supachokchujai/glove-sign-languag-/thesis.pdf

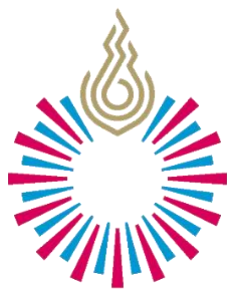
[picture p7: figure]

### ถุงมือแปลภาษามือ (ข้างเดียว) (SINGLE-HAND SIGN LANGUAGE TRANSLATOR GLOVE)

### โดย นาย ศุภโชค ชูใจ

### ปริญญานิพนธ์นี้เป็นส่วนหนึ่งของการศึกษาตามหลักสูตร วิศวกรรมศาสตรบัณฑิต สาขาวิชาวิศวกรรมคอมพิวเตอร์ วิทยาลัยวิศวกรรมศาสตร์ มหาวิทยาลัยรังสิต ปีการศึกษา 2568

ปริญญานิพนธ์เรื่อง
ถุงมือแปลภาษามือ (ข้างเดียว) (SINGLE-HAND SIGN LANGUAGE TRANSLATOR GLOVE)

โดย
นาย ศุภโชค ชูใจ 6505918

ได้รับการพิจารณาให้เป็นส่วนหนึ่งของการศึกษาตามหลักสูตร วิศวกรรมศาสตรบัณฑิต สาขาวิชาวิศวกรรมคอมพิวเตอร์ วิทยาลัยวิศวกรรมศาสตร์ มหาวิทยาลัยรังสิต ปีการศึกษา 2568

| ประธานกรรมการ
(ดร. ชนินท์ วงษ์ใหญ่)
| กรรมการ
(รศ.ดร. รง ภู่พวงไพโรจน์)
| กรรมการและอาจารย์ที่ปรึกษา
(ดร. อภิรักษ์ ภักดีวงษ์)

(ดร. ชนินท์วงษ์ใหญ่)
หัวหน้าหลักสูตรวิศวกรรมศาสตรบัณฑิต สาขาวิชาวิศวกรรมคอมพิวเตอร์
วันที่ | เดือน | พ.ศ |

### ถุงมือแปลภาษามือ (ข้างเดียว) (SINGLE-HAND SIGN LANGUAGE TRANSLATOR GLOVE)

### โดย นาย ศุภโชค ชูใจ 6505918

### ปริญญานิพนธ์นี้เป็นส่วนหนึ่งของการศึกษาตามหลักสูตร วิศวกรรมศาสตรบัณฑิต สาขาวิชาวิศวกรรมคอมพิวเตอร์ วิทยาลัยวิศวกรรมศาสตร์ มหาวิทยาลัยรังสิต ปีการศึกษา 2568

ข

ชื่อ | : นาย ศุภโชค ชูใจ | รหัส : 6505918
เรื่อง | : ถุงมือแปลภาษามือ (ข้างเดียว)
อาจารย์ที่ปรึกษา | : ดร. อภิรักษ์ ภักดีวงษ์, 134 หน้า
ค าส าคัญ | : ถุงมือแปลภาษามือ, ปัญญาประดิษฐ์, โครงข่ายประสาทเทียม, อีเอสพี32,
| ภาษามืออเมริกัน,

บทคัดย่อ

การสื่อสารที่ยากล าบากระหว่างผู้พิการทางการได้ยิน ไม่สามารถสื่อสารกับบุคคลทั่วไปได้ส่งผล กระทบโดยตรงต่อการด าเนินชีวิตและการเข้าสังคม ปริญญานิพนธ์ฉบับนี้จึงเสนอการออกแบบและ พัฒนา ถุงมืออัจฉริยะส าหรับแปลภาษามือแบบข้างเดียว ซึ่งเป็นอุปกรณ์อ านวยความสะดวกที่พัฒนาบน พื้นฐานของปัญญาประดิษฐ์ เพื่อมุ่งเน้นการใช้งานจริงและช่วยลดอุปสรรคด้านการสื่อสารให้แก่ผู้ใช้งาน ได้อย่างมีประสิทธิภาพ
ถุงมือแปลภาษามือ (ข้างเดียว) สามารถจ าแนกท ่าทางภาษามืออเมริกันตัวอักษร A ถึง Z รวมถึงค าศัพท์ที่ใช้บ่อยอย่าง Hello, Thank you, I love you, Yes และ No และแสดงผลเป็นข้อความ บนเว็บแอปพลิเคชัน ระบบการท างานของ ถุงมือแปลภาษามือข้างเดียว ใช้ไมโครคอนโทรลเลอร์ ESP32 อ่านค่าจากเซนเซอร์ตรวจจับการโค้งงอของนิ้วมือ ร่วมกับเซนเซอร์ MPU6050 ที่วัดความเร่งและองศา การหมุนบริเวณข้อมือ และส่งข้อมูลแบบไร้สายผ่านโปรโตคอล UDP ในรูปแบบ JSON ขนาด 60 เฟรม ต่อท่าทาง ข้อมูลจะถูกประมวลผลด้วยโครงข่ายประสาทเทียมหลายชั้น (Multi-Layer Perceptron) ที่ สร้างขึ้นด้วยไลบรารี Scikit-learn และส่งผลลัพธ์ไปแสดงผลผ่านเฟรมเวิร์ก Flask
จากการทดลองสามารถจ าแนกท่าทางภาษามือได้จริง โดยทดสอบท าท่าทางแต่ละรูปแบบซ ้า รูปแบบละ 30 ครั้ง เพื่อน าผลลัพธ์การทดสอบทั้งหมดมาประมวลผลและค านวณหาค่าความแม่นย าเฉลี่ย ซึ่งพบว่าระบบมีความแม่นย าในการจ าแนกท่าทางภาษามือเฉลี่ยคิดเป็นร้อยละ 96.02 อีกทั้งตัวระบบยัง สามารถตอบสนองต่อการเคลื่อนไหวได้อย่างรวดเร็ว มีความหน่วงเวลาต ่า และสามารถแปลสัญลักษณ์ ภาษามือออกมาเป็นข้อความแสดงผลบนหน้าจอเว็บแอปพลิเคชันได้อย่างราบรื่นและถูกต้อง ซึ่งแสดงให้ เห็นว่าระบบถุงมืออัจฉริยะที่พัฒนาขึ้น นี้มีความเสถียรและมีความพร้อมสูงในการน าไปประยุกต์ใช้งาน จริงในเชิงสังคม เหมาะส าหรับการน าไปพัฒนาต่อยอดเพื่อใช้งานจริงต่อไป

ค

Name | : Mr. Supachok Chujai | ID : 6505918
Title | : Single-Hand Sign Language Translator Glove
Advisor | : Apirak Pakdeewong, 134 Pages
Keywords | : Sign Language Translation Glove, Artificial Intelligence,
Neural Network, ESP32, American Sign Language

Abstract

The communication barrier faced by individuals with hearing impairments in interacting with the general public directly affects their daily life and social participation. This thesis therefore proposes the design and development of a Smart Glove for Single-Hand Sign Language Translation, an assistive device built on artificial intelligence, aimed at practical real-world application and effectively reducing communication barriers for users.
The single-hand sign language translation glove is capable of classifying American Sign Language gestures for letters A through Z, as well as frequently used words such as "Hello," "Thank you," "I love you," "Yes," and "No," and displaying the results as text on a web application. The system operates using an ESP32 microcontroller to read data from flex sensors that detect finger bending, together with an MPU6050 sensor that measures wrist acceleration and rotational angle. Data is transmitted wirelessly via the UDP protocol in JSON format, consisting of 60 frames per gesture. The collected data is then processed using a Multi-Layer Perceptron (MLP) neural network built with the Scikit-learn library, and the resulting output is displayed through the Flask framework. Experimental results demonstrate that the system can accurately classify real sign language gestures. Each gesture was tested 30 times, and the results were aggregated to calculate the average accuracy, which was found to be 96.02%. Furthermore, the systemresponds to hand movements quickly with low latency and is able totranslate sign language symbols into text displayed on the web application smoothly and accurately. These results indicate that the developed smart glove system is stable and ready for practical, real-world social application, and is well-suited for further development toward actual deployment.

ง

กิตติกรรมประกาศ

ปริญญานิพนธ์ฉบับนี้ส าเร็จลุล่วงได้ด้วยความอนุเคราะห์และการสนับสนุนจากบุคคลหลาย ฝ่าย คณะผู้จัดท าขอขอบคุณคณะกรรมการสอบปริญญานิพนธ์ทุกท่าน รวมถึงคณาจารย์ในภาควิชา วิศวกรรมคอมพิวเตอร์ที่ได้กรุณาให้แนวทาง ค าแนะน า และข้อเสนอแนะอันเป็นประโยชน์ในการ ปรับปรุงปริญญานิพนธ์ฉบับนี้ให้มีความสมบูรณ์ยิ่งขึ้น
ขอขอบคุณ ดร.อภิรักษ์ ภักดีวงษ์อาจารย์ที่ปรึกษาปริญญานิพนธ์ ที่ได้กรุณาให้ค าแนะน า และข้อเสนอแนะอย่างใกล้ชิดตลอดระยะเวลาการด าเนินงาน ทั้งในด้านแนวคิดของโครงงาน การ ออกแบบและพัฒนาระบบ รวมถึงการจัดท ารูปเล่มปริญญานิพนธ์ให้เป็นไปตามมาตรฐานที่ก าหนด ขอขอบคุณ รศ.ดร. ดวงอาทิตย์ศรีมูล ที่ให้ค าแนะน าด้านการต่อวงจร ขอขอบคุณครอบครัวและญาติมิตรทุกท่าน ที่ได้ให้ค าแนะน าต่างๆในการท างาน
ขอขอบคุณ กลุ่มฐานแฟนคลับนายศิวะ ชมแสงสีเสียง เพื่อนผู้คอยให้ก าลังใจและดูแลเอาใจ ใส่ตลอดระยะเวลาการจัดท าปริญญานิพนธ์ฉบับนี้

ศุภโชค ชูใจ
ผู้เขียน

จ

สารบัญ

หน้า
บทคัดย่อภาษาไทย | ข
บทคัดย่อภาษาอังกฤษ | ค
กิตติกรรมประกาศ | ง
สารบัญ | จ
สารบัญตาราง | ฎ
สารบัญรูป | ฐ

ฉ

สารบัญ (ต่อ)

บทที่ 2 (ต่อ) | หน้า

2.1.4 การจ าแนกประเภทท่าทางในโครงงาน (Classification of Gestures) .........8

ช

สารบัญ (ต่อ)

บทที่ 2 (ต่อ) | หน้า

ซ

สารบัญ (ต่อ)

บทที่ 2 (ต่อ) | หน้า

ฌ

สารบัญ (ต่อ)

บทที่ 3 (ต่อ) | หน้า

ญ

สารบัญ (ต่อ)

บรรณานุกรม | 123
ภาคผนวก ก.โค้ดการเทรนการแปลภาษามือ | 124
ข.โค้ดการท างานของแอปพิเคชั่นท านายผลภาษามือ | 126
ค.โค้ดการเทรนการส่งข้อมูล | 128
ง.โค้ดการเทรนการเก็บข้อมูล | 132
ประวัติผู้เขียน | 134

ฎ

สารบัญตาราง

หน้า
ตารางที่
1.1 รายชื่ออุปกรณ์ | 4
1.2 แผนการด าเนินงานและระยะในการปฏิบัติงาน | 5
2.1 ภาษามือและการสะกดนิ้วมือ | 10
3.1 รายละเอียดขาของ Flex Sensor | 56
3.2 รายละเอียดขาของ MPU 6050 | 56
3.3 โครงสร้างชุดข้อมูล | 62
3.4 รูปแบบการเก็บข้อมูล Flex Sensor | 66
3.5 รูปแบบการเก็บข้อมูลความเร่ง Accelerometer ของ MPU6050 | 68
3.6 รูปแบบการเก็บข้อมูลความเร็วเชิงมุม Gyroscope ของ MPU6050 | 69
4.1 ผลการทดสอบการแปลตัวอักษร A | 88
4.2 ผลการทดสอบการแปลตัวอักษร B | 89
4.3 ผลการทดสอบการแปลตัวอักษร C | 89
4.4 ผลการทดสอบการแปลตัวอักษร D | 90
4.5 ผลการทดสอบการแปลตัวอักษร E | 91
4.6 ผลการทดสอบการแปลตัวอักษร F | 91
4.7 ผลการทดสอบการแปลตัวอักษร G | 92
4.8 ผลการทดสอบการแปลตัวอักษร H | 93
4.9 ผลการทดสอบการแปลตัวอักษร I | 93
4.10 ผลการทดสอบการแปลตัวอักษร J | 94
4.11 ผลการทดสอบการแปลตัวอักษร K | 95
4.12 ผลการทดสอบการแปลตัวอักษร L | 95
4.13 ผลการทดสอบการแปลตัวอักษร M | 96
4.14 ผลการทดสอบการแปลตัวอักษร N | 97
4.15 ผลการทดสอบการแปลตัวอักษร O | 97
4.16 ผลการทดสอบการแปลตัวอักษร P | 98
4.17 ผลการทดสอบการแปลตัวอักษร Q | 99

ฏ

สารบัญตาราง (ต่อ)

หน้า
ตารางที่
4.18 ผลการทดสอบการแปลตัวอักษร R | 99
4.19 ผลการทดสอบการแปลตัวอักษร S | 100
4.20 ผลการทดสอบการแปลตัวอักษร T | 101
4.21 ผลการทดสอบการแปลตัวอักษร U | 101
4.22 ผลการทดสอบการแปลตัวอักษร V | 102
4.23 ผลการทดสอบการแปลตัวอักษร W | 103
4.24 ผลการทดสอบการแปลตัวอักษร X | 103
4.25 ผลการทดสอบการแปลตัวอักษร Y | 104
4.26 ผลการทดสอบการแปลตัวอักษร Z | 105
4.27 ผลการทดสอบการแปลค าว่า Hello | 105
4.28 ผลการทดสอบการแปลค าว่า Thank you | 106
4.29 ผลการทดสอบการแปลตัวอักษร I love you | 107
4.30 ผลการทดสอบการแปลค าว่า Yes | 107
4.31 ผลการทดสอบการแปลค าว่า No | 108
4.32 ผลการแสดงการจ าแนกท่าทาง | 109

ฐ

สารบัญรูป

หน้า
รูปที่
2.1 การสะกดนิ้วมือ | 8
2.2 ท่าทางแบบหยุดนิ่ง | 9
2.3 ท่าทางแบบเคลื่อนไหว | 9
2.4 ต าแหน่ง PIN ESP32 | 17
2.5 โครงสร้างของ Flexsensor | 18
2.6 ทิศทางการหมุนของ MPU6050 | 20
2.7 โครงสร้าง UDP | 24
2.8 เปรียบเทียบ AI, Machine Learning, Deep Learning | 26
2.9 การน า AI มาใช้ในด้านอุตสาหกรรม | 29
2.10 การเรียนรู้ของ Machine Learning | 31
2.11 การเรียนรู้ของ Deep Learning | 32
2.12 โครงข่ายประสาทเทียม | 33
2.13 โครงสร้าง MLP | 33
2.14 Backpropagation | 34
2.15 การติดตั้ง Arduino IDE | 38
2.16 การเลือกโฟลเดอร์ที่จะใช้เก็บไฟล์ | 39
2.17 การติดตั้ง Arduino IDE | 39
2.18 การติดตั้ง Arduino IDE สมบูรณ์ | 40
2.19 หน้าต่าง Arduino IDE | 40
2.20 การติดตั้ง Visual Studio Code | 41
2.21 การเลือกโฟลเดอร์ที่จะใช้เก็บไฟล์ | 42
2.22 โฟลเดอร์เมนู Start ส าหรับโค้ด Visual Studio | 42
2.23 ก าหนดค่าการติดตั้ง | 43
2.24 ยืนยันการติดตั้ง | 43
2.25 การติดตั้ง Visual Studio | 44
2.26 การติดตั้ง Visual Studio สมบูรณ์ | 44

ฑ

สารบัญรูป (ต่อ)

หน้า
รูปที่
2.27 หน้าต่าง Visual Studio Code | 45
2.28 ตัวอย่างการใช้งาน Python | 46
2.29 ติดตั้ง Numpy | 46
2.30 เรียกใช้Numpy | 47
2.31 ตัวอย่างการใช้งาน Numpy | 47
2.32 ติดตั้ง Flask | 47
2.33 เรียกใช้งาน Flask | 47
2.34 ตัวอย่างการใช้งาน Flask | 48
2.35 ติดตั้ง Scikit learn | 48
2.36 เรียกใช้Scikit learn | 48
2.37 ตัวอย่างการใช้งาน Scikit learn | 48
2.38 ติดตั้ง Pandas | 49
2.39 เรียกใช้Pandas | 49
2.40 ตัวอย่างการใช้งาน Pandas | 50
2.41 ติดตั้ง Socket Library | 50
2.42 เรียกใช้Socket | 50
2.43 ตัวอย่างการใช้งาน Socket | 51
2.44 ตัวอย่างโค้ดของ Client | 51
2.45 Server | 52
2.46 Client | 52
3.1 การออกแบบวงจร | 55
3.2 Flowchart การท างานของระบบ | 57
3.3 Flex Sensor | 58
3.4 MPU 6050 | 59
3.5 ESP32 | 59
3.6 การติดตั้ง Flex Sensor | 60

ฒ

สารบัญรูป (ต่อ)

หน้า
รูปที่
3.7 ติดตั้ง ESP32 และ MPU6050 ลงบนบอร์ด | 60
3.8 บัดกรีอุปกรณ์ทั้งหมด | 61
3.9 ขั้นตอนการเก็บข้อมูล | 64
3.10 โค้ดตั้งค่า UDP | 64
3.11 โค้ดล้าง Buffer | 65
3.12 โค้ดรวบรวมข้อมูล | 65
3.13 โค้ดการจัดเก็บข้อมูล | 65
3.14 Flowchart การเทรนโมเดล | 72
3.15 โครงสร้างโมเดล | 73
3.16 โค้ดส าหรับน าเข้าไลบรารี | 74
3.17 โค้ดการก าหนดข้อมูลน าเข้า | 75
3.18 โค้ดจัดรูปแบบข้อมูลให้พร้อมส าหรับการเทรน | 75
3.19 โค้ดการแบ่งข้อมูลเป็น Train และ Test | 76
3.20 โค้ดส าหรับการปรับสเกล | 77
3.21 โค้ดส าหรับการสร้างโมเดล | 77
3.22 เป็นโค้ดสร้างแผนภาพ Confusion Matrix | 78
3.23 กราฟประเมิน (Confusion Matrix) | 79
3.24 โค้ดส าหรับการบันทึกโมเดล | 80
3.25 ไฟล์ที่ได้จากการเทรน | 80
3.26 โค้ดส าหรับน าเข้าไลบรารี | 81
3.27 โค้ดส าหรับก าหนดตัวแปร | 82
3.28 โค้ดส าหรับการโหลดโมเดล | 82
3.29 โค้ดส าหรับก าหนดรูปแบบของ Template | 83
3.30 โค้ดส าหรับสร้างช่องทางรับข้อมูลจาก ESP32 | 83
3.31 โค้ดส าหรับรับและแปลงข้อมูล | 84
3.32 โค้ดส าหรับการท านายผลลัพธ์ | 84

ณ

สารบัญรูป (ต่อ)

หน้า
รูปที่
4.1 ถุงมือต้นแบบที่พัฒนาขึ้น | 87
4.2 หน้าต่าง Web Application | 87

บทที่1
บทน า

### 1.1 ที่มาและความส าคัญของปัญหา

การสื่อสารเป็นปัจจัยพื้นฐานที่ส าคัญในการด ารงชีวิตและการอยู่ร่วมกันในสังคม อย่างไรก็ตาม ผู้ ที่มีความบกพร่องทางการได้ยินหรือการพูด (Deaf and Hard of Hearing Community) จะประสบ ปัญหาและอุปสรรคในการสื่อสารร่วมกับบุคคลในสังคมเนื่องจากความแตกต่างทางภาษา โดยภาษามือ (Sign Language) ซึ่งเป็นเครื่องมือหลักในการสื่อสารของพวกเขานั้น ไม่เป็นที่เข้าใจอย่างแพร่หลายใน บุคคลทั่วไป ส่งผลให้เกิดช่องว่างในการสื่อสาร การเข้าถึงบริการสาธารณะ และโอกาสในการประกอบ อาชีพ การพึ่งพาล ่ามภาษามือนั้นมีข้อจ ากัดทั้งในด้านค่าใช้จ่ายและความไม ่สะดวกในการเรียกใช้ บริการในสถานการณ์เร่งด่วน
ในปัจจุบัน เทคโนโลยีสิ่งอ านวยความสะดวก (Assistive Technology) ได้เข้ามามีบทบาทในการ แก้ปัญหานี้ งานวิจัยส่วนใหญ่นิยมใช้เทคโนโลยีคอมพิวเตอร์วิทัศน์ (Computer Vision) ผ่านกล้อง เพื่อแปลภาษามือ แต่มีข้อจ ากัดเรื่องสภาพแสง มุมกล้อง และความเป็นส่วนตัว ในขณะที่เทคโนโลยี อุปกรณ์สวมใส ่ (Wearable Device) เช ่น ถุงมืออัจฉริยะ (Smart Glove) สามารถตรวจจับการ เคลื ่อนไหวของนิ้วมือได้โดยตรงและมีความแม่นย าสูงกว่าในสภาพแวดล้อมที ่หลากหลาย แต ่ทว่า อุปกรณ์ที่มีอยู่ในท้องตลาดหรือในงานวิจัยเดิมจะมีการเชื่อมต่อแบบมีสาย (Wired) ซึ่งจ ากัดระยะการ เคลื่อนไหว หรือมีต้นทุนในการผลิตสูง
จากปัญหาดังกล่าว คณะผู้จัดท าจึงมีแนวคิดที่จะพัฒนา "ระบบแปลภาษามือเป็นข้อความและ เสียงแบบไร้สายโดยใช้โครงข่ายประสาทเทียม" โดยประยุกต์ใช้ไมโครคอนโทรลเลอร์ ESP32 ที่มีราคา ประหยัดและรองรับการเชื ่อมต ่อไร้สาย (Wi-Fi) ร ่วมกับเซนเซอร์ตรวจจับการงอของนิ้ว (Flex Sensors) และเซนเซอร์ตรวจจับการเคลื่อนไหว (IMU) ข้อมูลจากถุงมือจะถูกส่งผ่านโปรโตคอล UDP ไปยังคอมพิวเตอร์เพื่อประมวลผลด้วยโมเดลปัญญาประดิษฐ์แบบโครงข่ายประสาทเทียมหลายชั้น (Multi-layer Perceptron) ที่พัฒนาด้วย Scikit-learn และแสดงผลการแปลผ่านเว็บแอปพลิเคชัน เพื่อสร้างต้นแบบนวัตกรรมที่ช่วยลดช่องว่างในการสื่อสาร ใช้งานสะดวก และมีประสิทธิภาพ

2

### 1.2 วัตถุประสงค์โครงงาน

1. เพื่อพัฒนา ถุงมือแปลภาษามือ ที่สามารถตรวจจับการเคลื่อนไหวของมือและนิ้ว
2. เพื ่อพัฒนาโมเดลปัญญาประดิษฐ์ (AI) ประเภทโครงข ่ายประสาทเทียม (Multi-layer Perceptron Classifier) ส าหรับจ าแนกท่าทางภาษามือจากข้อมูลเซนเซอร์
3. เพื่อเป็นเครื่องมือช่วยสื่อสารระหว่างผู้พิการทางการได้ยินกับบุคคลทั่วไป ลดช่องว่างทางการ สื่อสาร
4. เพื่อพัฒนาระบบแสดงผลผ่านเว็บแอปพลิเคชันที่สามารถแสดงผลลัพธ์การแปลเป็นข้อความได้

### 1.3 ขอบเขตโครงงาน

1. ใช้บอร์ดไมโครคอนโทรลเลอร์ESP32 เป็นตัวส่งข้อมูล
2. ใช้Flex Sensors จ านวน 5 ชิ้น เพื่อวัดค่าการงอของนิ้วมือทั้ง 5 นิ้ว
3. ใช้เซนเซอร์MPU6050 (Accelerometer & Gyroscope) จ านวน 1 ชิ้น เพื่อวัดระนาบและ การเคลื่อนไหวของข้อมือ
4. ใช้Flask ส าหรับพัฒนาเว็บและแสดงผลโดยมีตัวควบคุมในการกดแปล
5. รองรับเฉพาะท่าทางมือเดียว ได้แก่ A-Z และค าศัพท์ (Hello,Thank you, I love you,Yes ,no)
6. สามารถท านายผลท่าทางภาษามือจากค่า Flex sensorและ MPU 6050 โดยใช้MLP

### 1.4 ประโยชน์และการน าไปใช้งาน

1. ช่วยให้ผู้พิการทางการได้ยินและการพูดสามารถ สื่อสารกับบุคคลทั่วไปได้สะดวกและรวดเร็วขึ้น
2. ลดความเข้าใจผิดและอุปสรรคด้านการสื่อสาร ท าให้เกิด ความเท่าเทียมในสังคม
3. เป็นสื่อการเรียนรู้ภาษามือส าหรับบุคคลทั่วไปที่ต้องการเรียนรู้การสื่อสารกับผู้พิการ
4. ใช้ใน สถานศึกษา เพื่อช่วยนักเรียน/นักศึกษาที่มีความบกพร่องทางการได้ยินในการเรียน ร่วมกับบุคคลทั่วไป
5. สามารถพัฒนาต่อยอดเป็น แอปพลิเคชันบนมือถือ ที่เชื่อมต่อกับถุงมือ เพื่อเพิ่มความสะดวก และรองรับหลายภาษา

### 1.5 อุปกรณ์ที่ใช้งานและงบประมาณ

### 1.5.1 Hardware

- Notebook Asus TUF Gaming F17 / Intel Core i5-11400H / NVIDIA GeForce RTX 3050 / RAM 8GB DDR4 / SSD 512GB

3

- ESP 32 Microcontroller ใช้ส าหรับประมวลผลข้อมูลของเซ็นเซอร์และสื่อสารกับ คอมพิวเตอร์ด้วย WiFi
- Flex sensors 2.2" ใช้ตรวจวัดการงอของนิ้วมือ
- MPU6050 ใช้ส าหรับก าหนดต าแหน่งของมือ
- ถุงมือ
- สายจัมเปอร์
- ตัวต้านทาน 10 kΩ

### 1.5.2 Software

- Visual Studio Code ในการเขียนและออกแบบหน้า UI ของเว็บ ภาษา Python
- ภาษาโปรแกรม Python ส าหรับเขียนชุดค าสั่งควบคุมระบบ และใช้พัฒนาแอปพลิเค ชันร่วมกับระบบแสดงผล
- Pandas เป็นไลบรารีในภาษา Python ที่ใช้ส าหรับการจัดการและวิเคราะห์ข้อมูลใน รูปแบบของตารางหรือ DataFrame
- NumPy ไลบรารีโอเพนซอร์สใน Python ที ่ใช้ส าหรับการค านวณทางคณิตศาสตร์ และการจัดการข้อมูลเชิงตัวเลข ในการหางานกับอาร์เรย์หลายมิติและเมทริกซ์
- Arduino IDE คือโปรแกรมพัฒนาและอัปโหลดโค้ดไปยัง microcontroller โดย รองรับภาษา C/C++ และออกแบบมาเพื่อใช้งานด้านไมโครคอนโทรลเลอร์
- CSS ในก าหนดรูปแบบการแสดงผลของหน้าเว็บ เช ่น สี ตัวอักษร และการจัดวาง องค์ประกอบ
- HTML ส าหรับสร้างและจัดโครงสร้างเนื้อหาบนหน้าเว็บเพจ
- Scikit-learn เป็นไลบรารีของภาษา Python ส าหรับการเรียนรู้ของเครื ่อง ที ่รวม เครื่องมือส าหรับการจ าแนก การถดถอย การจัดกลุ่ม และการประเมินโมเดล
- Neural Network เป็นอัลกอริทึมการเรียนรู้ของเครื่องที่ใช้ส าหรับการจ าแนกข้อมูล โดยหาขอบเขตที่เหมาะสมที่สุดระหว่างกลุ่มข้อมูล
- Flask เป็นเครื่องมือของภาษา Python ส าหรับสร้างและจัดการเว็บแอปพลิเคชันแบบ ง่ายและรวดเร็ว โดยใช้สถาปัตยกรรมแบบไมโครเฟรมเวิร์ก
- JavaScript ในการเขียนโปรแกรมที่ใช้ส าหรับเพิ่มความโต้ตอบ

4

### 1.5.3 Budget sheet

การพัฒนาถุงมือแปลภาษามือข้างเดียวนี้ได้มีการจัดซื้ออุปกรณ์ขึ้นเพื่อให้การพัฒนาเป็นไป ด้วยความสะดวก และตามขอบเขตของโครงงาน มีรายละเอียดดังตารางที่ 1.1

ตารางที่ 1.1 รายชื่ออุปกรณ์
ล าดับ | รายการวัสดุ | จ านวน (หน่วย) | ค่าใช้จ่าย(บาท) | หมายเหตุ
| | Hardware
1 | Asus TUF Gaming F17 | 1 | 34,990 | -
2 | Flex sensors 2.2" | 5 | 595 | -
3 | MPU6050 | 1 | 80 | -
4 | ถุงมือ | 1 | 36 | -
5 | สายจัมเปอร์ | 20 | 22 | -
Software
1 | Visual Studio Code 1.92 | 1 | - | freeware
2 | Python 3.14 | 1 | - | freeware
3 | Pandas 2.3.3 | 1 | - | freeware
4 | NumPy 2.3.2 | 1 | - | freeware
5 | Arduino IDE 2.0 | 1 | - | freeware
6 | CSS | 1 | - | freeware
7 | HTML | 1 | - | freeware
8 | Scikit-learn 1.7.2 | 1 | - | freeware
9 | Neural network | 1 | - | freeware
10 | Flask 3.1 | 1 | - | freeware
11 | JavaScript | 1 | - | freeware

### 1.6 แผนการด าเนินงาน

การวางแผนด าเนินงานเริ่มต้นจากการศึกษาองค์ประกอบ ที่จ าเป็นส าหรับการท าโครงงาน ได้แก่ การศึกษาระบบการท างานของโครงงาน รวมไปถึงการศึกษาและเรียนรู้ภาษาต่างๆ หลังจากเสร็จ ขั้นตอนการศึกษาแล้ว จึงด าเนินการออกแบบโครงงานและ พัฒนาระบบพร้อมทั้งปรับปรุงแก้ไข เมื่อ

5

ขั้นตอนการพัฒนาเสร็จสิ้น จึงท าการทดสอบและปรับปรุงตามความจ าเป็น จากนั้นตรวจสอบความ เรียบร้อยทั้งหมดและสรุปผลโครงงาน ดังตารางที่ 1.2

ตารางที่ 1.2 แผนการด าเนินงานและระยะในการปฏิบัติงาน
แผนด าเนินงาน | ระยะเวลา (เดือน) ตั้งแต่ สิงหาคม 2568 - พฤษภาคม 2569
ส.ค. | ก.ย. | ต.ค. | พ.ย. | ธ.ค. | ม.ค. | ก.พ. | มี.ค. | เม.ย. | พ.ค.
1.เสนอหัวข้อ
2.1ศึกษาการท างาน ของชิ้นงาน

2.2ศึกษาเครื่องมือ และภาษา Python NumPy CSS HTML Flask C++ Scikit-learn SVM Pandas JavaScript

3.พัฒนาต้นแบบ และทดสอบการใช้ งาน

4.พัฒนาการเรียนรู้ ของ A.I.

5.ทดสอบและ ปรับปรุงแก้ไข

6.ออกแบบหน้า UI
7.แก้ไขปัญหา ข้อบกพร่อง

6

ตารางที่ 1.2 แผนการด าเนินงานและระยะในการปฏิบัติงาน (ต่อ)
แผนด าเนินงาน | ระยะเวลา (เดือน) ตั้งแต่ สิงหาคม 2568 - พฤษภาคม 2569
ส.ค. | ก.ย. | ต.ค. | พ.ย. | ธ.ค. | ม.ค. | ก.พ. | มี.ค. | เม.ย. | พ.ค.
8.ตรวจสอบความ เรียบร้อย

9.สรุปผลของ โครงงาน

10.จัดท ารูปเล่ม โครงงาน

บทที่2
ทฤษฎีและงานวิจัยที่เกี่ยวข้อง

### 2.1 ทฤษฎีเกี่ยวกับอุปสรรคการสื่อสารและภาษามือ

### 2.1.1 กระบวนการสื่อสาร (Communication Process)

ผู้ที่มีความบกพร่องทางการได้ยินสื่อสารกันด้วยภาษามือ (Sign Language) ซึ่งถ่ายทอด ความหมายผ่านท่าทางแทนเสียงพูด แต่ละประเทศมีภาษามือของตนเองที่มีโครงสร้างทางไวยากรณ์ และค าศัพท์แตกต่างกันไป เช่น ภาษามือไทย (TSL) และภาษามืออเมริกัน (ASL) โครงงานนี้เลือก พัฒนาโดยอ้างอิงภาษามืออเมริกัน เนื่องจากเป็นภาษามือที่มีผู้ใช้งานแพร่หลายที่สุดและมีชุดข้อมูล สาธารณะรองรับการวิจัยจ านวนมาก ท าให้สามารถเปรียบเทียบผลการทดลองกับงานอื่นได้

### 2.1.2 องค์ประกอบของภาษามือ (Parameters of Sign Language)

ในทางภาษาศาสตร์ ภาษามือไม่ได้เกิดจากการขยับมือโดยสุ่ม แต่ประกอบขึ้นจากหน ่วย ย่อย 5 ส่วนที่เรียกว่า The Five Parameters of ASL ได้แก่ รูปร่างมือ (Handshape), ทิศทางฝ่ามือ (Palm Orientation), การเคลื่อนไหว (Movement), ต าแหน่งของมือเทียบกับร่างกาย (Location) และการแสดงออกทางสีหน้า (Non-manual markers)
องค์ประกอบทั้งห้านี้เป็นตัวก าหนดโดยตรงว่าถุงมือในโครงงานนี้ต้องติดตั้งเซนเซอร์ชนิด ใดบ้างจึงจะครอบคลุมความหมายของท่าทาง กล่าวคือ รูปร่างมือและการเคลื่อนไหวสามารถวัดได้ ด้วย Flex Sensor และ IMU ในขณะที่การแสดงออกทางสีหน้านั้นอยู่นอกขอบเขตของโครงงานนี้ เนื่องจากถุงมือสามารถตรวจจับได้เฉพาะสัญญาณจากมือเท่านั้น

8

### 2.1.3 การสะกดนิ้วมือ (Finger Spelling)

การสะกดนิ้วมือ (Fingerspelling) คือการใช้รูปมือแทนตัวอักษรในภาษาพูด ซึ่งใช้ในกรณี ที่ค านั้นไม่มีท่าภาษามือเฉพาะ หรือใช้ส าหรับสะกดชื่อเฉพาะ ในภาษามืออเมริกัน การสะกดนิ้วมือใช้ มือเพียงข้างเดียว ซึ่งสอดคล้องพอดีกับแนวทางของถุงมือข้างเดียวที่โครงงานนี้พัฒนาขึ้น ดังรูปที่ 2.1

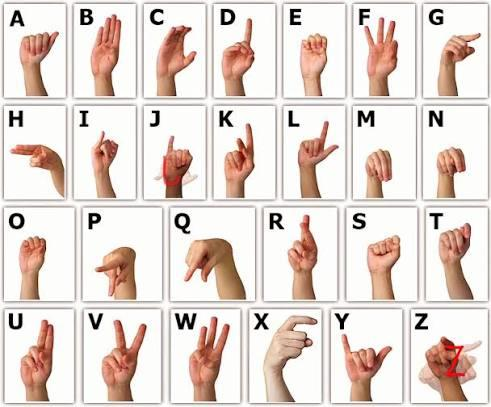
[picture p8: figure]

รูปที่ 2.1 การสะกดนิ้วมือ

### 2.1.4 การจ าแนกประเภทท่าทางในโครงงาน (Classification of Gestures)

ในการประมวลผลด้วยคอมพิวเตอร์ ท ่าทางภาษามือในขอบเขต A-Z และ ค าศัพท์ สามารถแบ่งออกเป็น 2 ประเภทหลัก คือ

9

1. ท ่าทางแบบหยุดนิ่ง (Static Gestures) คือท ่าทางที ่ไม ่มีการเคลื ่อนไหวของข้อมือ ในขณะแสดงความหมาย เพียงแค่จัดระเบียบนิ้วมือและค้างไว้ ดังรูปที่ 2.2

รูปที่ 2.2 ท่าทางแบบหยุดนิ่ง

2. ท่าทางแบบเคลื่อนไหว (Dynamic Gestures) คือท่าทางที่ต้องมีการเปลี่ยนต าแหน่ง หรือทิศทางของมือในระหว่างการท าท่าทาง ดังรูปที่ 2.3

รูปที่ 2.3 ท่าทางแบบเคลื่อนไหว

### 2.1.5 ความรู้ทั่วไปเกี่ยวกับภาษามือ (Sign Language)

ภาษามือ คือ ภาษาธรรมชาติที่ใช้ระบบการสื่อสารผ่านอวัจนภาษา แทนการใช้เสียง โดย เป็นเครื ่องมือส าคัญในการสื ่อสารของผู้บกพร ่องทางการได้ยิน ตลอดจนบุคคลทั ่วไปที ่ต้องการ ติดต่อสื่อสารร่วมกัน ภาษามือไม่ได้เป็นเพียงแค ่การท าท่าทางประกอบค าพูด แต่มีโครงสร้างทาง ไวยากรณ์ รูปประโยค และคลังค าศัพท์ที่เป็นเอกเทศและมีความสมบูรณ์ในตัวเอง ดังตารางที่ 2.1

10

ตารางที่ 2.1 ภาษามือและการสะกดนิ้วมือ
รูปแบบ | ตัวอักษร | ลักษณะท่าทาง | การเคลื่อนไหว
| A | ก ามือ นิ้วหัวแม่มือ เหยียดตรงแนบชิด ด้านข้างของนิ้วชี้ | นิ่ง
| B | แบมือ นิ้วทั้งสี่เรียงชิด กัน นิ้วหัวแม่มือพับงอ มาแตะที่ฝ่ามือ | นิ่ง
| C | ท ามือเป็นรูปตัว C นิ้ว ทั้งสี่เรียงชิดและโค้งงอ นิ้วหัวแม่มือโค้งรับ | นิ่ง
| E | พับนิ้วทั้งสี่ลงมาแตะที่ อุ้งมือ นิ้วหัวแม่มือพับ เก็บไว้ใต้นิ้วทั้งสี่ | นิ่ง
| d | ชูนิ้วขึ้นให้นิ้วหัวแตะ กับปลายนิ้วกลาง นาง และก้อยเป้นวงกลม | นิ่ง
| F | ปลายนิ้วชี้แตะปลาย นิ้วหัวแม่มือเป็น วงกลม นิ้วที่เหลือกาง ออก | นิ่ง

11

ตารางที่ 2.1 ภาษามือและการสะกดนิ้วมือ (ต่อ)
รูปแบบ | ตัวอักษร | ลักษณะท่าทาง | การเคลื่อนไหว
| G | ชูนิ้วชี้และนิ้วหัวแม่มือ ขนานกันชี้ไปด้านข้าง (คล้ายท่าจับของ) นิ้ว อื่นก าไว้ | นิ่ง
| H | ชูนิ้วชี้และนิ้วกลางคู่ กันชี้ไปด้านข้าง นิ้วหัวแม่มือซ่อนไว้ | นิ่ง
| I | ชูนิ้วก้อยขึ้นเพียงนิ้ว เดียว นิ้วอื่นก าไว้ | นิ่ง
| J | ท าท่าเหมือนตัว I | หมุนข้อมือวาด เป็นรูปตัว J ใน อากาศ
| K | ชูนิ้วชี้และนิ้วกลางเป็น รูปตัว V โดยมี นิ้วหัวแม่มือแทรกอยู่ ตรงกลาง | นิ่ง
| L | ชูนิ้วชี้และนิ้วหัวแม่มือ ตั้งฉากกันเป็นรูปตัว L | นิ่ง

12

ตารางที่ 2.1 ภาษามือและการสะกดนิ้วมือ (ต่อ)
รูปแบบ | ตัวอักษร | ลักษณะท่าทาง | การเคลื่อนไหว
| M | ก ามือ โดยให้3 นิ้ว (ชี้, กลาง, นาง) พาดทับ อยู่บนนิ้วหัวแม่มือ | นิ่ง
| N | ก ามือ โดยให้2 นิ้ว (ชี้, กลาง) พาดทับอยู่บน นิ้วหัวแม่มือ | นิ่ง
| O | ปลายนิ้วทั้ง 5 มาชน กันเป็นวงกลม | นิ่ง
| P | ท าท่าเหมือนตัว K แต่ คว ่ามือลงให้นิ้วชี้ชี้ลง พื้น | นิ่ง
| Q | ท าท่าเหมือนตัว G แต่ คว ่ามือลงให้นิ้วทั้งสอง ชี้ลงพื้น | นิ่ง
| R | ชูนิ้วชี้และนิ้วกลางไขว้ กัน | นิ่ง

13

ตารางที่ 2.1 ภาษามือและการสะกดนิ้วมือ (ต่อ)
รูปแบบ | ตัวอักษร | ลักษณะท่าทาง | การเคลื่อนไหว
| S | ก ามือแน่นนิ้วหัวแม่มือ พาดทับอยู่ด้านหน้า ของนิ้วชี้และนิ้วกลาง | นิ่ง
| T | ก ามือ โดยสอด นิ้วหัวแม่มือให้อยู่ ระหว่างนิ้วชี้และ นิ้วกลาง (ชูนิ้วชี้ทับ โป้ง) | นิ่ง
| U | ชูนิ้วชี้และนิ้วกลางชิด กันขึ้นฟ้า | นิ่ง
| V | ชูนิ้วชี้และนิ้วกลาง แยกออกจากกันเป็น รูปตัว V | นิ่ง
| W | ชู 3 นิ้ว (ชี้, กลาง, นาง) แยกออกจากกัน | นิ่ง

14

ตารางที่ 2.1 ภาษามือและการสะกดนิ้วมือ (ต่อ)
รูปแบบ | ตัวอักษร | ลักษณะท่าทาง | การเคลื่อนไหว
| X | ก ามือแล้วชูนิ้วชี้ขึ้น แต่งอปลายนิ้วลงมา เป็นตะขอ | นิ่ง

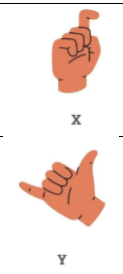
[picture p9: figure]

| Y | กางนิ้วหัวแม่มือและ นิ้วก้อยออก นิ้วที่ เหลือพับเก็บ | นิ่ง

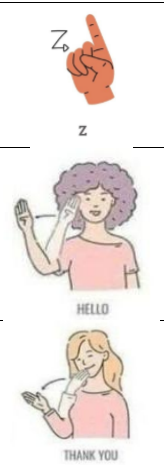
[picture p10: figure]

| Z | ชูนิ้วชี้ | วาดเป็นรูปตัว Z ในอากาศ
| Hello (สวัสดี) | แบมือ ปลายนิ้วแตะ บริเวณหน้าผากหรือ หางคิ้ว | ขยับมือออก จากหน้าผากไป ด้านข้างล าตัว เล็กน้อย
| Thank you (ขอบคุณ) | แบมือ (Open B) ปลายนิ้วแตะที่คาง | ยื่นมือออกจาก คางไปด้านหน้า คู่สนทนาและ ลดระดับลง เล็กน้อย

15

ตารางที่ 2.1 ภาษามือและการสะกดนิ้วมือ (ต่อ)
รูปแบบ | ตัวอักษร | ลักษณะท่าทาง | การเคลื่อนไหว
| I love you (ฉันรัก คุณ) | ชูนิ้วชี้และนิ้วกลางขึ้น 2 นิ้ว | นิ่ง
| Yes (ใช่) | ก านิ้วมือทั้งหมด หลวม ๆ (คล้าย ตัวอักษร S) แล้วขยับ ข้อมือผงกลงซ ้า ๆ | หักข้อมือขึ้น และลงซ ้าๆ
| No (ไม่ใช่) | ชูนิ้วโป้ง นิ้วชี้ และ นิ้วกลางขึ้น แล้วกด นิ้วชี้และนิ้วกลางลง มาแตะกับนิ้วโป้งซ ้า ๆ | น านิ้วชี้และ นิ้วกลางลงมา แตะกับ นิ้วหัวแม่มือ ซ ้าๆ

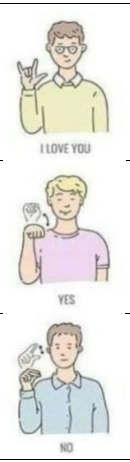
[picture p11: figure]

### 2.2 เทคโนโลยีการตรวจจับและแปลภาษามือที่เกี่ยวข้อง

งานวิจัยด้านการตรวจจับและแปลภาษามือในช่วงหลายปีที่ผ่านมาแบ่งออกได้เป็นสองแนวทาง หลัก คือ การตรวจจับด้วยคอมพิวเตอร์วิทัศน์ (Computer Vision) และการตรวจจับด้วยถุงมือติด เซนเซอร์ (Sensor-based Glove) ซึ่งแต่ละแนวทางมีจุดแข็งและข้อจ ากัดที่แตกต่างกัน

### 2.2.1 แนวทางการตรวจจับด้วยคอมพิวเตอร์วิทัศน์

Sánchez-Vicinaiz et al. (2024) พัฒนาระบบจ าแนกท่าทางการสะกดนิ้วมือของภาษา มือเม็กซิกัน โดยใช้ไลบรารี MediaPipe ร่วมกับโครงข่ายประสาทเทียมแบบคอนโวลูชัน (CNN) ผล การทดลองบนชุดทดสอบพบว่าโมเดลที่ดีที่สุดให้ความแม่นย า 83.63 เปอร์เซ็นต์ โดยผู้วิจัยระบุว่า ความแม่นย าที่ได้ยังผันผวนตามสภาพแสงและมุมกล้องที่ใช้ถ่ายภาพมือ ซึ่งเป็นข้อจ ากัดส าคัญของ แนวทางที่อาศัยกล้องเป็นอุปกรณ์รับข้อมูลหลัก งานวิจัยกลุ่มนี้แสดงให้เห็นว่าแม้ MediaPipe จะช่วย

16

ลดภาระการประมวลผลเมื่อเทียบกับการใช้ CNN วิเคราะห์พิกเซลทั้งภาพโดยตรง แต่ระบบยังคงต้อง พึ่งพาคุณภาพของภาพที่รับเข้ามาเป็นอย่างมาก

### 2.2.2 แนวทางการตรวจจับด้วยถุงมือติดเซนเซอร์

Amin, Rizvi, and Hossain (2022) ได้ทบทวนงานวิจัยที่ใช้เซนเซอร์ชนิดต่างๆ ในการ พัฒนาถุงมือแปลภาษามืออย่างครอบคลุม และชี้ให้เห็นว่าถุงมือที่ใช้ Flex Sensor ร่วมกับเซนเซอร์วัด ความเคลื่อนไหวสามารถให้ความแม่นย าในการจ าแนกท่าทางได้ตั้งแต่ประมาณ 80 ถึงมากกว่า 90 เปอร์เซ็นต์ ขึ้นอยู่กับจ านวนเซนเซอร์และไมโครคอนโทรลเลอร์ที่เลือกใช้ อย่างไรก็ตาม งานวิจัยส่วน ใหญ่ที่ทบทวนไว้ยังพบข้อจ ากัดร่วมกันสองประการ คือ การใช้ไมโครคอนโทรลเลอร์ที่มีสมรรถนะ
จ ากัด เช่น ATmega328 หรือ MSP430 ซึ่งประมวลผลได้ช้า และการใช้ Bluetooth เป็นช่องทาง สื่อสารไร้สายซึ่งมีระยะท าการสั้นกว่าการสื่อสารผ่าน Wi-Fi ข้อสังเกตเหล่านี้เป็นส่วนหนึ่งของเหตุผลที่ โครงงานนี้เลือกใช้ ESP32 ร่วมกับโปรโตคอล UDP ผ่าน Wi-Fi แทน

### 2.3 ไมโครคอนโทรลเลอร์ ESP32 (ESP32 Microcontroller)

Espressif Systems ได้พัฒนา ESP32 ซึ่งเป็นไมโครคอนโทรลเลอร์ประสิทธิภาพสูงที่รองรับ การสื่อสารแบบไร้สายทั้ง Wi-Fi และ Bluetooth ภายในชิปเดียว โดยออกแบบมาเพื่อรองรับการ พัฒนาอุปกรณ์ Internet of Things (IoT) ระบบสมาร์ตโฮม ระบบควบคุมอัตโนมัติ และระบบที่ต้องมี การเชื่อมต่อเครือข่ายอินเทอร์เน็ต
ESP32 ได้รับการพัฒนาต่อยอดจาก ESP8266 โดยเพิ่มประสิทธิภาพของหน่วยประมวลผล ความสามารถในการประมวลผลแบบหลายงาน (Multitasking) จ านวนขาอินพุตและเอาต์พุต (GPIO) รวมถึงรองรับอุปกรณ์ต่อพ่วง (Peripheral) ได้หลากหลาย เช่น ADC, DAC, PWM, UART, SPI และ I2C ท าให้ได้รับความนิยมอย่างแพร่หลายในงานวิจัยและการพัฒนาระบบสมองกลฝังตัว

### 2.3.1 คุณสมบัติทางเทคนิคและสถาปัตยกรรมหลัก

หน่วยประมวลผล (CPU) ใช้สถาปัตยกรรม Xtensa® LX6 (หรือ RISC-V ในรุ่นใหม่) แบบ Dual-core ความเร็วสูงสุด 240 MHz ให้ประสิทธิภาพการประมวลผลสูง (CoreMark ~1080) รองรับงานที่ต้องการความเร็วและการประมวลผลแบบคู่ขนาน
หน่วยความจ า มี SRAM ภายใน 520 KB และ ROM 448 KB รองรับการเชื่อมต่อ หน่วยความจ าภายนอกแบบ SPI Flash สูงสุด 16 MB และ PSRAM ส าหรับรองรับงานที่ใช้ หน่วยความจ าสูง

17

การเชื่อมต่อไร้สาย รวม Wi-Fi 802.11 b/g/n (2.4 GHz) และ Bluetooth (Dual-mode/BLE) ไว้ในชิปเดียว พร้อมระบบ RF Front-end ที่ออกแบบมาให้มีก าลังส่งสูงและประหยัด พลังงาน
สถาปัตยกรรมต่อพ่วง มีระบบจัดการ I/O ที่ยืดหยุ่น รองรับสัญญาณดิจิทัลและอนาล็อก จ านวนมาก ช่วยให้สามารถสื่อสารกับเซ็นเซอร์และโมดูลต่างๆ ได้โดยตรง

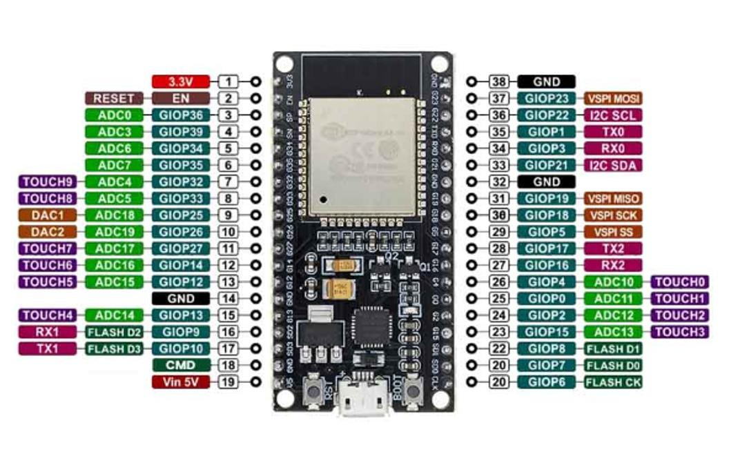
[picture p12: figure]

รูปที่ 2.4 ต าแหน่ง PIN ESP32

จากรูปที่ 2.4 แสดงการจัดเรียงขา GPIO ของ ESP32 แบบ 38 ขา ESP32 รุ่น 38 พิน มี ขาเชื่อมต่อ GPIO จ านวนมาก จัดเรียงเป็น 2 แถว แถวละ 19 ขา โดยสามารถแบ่งประเภทการใช้งาน ตามคุณสมบัติทางไฟฟ้าและฟังก์ชันพิเศษได้ดังนี้
ขาจ่ายไฟ ประกอบด้วยขาแรงดัน 3.3 โวลต์ (3.3V) ได้แก่ ขาที่ 1, ขาแรงดันไฟเข้า Vin (5V) ได้แก่ ขาที่ 19 และขากราวด์ (GND) ได้แก่ ขาที่ 14, 32 และ 38
ขาสื่อสารแบบ I2C ประกอบด้วย GPIO 21 ท าหน้าที่เป็น SDA และ GPIO 22 ท าหน้าที่ เป็น SCL ใช้ส าหรับการสื่อสารกับอุปกรณ์ภายนอก เช่น จอแสดงผลหรือเซ็นเซอร์ต่างๆ ขาสื่อสารแบบ SPI (VSPI) ประกอบด้วย GPIO 23 (MOSI), GPIO 19 (MISO), GPIO 18 (SCK) และ GPIO 5 (SS) ใช้ส าหรับการสื่อสารความเร็วสูงกับโมดูลอุปกรณ์ต่อพ่วง

18

ขาสื่อสารแบบ UART มีให้ใช้งานหลายพอร์ต ได้แก่ UART0 (GPIO 1, 3), UART1 (GPIO 9, 10 - เชื่อมต่อ Flash), และ UART2 (GPIO 16, 17) ใช้ส าหรับการสื่อสารแบบอนุกรมและการดีบัก ระบบ
ขา ADC และ DAC ESP32 รองรับการแปลงสัญญาณอนาล็อกเป็นดิจิทัล (ADC) หลาย ช่อง เช่น GPIO 36, 39, 34, 35, 32, 33, 25, 26, 27, 14, 12, 13, 15, 2, 4 และรองรับสัญญาณ ดิจิทัลเป็นอนาล็อก (DAC) จ านวน 2 ช่อง ได้แก่ GPIO 25 และ GPIO 26
ขา Touch Sensor ประกอบด้วย GPIO 32, 33, 27, 14, 12, 15, 2, 4 ส าหรับรองรับ ฟังก์ชันการสัมผัสแบบ capacitive

### 2.4 เซนเซอร์วัดความโค้งงอ (Flex Sensor)

Flex Sensor หรือเซนเซอร์ตรวจจับการงอ เป็นอุปกรณ์ที ่ใช้หลักการเปลี ่ยนแปลงค่าความ ต้านทานไฟฟ้าเมื่อตัวเซนเซอร์เกิดการโค้งงอ กล่าวคือในสภาวะปกติที่แผ่นเซนเซอร์วางตัวเรียบตรง ค่าความต้านทานจะอยู่ในระดับต ่าและค่อนข้างคงที่ แต่เมื่อใดที่มีแรงกระท าให้เซนเซอร์โค้งงอไปตาม มุมต่าง ๆ ค่าความต้านทานจะเปลี่ยนแปลงเพิ่มขึ้นตามระดับความโค้งนั้น ด้วยคุณสมบัตินี้เอง จึง สามารถน า Flex Sensor ไปใช้แปลงการเคลื่อนไหวเชิงกลให้กลายเป็นสัญญาณไฟฟ้าที่วัดค่าได้

### 2.4.1 โครงสร้างของ Flexsensor

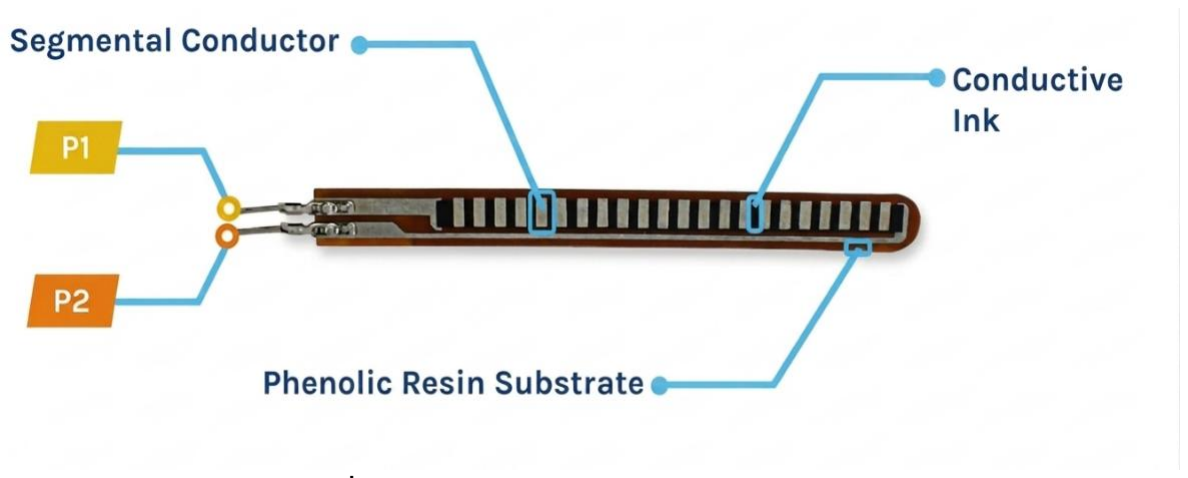
[picture p13: figure]

รูปที่ 2.5 โครงสร้างของ Flexsensor

19

จากรูปที่ 2.5 โครงสร้างของ Flexsensor แบ่งได้3 ส่วนคือ
1. Phenolic Resin Substrate (แผ่นฐานฟีนอลิกเรซิน) เป็นวัสดุที่ใช้เป็นโครงสร้างหลัก ของเซนเซอร์ มีลักษณะเป็นแผ่นบางยาว ท าหน้าที่รองรับชั้นตัวน าที่เคลือบอยู่ด้านบน วัสดุชนิดนี้ถูก เลือกใช้เพราะมีความยืดหยุ่นสูงแต่ยังคงความแข็งแรงในระดับหนึ่ง ทนทานต่อการงอซ ้าไปมาได้ดี
2. Conductive Ink (หมึกตัวน าไฟฟ้า) เคลือบอยู่บนผิวของแผ่นฐาน มองเห็นเป็นแถบสีเงิน เรียงตัวขวางตลอดความยาวของเซนเซอร์ในภาพ หมึกชนิดนี้จะท าจากคาร์บอนหรือวัสดุตัวน าผสม ท า หน้าที่เป็นตัวกลางในการน ากระแสไฟฟ้า และเป็นส่วนที่ค่าความต้านทานจะเปลี่ยนแปลงเมื่อเกิดการงอ
3. Segmental Conductor (ตัวน าแบบแบ่งช่วง) คือลักษณะการวางแถบตัวน าเป็นช่วง ๆ ต่อเนื่องกันตลอดความยาวของเซนเซอร์ (ดังจะเห็นเป็นแถบขีดสีเงินเรียงกันเป็นระยะในภาพ) การ ออกแบบลักษณะนี้ช่วยให้ค่าความต้านทานเปลี่ยนแปลงได้อย่างสม ่าเสมอและแปรผันตามองศาการโค้ง งอในแต่ละจุดของเซนเซอร์
4. ขั้วต่อสัญญาณ P1 และ P2 เป็นจุดเชื่อมต่อสายไฟสองเส้นที่ปลายด้านหนึ่งของเซนเซอร์ ใช้ส าหรับต่อเข้ากับวงจรภายนอกเพื ่ออ่านค ่าความต้านทานที่เปลี ่ยนแปลงไป โดย P1 และ P2 ท า หน้าที่เป็นขั้วบวกและขั้วลบ (หรือขั้วสัญญาณทั้งสองด้าน) ในการวัดค่าความต้านทานตลอดความยาว ของเซนเซอร์
เมื ่อเซนเซอร์ถูกงอ ระยะห ่างระหว ่างแถบตัวน าแต ่ละช ่วงบน Segmental Conductor จะ เปลี่ยนแปลงไป ท าให้ค่าความต้านทานที่วัดได้ระหว่างขั้ว P1 และ P2 มีค่าสูงขึ้นตามมุมการโค้งงอ ซึ่ง เป็นไปตามหลักการที่อธิบายไว้ในสมการ

### 2.4.2 วงจรแบ่งแรงดัน (Voltage Divider Circuit)

เนื ่องจากไมโครคอนโทรลเลอร์ไม ่สามารถอ่านค ่า ความต้านทาน (R) ที่ Flexsensor ส่งออกมาได้โดยตรง แต่อ่านได้เพียงค่า "แรงดันไฟฟ้า" (V) ดังนั้นจึงจ าเป็นต้องใช้วงจรแบ่งแรงดันเพื่อ แปลงค่าความต้านทานที่เปลี่ยนไปของ Flex Sensor ให้เป็นแรงดันไฟฟ้าที่เปลี่ยนไปดังสมการที่ 1

Vout = Vin ×

R2
R1 + R2

(1)

โดยที่
- Vin คือ แรงดันไฟเข้า (3.3V จาก ESP32)
- R1 คือ ค่าความต้านทานของ Flex Sensor (แปรผันตามการงอ)

20

- R2 คือ ตัวต้านทานคงที่ (Fixed Resistor) ที่น ามาต่อร่วม
- Vout คือ แรงดันไฟขาออกที่ส่งเข้าขา Analog ของ ESP32

### 2.5 เซนเซอร์วัดความเร่งและองศาการหมุน MPU6050

MPU6050 เป็นอุปกรณ์ตรวจจับความเคลื่อนไหวเชิงเฉื่อย (Inertial Measurement Unit: IMU) ที่ผลิตโดยบริษัท InvenSense ออกแบบให้รวมเซนเซอร์สองประเภทไว้ในวงจรรวม (Integrated Circuit) เดียวกัน ได้แก่ เซนเซอร์วัดความเร่ง 3 แกน (3-Axis Accelerometer) และเซนเซอร์วัด ความเร็วเชิงมุม 3 แกน (3-Axis Gyroscope) ท าให้สามารถตรวจจับลักษณะการเคลื ่อนไหวเชิง กายภาพของวัตถุในสามมิติได้พร้อมกันในชิปเดียว โดยส่งข้อมูลผ่านโปรโตคอลการสื่อสารแบบบัสสอง สาย (I2C Bus) ที่แรงดัน 3.3 โวลต์ดังรูปที่ 2.6

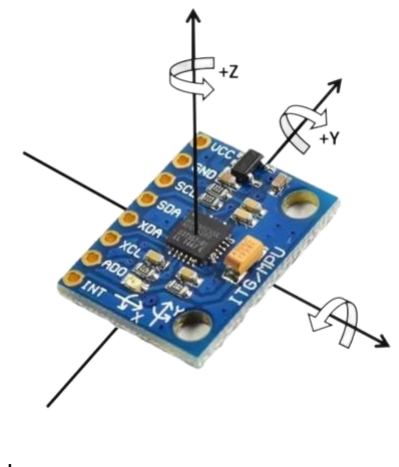
[picture p14: figure]

รูปที่ 2.6 ทิศทางการหมุนของ MPU6050

### 2.5.1 เซนเซอร์วัดความเร่ง (Accelerometer)

เซนเซอร์วัดความเร่งภายใน MPU6050 ท างานบนหลักการของระบบไมโครอิเล็กโตรเมคา นิกส์ (Micro-Electro-Mechanical Systems: MEMS) โดยมีมวลทดสอบขนาดเล็กมากแขวนลอยอยู่ บนโครงสร้างสปริงขนาดจิ๋ว เมื่ออุปกรณ์เกิดการเร่งหรือเบรก มวลทดสอบจะเคลื่อนที่สัมพัทธ์กับ โครงสร้าง ส ่งผลให้ระยะห ่างระหว ่างแผ ่นตัวเก็บประจุเปลี ่ยนไป วงจรภายในจะแปลงความ เปลี่ยนแปลงของความจุไฟฟ้านั้นให้กลายเป็นสัญญาณแรงดันไฟฟ้าดิจิทัล โดยวัดผลในแนวแกนพิกัด ทั้งสามแกน ดังนี้

21

- แกน X วัดความเร่งในแนวซ้าย-ขวา
- แกน Y วัดความเร่งในแนวหน้า-หลัง
- แกน Z วัดความเร่งในแนวขึ้น-ลง (รวมถึงแรงโน้มถ่วงโลกประมาณ 9.81 เมตรต่อ วินาทียกก าลังสอง)

### 2.5.2 การหาค่ามุมเอียงของเซนเซอร์วันความเร่ง

ในขณะที่ถุงมือหยุดนิ่งโดยไม่มีการเคลื่อนที่ เซนเซอร์ความเร่งจะยังคงตรวจจับแรงโน้มถ่วง โลกได้เสมอในรูปของแรงเร่งคงที่ขนาด 9.81 เมตรต่อวินาทียกก าลังสอง โดยค่าที่ปรากฏบนแต่ละแกน จะแตกต ่างกันไปตามมุมและทิศทางที ่มือหันอยู ่ ดังนั้นจึงสามารถน าค ่าความเร ่งในแต ่ละแกนมา ค านวณหามุมเอียง (Tilt Angle) ของถุงมือสวมใส่ได้ โดยอาศัยสมการฟังก์ชันตรีโกณมิติผกผันดัง สมการที่ 2 และ 3

θRoll = arctan (
Ay
√Ax
2 + Az
2
) | (2)

θPitcℎ = arctan (
−Ay
√Ax
2 + Az
2
) | (3)

โดยก าหนดให้Ax, AY, Az

คือค ่าความเร ่งที ่วัดได้ในแต ่ละแกนหลังผ ่าน กระบวนการปรับเทียบค่า (Calibration) แล้ว และ θRoll คือ การหมุนเอียงซ้าย-ขวา θPitcℎ คือ การก้ม-เงย

### 2.5.3 เซนเซอร์วัดความเร็วเชิงมุม (Gyroscope)

เซนเซอร์ไจโรสโคปภายใน MPU6050 ท างานบนหลักการของแรงโคริโอลิส (Coriolis Force) โดยมีโครงสร้างมวลสั่นไหว (Vibrating Mass) ที่ถูกขับเคลื่อนให้สั่นด้วยความถี่คงที่ เมื่อเกิด การหมุนเวียนรอบแกนใดแกนหนึ่ง แรงโคริโอลิสจะเหนี่ยวน าให้โครงสร้างสั่นออกนอกระนาบ ซึ่งวงจร ตรวจจับความจุจะแปลงขนาดของการเบี่ยงเบนนั้นให้กลายเป็นค่าอัตราการหมุน (Angular Rate) ใน หน่วยองศาต่อวินาที (°/s) ครอบคลุมสามแกนการหมุน ดังนี้
- แกน X การหมุนพลิกข้อมือซ้าย-ขวา
- แกน Y การหมุนตวัดข้อมือขึ้น-ลง

22

- แกน Z การหมุนเฉียงแนวราบซ้าย-ขวา

### 2.5.4 กระบวนการแปลงการเบี่ยงเบนเป็นค่าดิบ

การเบี่ยงเบนของมวลสั่นไหวจะไปเปลี่ยนระยะห่างระหว่างแผ่นตัวเก็บประจุคู่หนึ่ง ท าให้ค่า ความจุไฟฟ้า (Capacitance) สองด้านเกิดความต่างกัน ซึ่งสามารถแสดงความสัมพันธ์ได้ดังสมการที่ 4

C = ε ∙

A
d

(4)

โดยที่ ε คือค่าคงที่การอนุญาตทางไฟฟ้า (Permittivity), A คือพื้นที่หน้าตัดแผ่นตัวเก็บ ประจุ และ d คือระยะห่างระหว่างแผ่น เมื่อมวลเบี่ยงเบน ระยะ d ของด้านหนึ่งลดลงและอีกด้าน หนึ่งเพิ่มขึ้น ท าให้เกิดผลต่างความจุ (ΔC) ที่แปรผันตามขนาดของการหมุน วงจรตรวจจับผลต่าง ความจุ (Differential Capacitance Detection Circuit) จะแปลงค ่า ΔC ให้เป็นสัญญาณ แรงดันไฟฟ้า แอนะล็อก ซึ่งส่งต่อเข้าสู่วงจรแปลงสัญญาณ ADC ความละเอียด 16 บิตที่อยู่ภายใน ตัวชิป เพื่อแปลงให้กลายเป็นเลขจ านวนเต็ม (Integer) ที่เรียกว่า ค่าดิบ (Raw Value)

### 2.5.5 การแปลงค่าดิบเป็นหน่วยองศาต่อวินาที

ค ่าดิบที ่ได้จาก MPU6050 จ าเป็นต้องแปลงให้อยู ่ในหน ่วยทางฟิสิกส์ที ่ใช้งานได้จริง คือ องศาต่อวินาที (°/s) โดยใช้ค่าความไวต่อการตรวจจับ (Sensitivity Scale Factor) ที่ก าหนดตาม ย่านวัดที่เลือกใช้ดังสมการที่ 5

ω(°/s ) =

Raw Value
Sensitivity Scale Factor | (5)

ค่าที่ได้บ่งบอกว่าในเฟรมนั้นมือก าลังหมุนรอบแกน X ด้วยอัตราสูงสุดประมาณ 144.9 องศาต่อวินาที ซึ่งสอดคล้องกับการตวัดข้อมือในระหว ่างการโบกมือ โดยค่าชุดนี้จะถูกส่งต่อเข้าสู่ แบบจ าลองปัญญาประดิษฐ์พร้อมกับค่าจากเซนเซอร์อื่น ๆ เพื่อใช้ในการจ าแนกประเภทท่าทาง

23

### 2.6 โปรโตคอลการสื่อสารของระบบ

ถุงมือแปลภาษามือข้างเดียวใช้โปรโตคอลการสื่อสารสองระดับที่มีวัตถุประสงค์แตกต่างกัน ได้แก่ I2C ส าหรับให้ ESP32 อ่านค่าจากเซนเซอร์ MPU6050 บนถุงมือ และ UDP ส าหรับส่งข้อมูลเซนเซอร์ ทั้งหมดออกจากถุงมือไปยังคอมพิวเตอร์ที่ประมวลผลปัญญาประดิษฐ์

### 2.6.1 I2C (Inter-Integrated Circuit)

I2C (Inter-Integrated Circuit) เป็นมาตรฐานการสื่อสารแบบอนุกรมสองสายที่ Philips Semiconductors พัฒนาขึ้นส าหรับเชื ่อมต ่ออุปกรณ์ในระยะสั้นบนแผงวงจรเดียวกัน โดยใช้ สายสัญญาณเพียง 2 เส้น คือ SDA (Serial Data) ส าหรับรับส่งข้อมูล และ SCL (Serial Clock) ส าหรับส่งสัญญาณนาฬิกาเพื่อซิงโครไนซ์
การสื่อสารเป็นแบบ Master-Slave โดย ESP32 ท าหน้าที่เป็น Master ซึ่งเป็นผู้เริ่มต้น การสื่อสารทุกครั้ง ในขณะที่ MPU6050 ท าหน้าที่เป็น Slave ที่มีหมายเลขที่อยู่ (Address) 7 บิต ประจ าตัว ท าให้สายสัญญาณชุดเดียวกันสามารถรองรับการเชื่อมต่ออุปกรณ์ Slave ได้พร้อมกันสูงสุด ถึง 127 ตัว

### 2.6.2 โปรโตคอลการส่งข้อมูลแบบยูดีพี (UDP Protocol)

โปรโตคอลยูดีพี (User Datagram Protocol: UDP) เป็นโปรโตคอลการสื ่อสารใน ระดับชั้นทรานสปอร์ต (Transport Layer) ของโครงแบบการสื่อสารอินเทอร์เน็ต (TCP/IP Model) ออกแบบมาเพื่อการส่งข้อมูลที่ต้องการความรวดเร็วสูงและยอมรับการสูญหายของข้อมูลบางส่วนได้ใน กรณีที่จ าเป็น

24

### 2.6.3 โครงสร้างแพ็กเก็ตข้อมูล UDP

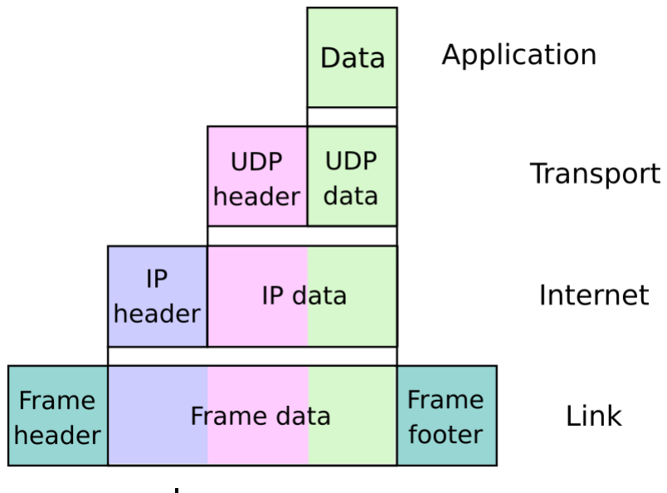
[picture p15: figure]

รูปที่ 2.7 โครงสร้าง UDP

จากรูปที่ 2.7 แสดงกระบวนการ Encapsulation ซึ่งเป็นการห่อหุ้มข้อมูลด้วย Header ที ละชั้น ขณะที่ข้อมูลเคลื่อนที่ลงมาตามล าดับชั้นของ TCP/IP Model ก่อนจะถูกส่งออกไปยังเครือข่าย โดยสามารถแบ่งออกได้เป็น 4 ขั้นตอน ดังนี้
ขั้นตอนแรก เริ่มต้นที่ Application Layer ซึ่งเป็นจุดก าเนิดของข้อมูลดิบ (Data) จาก แอปพลิเคชันที่ใช้งาน เช่น ค าสั่งค้นหา DNS หรือข้อมูลเสียงจากการโทรศัพท์ผ่านอินเทอร์เน็ต โดย ข้อมูลในชั้นนี้จะยังไม่มีการห่อหุ้ม Header ใด ๆ
ขั้นตอนที่สอง คือ Transport Layer ระบบจะน า UDP Header ขนาด 8 ไบต์ มาเพิ่มไว้ ด้านหน้าของ Data เกิดเป็น UDP Datagram ซึ่งประกอบด้วย UDP Header และ Data ขั้นตอนที่สาม คือ Internet Layer UDP Datagram จากขั้นตอนก่อนหน้าจะถูกมองเป็น ข้อมูลชิ้นเดียว เรียกว่า IP Data จากนั้นระบบจะเพิ่ม IP Header เข้าไปด้านหน้าอีกหนึ่งชั้น รวมกัน เป็น IP Packet
ขั้นตอนสุดท้าย คือ Link Layer IP Packet ทั้งหมดจะถูกบรรจุในส่วนที่เรียกว่า Frame Data โดยมี Frame Header ปิดไว้ด้านหน้า และ Frame Footer ปิดท้ายด้านหลัง ผลลัพธ์ที่ได้คือ Frame ซึ ่งเป็นรูปแบบสุดท้ายของข้อมูลก ่อนที ่จะถูกแปลงเป็นสัญญาณส ่งผ ่านสายเคเบิลหรือ คลื่นสัญญาณ

25

### 2.6.4 ข้อดี

- ความเร็วสูง เพราะ overhead น้อย
- Latency (ความหน่วง) ต ่า เหมาะกับงาน real-time
- เหมาะกับการส่งข้อมูลแบบ broadcast/multicast

### 2.6.5 ความแตกต่างระหว่าง UDP และ TCP

ความแตกต ่างของ UDP (User Datagram Protocol) และ TCP (Transmission Control Protocol) เปรียบเทียบคุณสมบัติที่ส าคัญระหว่าง UDP กับโปรโตคอล TCP มีรายละเอียด ข้อแตกต่างดังนี้
- การยืนยันการรับข้อมูล (Handshake) โปรโตคอล UDP จะไม่มีกระบวนการยืนยัน ก่อนเริ่มส่งข้อมูล ในขณะที่ TCP จะต้องมีการยืนยันการรับส่งข้อมูลแบบ 3-Way Handshake เสมอ
- ขนาดส่วนหัวแพ็กเก็ต UDP มีขนาดส่วนหัว (Header) ที่เล็กมากเพียง 8 ไบต์ ซึ่งต่าง จาก TCP ที่มีขนาดส่วนหัวใหญ่กว่า โดยอยู่ระหว่าง 20-60 ไบต์
- ความหน่วงเวลา (Latency) ด้วยโครงสร้างที่เรียบง่ายของ UDP ท าให้มีความหน่วง เวลาที ่ต ่ามากเมื ่อเทียบกับ TCP ที ่มีความหน ่วงเวลาอยู ่ในระดับปานกลางถึงสูงจากกระบวนการ ตรวจสอบข้อมูล
- การรับประกันการส่งข้อมูล โปรโตคอล UDP จะไม่มีกลไกในการรับประกันว่าข้อมูลที่ ส่งไปจะถึงผู้รับอย่างครบถ้วนสมบูรณ์หรือไม่ แต่ TCP จะมีกลไกที่คอยรับประกันการส่งข้อมูลให้ถึง ปลายทางเสมอ
- ล าดับการมาถึงของแพ็กเก็ต UDP จะไม่รับประกันล าดับการมาถึงของแพ็กเก็ตข้อมูล (ข้อมูลอาจไปถึงไม่เรียงล าดับ) ในขณะที่ TCP จะรับประกันล าดับการมาถึงของข้อมูลให้ถูกต้องตามที่ ส่งไป

### 2.7 ปัญญาประดิษฐ์ (Artificial Intelligence : AI)

ในยุคนี้ เครื่องคอมพิวเตอร์ส่วนใหญ่จะมีหน้าที่ท างาน และประมวลผลโปรแกรมของระบบงาน ตามที่มนุษย์ต้องการ โดยมีมนุษย์เป็นผู้ควบคุม ป้อนค าสั่ง และรอผลลัพธ์จากเครื่องคอมพิวเตอร์ การ ตัดสินใจไม่ส าคัญ ยังอาจขยายพื้นฐานการท างานระหว่างมนุษย์ ท าให้มีแนวคิดที่จะพัฒนาให้เครื่อง คอมพิวเตอร์มีประสิทธิภาพสูงขึ้น โดยเพื่อท างานอ านวยการประเมินต่าง ๆ ให้กับมนุษย์ ซึ่งไม่ใช่เพียง การให้มนุษย์ป้อนข้อมูลค าสั่งเท่านั้น จึงเป็นจุดเริ่มต้นของแนวเครื่องคอมพิวเตอร์ให้มีความคิด มี หลักการที่เหตุผลคล้ายคลึงกับสมองมนุษย์ เพื่อให้เครื่องคอมพิวเตอร์สามารถวิเคราะห์ข้อมูลเพื่อ

26

ค้นหาค าตอบที่ใกล้เคียงที่สุด จุดประสงค์ในการท างานด้วยเหตุนี้จึงมีแนวการพัฒนาแนวระบบเครื่อง คอมพิวเตอร์ ให้มีการท างานเสมือนสมองมนุษย์หรือที ่เรียกว ่า "ปัญญาประดิษฐ์ ( Artificial Intelligence)"
ปัญญาประดิษฐ์ หรือเรียกสั้น ๆ ว่า AI (Artificial Intelligence) เป็นแนวคิดเพื่อการพัฒนา เครื่องคอมพิวเตอร์รูปแบบใหม่ ซึ่งท าให้เครื่องคอมพิวเตอร์เกิดกระบวนการคิดแล้วตัดสินใจเสมือน มนุษย์ โดยอาศัยหลักการทางวิทยาศาสตร์ การคิดค้นในเชิงหรือหลักการที่มาจากเหตุผลสมองมนุษย์ เพื่อน าไปใช้ในการพัฒนาศักยภาพของเครื่องคอมพิวเตอร์ให้สามารถตอบสนองความต้องการด้านการ ท างานในเครื ่องจักรอัจฉริยะได้อย ่างแท้จริงในโลกอนาคต โดยสร้างให้เครื ่องคอมพิวเตอร์ที ่มี ความสามารถพิจารณา วิเคราะห์ จัดเรียง ค านวณ แก้ปัญหา ตัดสินใจ และเรียนรู้ได้ด้วยตนเอง ส่งผล ให้เครื ่องคอมพิวเตอร์มีความสามารถต ่าง ๆ ที ่สามารถท างานในระบบที ่มีความซับซ้อนโดยมี ประสิทธิภาพโดยไม่ต้องพึ่งแรงงานจากมนุษย์
ปัญญาประดิษฐ์ (Artificial Intelligence) เป็นศาสตร์แขนงหนึ่งของวิทยาการคอมพิวเตอร์ที่ ต้องการพัฒนาเครื่องจักรกลต่าง ๆ เช่น เครื่องคอมพิวเตอร์ หรือหุ่นยนต์ เป็นต้น ให้มีความสามารถ ทางด้านความคิด การตัดสินใจ และพฤติกรรมที่คล้ายกับมนุษย์มากที่สุด เพื่อการแก้ปัญหาหรือหา เหตุผลจากข้อมูล หรือองค์ความรู้ที่มีอยู่แล้วน ามาวิเคราะห์ และแปลความหมายให้ได้ผลสรุปหรือ ผลลัพธ์ที่ถูกต้องและมีความใกล้เคียงกับการตัดสินใจด้วยมนุษย์ ปัญญาประดิษฐ์เป็นศาสตร์ที่ช่วย สนับสนุนระบบงานที่อาศัยการท างานของเครื่องจักร หรือเครื่องคอมพิวเตอร์ได้เป็นอย่างดี เมื่อมีการ พัฒนาปัญญาประดิษฐ์ที่มีประสิทธิภาพการท างานต่าง ๆ จะเกิดข้อผิดพลาดน้อย มีการแก้ไขปัญหา และตัดสินใจที่เร็วกว่าการใช้สมองมนุษย์ เนื่องจากมนุษย์ยังต้องอาศัยพื้นฐานทางกายภาพหรือร่างกาย ท าให้การท างานอาจเกิดความผิดพลาดขึ้นได้เสมอดังแสดงในรูปที่ 2.8

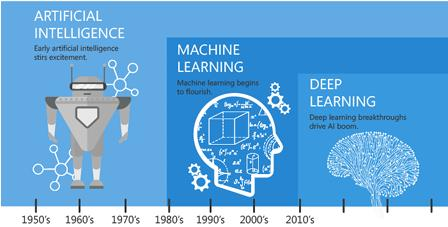
[picture p16: figure]

รูปที่ 2.8 เปรียบเทียบ AI, Machine Learning, Deep Learning

27

จ าแนกปัญญาประดิษฐ์ออกเป็น 4 ลักษณะ โดยสามารถสรุปได้ดังนี้
1. ระบบความคิดที่เลียนแบบมนุษย์
ปัญญาประดิษฐ์ที่มีคุณสมบัติที่พัฒนาเพิ่ม ท าให้องค์กรมีลักษณะทางการคิดที่คล้ายคลึงกับ มนุษย์ ซึ่งมีการพัฒนาในตัวเท่านั้น ซึ่งมีการยืดหยุ่นความส าคัญในการพัฒนาองค์กรให้มีลักษณะ ทางการคิดที ่คล้ายคลึงกับมนุษย์ มีการพัฒนาให้ได้มาตรฐานที ่ตั้งไว้ตามพฤติกรรมการคิดในการ แก้ปัญหาที่เกิดขึ้นจากการท างานที่ได้รับมอบหมายจากมนุษย์ การกระท าในการเลียนแบบความคิด ของมนุษย์ และการยกระดับพฤติกรรมของปัญญาประดิษฐ์ให้ตรงกับการแก้ปัญหาที่ซับซ้อนที่มนุษย์ ต้องการให้ได้มาตรฐานที่สุดเท่าที่จะท าได้
2. ระบบการกระท าที่เหมือนมนุษย์
การกระท าที่เกิดขึ้นจากปัญญาประดิษฐ์ ซึ่งอาจพัฒนาให้มีระบบการด าเนินการที่เลียนแบบ จากมนุษย์ ส่งผลให้สามารถออกแบบกระบวนการทางการท างานได้ด้วยระบบการกระท าที่เหมือน มนุษย์ สามารถเลียนแบบพฤติกรรมได้ในระดับการเลียนแบบพฤติกรรมที่ต้องการหรือการด าเนินงาน ที่มีการจัดกระบวนการพฤติกรรมที่คล้ายมนุษย์ได้เป็นอย่างดี การออกแบบระบบการกระท าที่ใช้ระบบ ทางความคิดอย่างมีระบบและสามารถปรับใช้ให้มีประสิทธิภาพเป็นอย่างดี การกระท าเหล่านี้ส่งผลให้ ปัญญาประดิษฐ์สามารถแสดงบทบาทการท างานได้เช่นเดียวกับมนุษย์ในด้านกระบวนการด าเนินงาน
3. ระบบความคิดอย่างมีเหตุผล
ระบบความคิดที ่เกิดจากปัญญาประดิษฐ์อย ่างมีเหตุผลและพฤติกรรมที ่คล้ายคลึงกับการ ท างานของเหตุผล โดยสร้างเป็นพฤติกรรมแบบระบบปัญญาประดิษฐ์ ที่สามารถด าเนินงานได้ในระดับ กระบวนการทางการคิดที ่มีการจัดการเป็นอย ่างดี ในการก าหนดมาตรการที ่จะมีการเลียนแบบ กระบวนการต่าง ๆ ที่เป็นทางการ เพื่อให้สามารถตัดสินใจได้บนฐานของการใช้เหตุผลและผลลัพธ์ที่ ท างานได้อย ่างมีมาตรฐานตามแผน การพัฒนากระบวนการทางความคิดให้มีแบบแผนที ่ใช้ใน กระบวนการท างานร่วมกับระบบต่าง ๆ ตามมาตรฐานการท างานได้ในแนวที่ต้องการ
4. ระบบการกระท าอย่างมีเหตุผล
ด้วยระบบการกระท าที่มีเหตุผลของปัญญาประดิษฐ์ ส่งผลให้มีการแสดงผลออกมาอย่างมี เหตุผล และยังพัฒนาให้สามารถเลียนแบบการแสดงออกที่มีความเหมาะสมกับสถานการณ์ต ่าง ๆ อย่างดี ด้วยการประเมินผลที่เกิดจากการใช้ปัญญาประดิษฐ์ในเชิงเหตุผล การแสดงออกตามกรอบ ความคิดในระบบปัญญาประดิษฐ์ที่เกิดขึ้นในระดับการควบคุมการตัดสินใจในการเลียนแบบพฤติกรรม ได้ในระดับการแสดงออกเพื่อพัฒนาระบบปัญญาประดิษฐ์ให้ท าหน้าที่ในระดับที่ตั้งเป้าหมาย

28

ปัญญาประดิษฐ์สามารถแบ่งตามฟังก์ชันการท างานได้เป็น 4 ประเภทหลัก ๆ ดังนี้
1. Reactive Machines
เป็นระบบ AI ที่ไม่สามารถเรียนรู้ได้ด้วยตนเอง มีความสามารถจ ากัด ไม่มีหน่วยความจ าเป็น ของตัวเอง ไม่สามารถดึงข้อมูลเก่ามาพัฒนาในการตัดสินใจให้ดีขึ้นได้ ไม่สามารถสร้างการอนุมานจาก ข้อมูล เพื่อประเมินการกระท าในอนาคตได้ ท าได้แค่ปฏิกิริยาโต้ตอบกับสถานการณ์ตรงหน้าเท่านั้น เช่น การเล่นหมากรุก เป็นต้น
2. Limited Theory
เป็นระบบ AI ที ่ตรงกันข้ามกับประเภท Reactive Machines โดยสิ้นเชิง เพราะสามารถ เรียนรู้ด้วยตนเองได้ มีหน่วยความจ า แต่มีจ ากัด สามารถดึงข้อมูลเก่ามาตัดสินใจ หรือแก้ปัญหาใน อนาคตได้ ซึ ่งยิ ่งมีข้อมูลมาก ระดับความถูกต้องแม ่นย าก็จะยิ ่งสูงขึ้นเรื ่อย ๆ เช ่น รถยนต์ AI ใช้ เซ็นเซอร์เพื่อระบุผู้คนที่เดินข้ามถนน สัญญาณไฟจราจร และอื่น ๆ เพื่อให้การตัดสินใจในการขับขี่ดีขึ้น และป้องกันการเกิดอุบัติเหตุได้
3. Theory of Mind
การท างานของ AI ประเภทนี้ คือ สามารถเข้าใจอารมณ์ ความรู้สึก วัฒนธรรม และความเชื่อ ต่าง ๆ ของมนุษย์ได้ เหมือนตัวอย่าง AI ที่เกิดขึ้นในภาพยนตร์เรื่อง Her (2013) AI ที่สามารถรับรู้ ความรู้สึก และพูดคุยได้ ซึ่งในปัจจุบันยังไม่สามารถพัฒนาขึ้นมาได้จริง และยังต้องใช้เวลาอีกมากใน การค้นคว้าและพัฒนา หากในอนาคต AI ประเภทนี้พัฒนาได้ส าเร็จ AI ประเภทนี้อาจสามารถท านาย พฤติกรรมล่วงหน้าได้ เหมือนการจ าลองความสัมพันธ์ระหว่างมนุษย์ ผ่านการท าความเข้าใจความรู้สึก ที่เกิดขึ้นตรงหน้า
4. Self-Awareness
เป็นระบบ AI ขั้นสูงสุด สามารถมีอารมณ์ ความรู้สึก ความเชื่อ และมีความต้องการเป็นของ ตัวเอง รวมถึงสามารถคิดตัดสินใจ เลือก และกระท าสิ่งต่าง ๆ ได้ด้วยตนเองทั้งหมด เช่นตัวอย่าง AI ใน ภาพยนตร์เรื ่อง Chappie (2015) AI ที ่สามารถเรียนรู้ความรัก และเรียนรู้ในการมีชีวิตอยู่ ซึ ่งใน ปัจจุบันก็ยังไม่สามารถพัฒนาขึ้นมาได้เช่นเดียวกับประเภท Theory of Mind ซึ่ง AI ประเภทนี้มีความ ก้าวกระโดดกว ่าทฤษฎีความคิดของ AI เป็นอย ่างมาก ตั้งแต ่การท าความเข้าใจอารมณ์ ไปสู ่การ ตระหนักรู้ในสถานะของตนเอง การคาดการณ์ความรู้สึกของผู้อื่นได้ และมนุษย์เรายังห่างไกลจาก AI ประเภทนี้มาก

เทคโนโลยี AI สามารถใช้ ML และเครือข่าย Deep Learning เพื่อแก้ไขปัญหาที่ซับซ้อนด้วย ความฉลาดที่คล้ายคลึงกับมนุษย์ AI สามารถประมวลผลข้อมูลได้ในวงกว้าง ไม่ว่าจะเป็นการค้นหา

29

รูปแบบ การระบุข้อมูล และการให้ค าตอบ สามารถใช้ AI เพื่อแก้ไขปัญหาในหลากหลายด้าน เช่น การ ตรวจจับการฉ้อโกง การวินิจฉัยทางการแพทย์ และการวิเคราะห์ธุรกิจ

### 2.7.1 การใช้งานเทคโนโลยี AI

ในปัจจุบัน ระบบปัญญาประดิษฐ์ได้ถูกน ามาประยุกต์ใช้ในหลากหลายธุรกิจและ อุตสาหกรรม ไม่ว่าจะเป็นภาคการผลิต โรงงาน โรงพยาบาล ตลอดจนภาคการบริการ อีกทั้งยังมีการ น า AI มาใช้งานในฟังก์ชันต ่าง ๆ ขององค์กร ท าให้การด าเนินงานในหลายส ่วนเป็นไปอย ่างมี ประสิทธิภาพและสะดวกยิ ่งขึ้น AI จึงเป็นเครื ่องมือส าคัญที ่มีบทบาทในการยกระดับและพัฒนา ศักยภาพของธุรกิจและอุตสาหกรรมในหลายมิติ AI ช่วยเสริมสร้างธุรกิจและอุตสาหกรรมตัวอย ่าง ธุรกิจ ดังรูปที่ 2.9

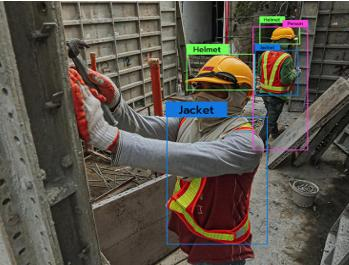
[picture p17: figure]

รูปที่ 2.9 การน า AI มาใช้ในด้านอุตสาหกรรม

เทคโนโลยี AI มีระบบการท างานในเรื่องของการรวบรวมและวิเคราะห์ข้อมูลจ านวนมาก ได้อย่างดีเยี่ยม และเกิดข้อผิดพลาดได้น้อยมาก ดังนั้น ในด้านการวิจัยการพัฒนาต่าง ๆ จะท าให้ได้ ข้อมูลที่มีประสิทธิภาพ และมีความถูกต้องสูง ไม่ว่าจะในด้านอุตสาหกรรมใด ๆ จะยิ่งพัฒนาให้สินค้า นั้นเกิดผลส าเร็จได้อย่างมาก

30

### 2.7.2 ประโยชน์ของปัญญาประดิษฐ์

การน าปัญญาประดิษฐ์มาใช้ในระบบต่าง ๆ ขององค์กร นอกจากจะช่วยเพิ่มประสิทธิภาพ ของระบบงานที่ต้องการได้แล้ว ปัญญาประดิษฐ์ยังส่งผลต่อการท างานในการรวมขององค์กรได้เป็น อย่างดี และยังสร้างประโยชน์ในด้านต่าง ๆ อีกมากมาย ได้แก่
- ช่วยให้กระบวนการแก้ไขปัญหาท าได้อย่างรวดเร็ว และมีความสอดคล้องกันมากขึ้น
- ช ่วยแก้ไขปัญหาต ่าง ๆ ในกรณีที ่ยากเกินความสามารถของมนุษย์และเครื ่อง คอมพิวเตอร์ทั่วไป
- รองรับข้อมูลและองค์ความรู้จ านวนมากได้
- สามารถจัดเก็บข้อมูล และองค์ความรู้ได้เป็นอันมาก
- การเผยแพร่องค์ความรู้ภายในองค์กรท าได้ง่ายและทั่วถึง
- การวิเคราะห์ปัญหาท าได้ละเอียดรอบคอบ โดยเฉพาะปัญญาประดิษฐ์ที่ถูกพัฒนาใช้ งานเฉพาะด้าน
- มีความยืดหยุ่นต่อการคาดเดาสถานะได้อย่างมีประสิทธิภาพ
- การควบคุมเครื่องจักรกลและเครื่องคอมพิวเตอร์ท าได้ง่ายขึ้น
คุณสมบัติ ข้อจ ากัด และประโยชน์ของปัญญาประดิษฐ์เป็นอีกสิ่งที่มีความส าคัญที ่ท าให้ เกิดประสิทธิภาพการท างานของปัญญาประดิษฐ์มีความส าคัญต่อระบบงานในองค์กรรวมกัน เพื่อให้ เกิดเป็นนวัตกรรมที่มีคุณค ่า และคุ้มค ่าอย่างมากต่อการลงทุนในด้านทรัพยากรความรู้ จะช่วยให้ ทรัพยากรที่มีอยู่อย่างจ ากัดสามารถใช้งานได้อย่างเต็มที่ และเกิดผลที่ดีต่อองค์กรในที่สุด อย่างไรก็ตาม ปัญญาประดิษฐ์ไม่สามารถท างานแทนมนุษย์ได้ และจ าเป็นต้องประยุกต์ใช้ในการร่วมกันกับมนุษย์จึง จะได้ผลอย่างมีประสิทธิภาพ

### 2.8 การเรียนรู้ของเครื่อง (Machine Learning : ML)

การเรียนรู้ของเครื่อง (Machine Learning) คือกระบวนการที่ท าให้คอมพิวเตอร์สามารถเรียนรู้ และพัฒนาประสิทธิภาพการท างานได้ด้วยตนเองจากข้อมูลและสภาพแวดล้อมที ่ได้รับ โดยไม่ จ าเป็นต้องมีการก ากับจากมนุษย์หรือการเขียนโปรแกรมเพิ่มเติม เมื่อมีข้อมูลรูปแบบใหม่ในอนาคต ระบบสามารถประมวลผลและปรับตัวได้โดยอัตโนมัติ โดยไม่ต้องมีการแทรกแซงหรือการปรับปรุง โปรแกรมจากมนุษย์ ระบบเรียนรู้จากการวิเคราะห์ข้อมูล ท าให้สามารถตัดสินใจและตอบสนองต่อ สถานการณ์ที่ซับซ้อนได้อย่างมีประสิทธิภาพ
Machine Learning ท างานในลักษณะเดียวกันกับการเรียนรู้ของมนุษย์ โดยเริ่มจากการป้อนชุด ข้อมูลพื้นฐานและค าสั่งต่าง ๆ เพื่อให้คอมพิวเตอร์สามารถเรียนรู้ และจ าแนกวัตถุ บุคคล หรือสิ่งของ

31

ได้อย่างมีประสิทธิภาพ เพื่อให้ได้ผลลัพธ์ที่มีความแม่นย ามากขึ้น โปรแกรมเมอร์จะป้อนชุดข้อมูลใหม่ ๆ อย ่างต ่อเนื ่องและฝึกฝนระบบอย ่างสม ่าเสมอ กระบวนการนี้ช ่วยให้ระบบเกิดการพัฒนาและ สามารถปรับปรุงการตัดสินใจหรือการคาดการณ์ด้วยตัวเองได้ดังรูปที่ 2.10

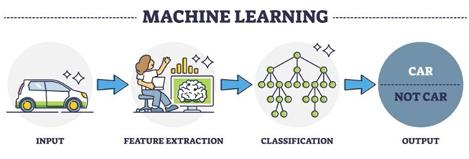
[picture p18: figure]

รูปที่ 2.10 การเรียนรู้ของ Machine Learning

1. Supervised Learning คือการที่คอมพิวเตอร์เรียนรู้จากข้อมูลตัวอย่างที่มีการระบุค าตอบ ล่วงหน้า โดยคอมพิวเตอร์จะได้รับข้อมูลอินพุตและเรียนรู้ผ่านการวิเคราะห์คุณสมบัติ เพื่อน าไปใช้ใน การจ าแนกประเภท ยกตัวอย่างเช่น การป้อนรูปภาพปากกาให้คอมพิวเตอร์ ซึ่งเบื้องต้นคอมพิวเตอร์ ไม่ทราบว่าเป็นรูปปากกา แต่เมื่อได้รับการสอนให้รู้จักคุณลักษณะเฉพาะของปากกา เช่น มีปลายด้าม และใช้หมึก คอมพิวเตอร์จะสามารถแยกแยะรูปปากกาได้ในอนาคต
2. Unsupervised Learning เป็นการเรียนรู้ที ่คอมพิวเตอร์วิเคราะห์ข้อมูลโดยไม ่มีค าตอบ ล่วงหน้า มนุษย์จะป้อนข้อมูลและปล่อยให้คอมพิวเตอร์ค้นหารูปแบบและโครงสร้างจากข้อมูลนั้นเอง เช่น การป้อนรูปภาพปากกาเข้าไปโดยไม่บอกว่าเป็นปากกา คอมพิวเตอร์จะวิเคราะห์คุณสมบัติของ รูปภาพและใช้วิธีการจัดกลุ่ม เพื่อจัดประเภทวัตถุที่มีลักษณะคล้ายกัน เช่น อาจจัดปากกากับปากกา ไฮไลท์ในกลุ่มเดียวกัน เนื่องจากมีคุณสมบัติคล้ายคลึงกัน
3. Reinforcement Learning เป็นการเรียนรู้ที ่เกิดจากการโต้ตอบระหว ่างผู้เรียนรู้และ สิ่งแวดล้อม โดยผู้เรียนรู้จะเลือกกระท าในสถานการณ์ต่าง ๆ ผ่านการลองผิดลองถูกเพื่อหาวิธีที่ให้ผล ลัพธ์ที ่ดีที ่สุด เช ่น ในเกม AlphaGo ที ่ระบบเรียนรู้ว ่าควรเดินหมากอย ่างไรเพื ่อครอบครองพื้นที่ มากกว่าคู่ต่อสู้โดยมีเงื่อนไขและรางวัลก าหนดไว้

### 2.9 การเรียนรู้เชิงลึก (Deep Learning : DL)

Deep Learning (DL) คือเทคนิคการเรียนรู้ของเครื่องที่มีพื้นฐานจากโครงข่ายประสาทเทียม (Neural Networks) ซึ่งประกอบด้วยหลายชั้น ท าให้สามารถประมวลผลข้อมูลที่ซับซ้อนมากขึ้น เช่น รูปภาพ เสียง หรือข้อความ โดยการท างานของโครงข่ายนี้เริ่มต้นที่ชั้นแรกหรือ Input Layer ซึ่งท า

32

หน้าที่รับข้อมูลจากภายนอก แล้วส่งข้อมูลผ่านไปยังชั้นซ่อน (Hidden Layers) ที่ท าการประมวลผล ข้อมูลในหลายขั้นตอน เพื่อตีความหรือลดรูปข้อมูลให้อยู่ในรูปแบบที่เครื่องสามารถเข้าใจได้ดีขึ้น ความสามารถของ Deep Learning ที่ท าให้มันมีประสิทธิภาพมากคือการไม่ต้องการให้ผู้พัฒนา ก าหนดคุณสมบัติของข้อมูลล ่วงหน้า โครงข ่ายสามารถเรียนรู้คุณสมบัติที ่ส าคัญได้เองเมื ่อมีข้อมูล เพียงพอ ท าให้เหมาะกับการใช้งานในหลายด้าน เช ่น การรู้จ าภาพ (Image Recognition) การ แปลภาษา (Language Translation) และการประมวลผลเสียง (Speech Recognition) ดังรูปที่ 2.11

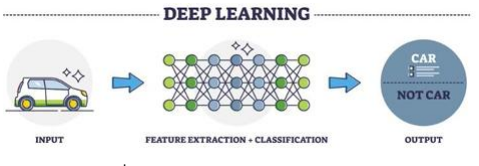
[picture p19: figure]

รูปที่ 2.11 การเรียนรู้ของ Deep Learning

### 2.10 ระบบโครงข่ายใยประสาท (Artificial Neural Network : ANN)

โครงข ่ายประสาทเทียมเป็นโมเดลทางคณิตศาสตร์ว่าด้วยการค านวณแบบคอนเนคชันนิสต์ (Connectionist) ที่ใช้ส าหรับประมวลผลเพื่อจ าลองการท างานของเครือข่ายประสาทในสมองมนุษย์ที่ สามารถสร้างความสามารถในการเรียนรู้แบบจดจ ารูปแบบ (Pattern Recognition) โดยแนวคิดใน การเรียนรู้แบบโครงข ่ายประสาทของมนุษย์ เริ ่มมาจากการศึกษาโครงข ่ายไฟฟ้าชีวภาพในสมอง (Bioelectric Network) ส าหรับการรับรู้สิ่งต่าง ๆ ซึ่งการที่มนุษย์จะรับรู้สิ่งต่าง ๆ ได้นั้น จะต้องมี Dendrite ที่เปรียบเสมือน Input Layer ส าหรับข้อมูลที่เข้ามา จากนั้นจะใช้ Soma ที่เปรียบเสมือน Hidden Layer เป็นตัวประมวลในชุดข้อมูลที่ได้รับเข้ามา และ Axon จะท าหน้าที่แปลงข้อมูลให้เป็น ผลลัพธ์ออกมา จากนั้นจะแสดงผลลัพธ์นั้นด้วย Synapses ที่เสมือน Output Layer ดังรูปที่ 2.12

33

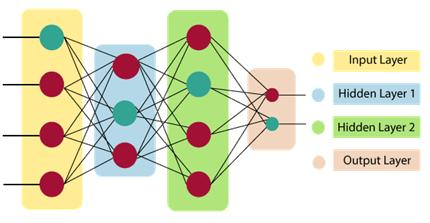
[picture p20: figure]

รูปที่ 2.12 โครงข่ายประสาทเทียม

### 2.10.1 โครงข่ายประสาทเทียมแบบหลายชั้น

MLP เป็นโครงข ่ายประสาทเทียม (Artificial Neural Network) ประเภทหนึ ่งที ่มี โครงสร้างแบบฟีดฟอร์เวิร์ด (Feedforward) คือ สัญญาณข้อมูลจะไหลไปในทิศทางเดียวจากชั้นต้น ทางไปยังชั้นปลายทางเท่านั้น โดย MLP เกิดขึ้นจากความพยายามพัฒนาต่อยอดจาก Perceptron แบบชั้นเดียว (Single-Layer Perceptron) ซึ่งเดิมสามารถใช้จ าแนกข้อมูลได้เฉพาะกรณีที ่ข้อมูล สามารถแบ่งแยกได้ด้วยเส้นตรง (Linearly Separable) เท่านั้น MLP จึงถูกพัฒนาให้ประกอบด้วย เซลล์ประสาทที่เชื่อมต่อกันแบบเต็มรูปแบบ (Fully Connected) และใช้ฟังก์ชันกระตุ้นแบบไม่เชิง เส้น (Nonlinear Activation Function) ซึ่งช่วยให้สามารถจ าแนกข้อมูลที่ไม่สามารถแบ่งแยกได้ด้วย เส้นตรงได้

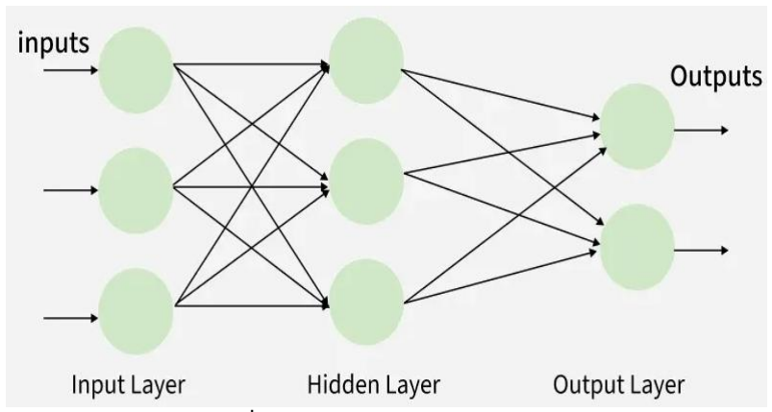
[picture p21: figure]

รูปที่ 2.13 โครงสร้าง MLP

34

จากรูปที่ 2.13 โครงสร้างของ MLP ประกอบด้วย 3 ส่วนหลัก ได้แก่
1. Input Layer ท าหน้าที่รับข้อมูลเข้าสู่โครงข่าย โดยแต่ละโหนดในชั้นนี้จะสอดคล้องกับ คุณลักษณะ (Feature) หนึ่งอย่างของข้อมูล
2. Hidden Layer เป็นชั้นที่ท าหน้าที่ประมวลผลข้อมูลระหว่างชั้นอินพุตและเอาต์พุต ซึ่ง อาจมีได้ตั้งแต่หนึ ่งชั้นขึ้นไป โดยในแต ่ละชั้นจะมีการเชื ่อมต ่อกันแบบเต็มรูปแบบ กล ่าวคือ เซลล์ ประสาททุกตัวในชั้นหนึ่งจะเชื่อมต่อกับเซลล์ประสาททุกตัวในชั้นก่อนหน้า และจะมีการใช้ฟังก์ชัน กระตุ้นในแต่ละชั้นเพื่อช่วยให้โครงข่ายสามารถเรียนรู้ความสัมพันธ์ที่ซับซ้อนของข้อมูลได้
3. Output Layer ท าหน้าที่ค านวณผลลัพธ์สุดท้ายของโครงข่าย ซึ่งอาจเป็นค่าตัวเลข เดียวส าหรับงานถดถอย (Regression) หรือชุดของค ่าความน ่าจะเป็นของแต ่ละกลุ ่มส าหรับงาน จ าแนกประเภท (Classification)
หลักการเรียนรู้ของ MLP ใช้กระบวนการที่เรียกว่า Backpropagation โดยในระหว่างการ ฝึกฝน ค่าน ้าหนัก (Weight) ของการเชื่อมต่อระหว่างเซลล์ประสาทแต่ละคู่จะถูกปรับด้วยวิธีการเชิงหา ค ่าเหมาะที ่สุด เช ่น Gradient Descent เพื ่อลดค ่าความคลาดเคลื ่อนระหว ่างผลลัพธ์ที ่โครงข ่าย ท านายได้กับค่าค าตอบจริงในชุดข้อมูลฝึกฝน จากนั้นจึงน าโครงข่ายไปทดสอบกับชุดข้อมูลที ่แยก ต่างหาก เพื่อปรับจูนค่าตัวแปรไฮเปอร์พารามิเตอร์และป้องกันปัญหา Overfitting ดังรูปที่ 2.14

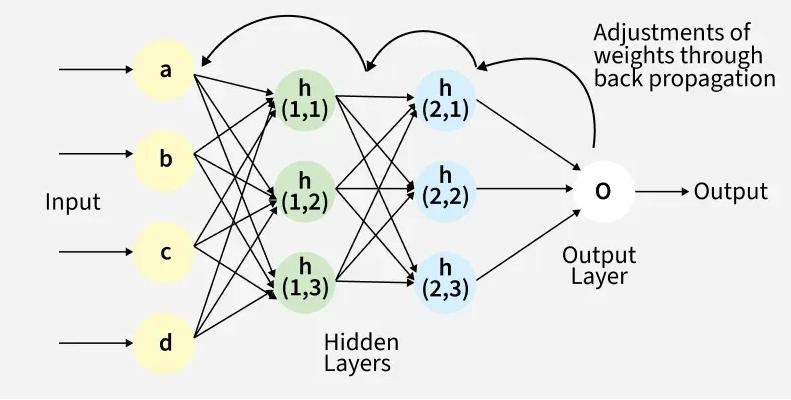
[picture p22: figure]

รูปที่ 2.14 Backpropagation

MLP จะถูกใช้ในงานประเภท Supervised Learning เช ่น การจ าแนกประเภท (Classification) และการท านายค่าต่อเนื่อง (Regression) และยังถือเป็นพื้นฐานส าคัญที่น าไปสู่การ พัฒนาโครงข่ายประสาทเทียมที่ซับซ้อนขึ้น เช่น CNN และ RNN ในเวลาต่อมา MLP มีข้อจ ากัดในการ

35

ประมวลผลข้อมูลที่มีลักษณะเป็นล าดับหรือหลายมิติ เช่น ภาพหรือข้อความ ซึ่งในกรณีเหล่านี้จะใช้ โครงข่ายประเภทอื่นที่เหมาะสมกว่าแทน

### 2.10.2 ฟังก์ชันกระตุ้น (Activation Functions)

ในสถาปัตยกรรมของโครงข ่ายประสาทเทียม (Artificial Neural Network: ANN) โดยเฉพาะโครงข่ายประสาทเทียมแบบเพอร์เซปตรอนหลายชั้น (Multi-layer Perceptron: MLP) ฟังก์ชันกระตุ้นจัดเป็นองค์ประกอบหลักในส่วนประมวลผลของนิวรอน (Neuron) ท าหน้าที่น าผลรวม ถ่วงน ้าหนักของสัญญาณข้อมูลขาเข้าบวกกับค่าไบแอส (Weighted Sum of Inputs and Bias) มา ค านวณผ่านฟังก์ชันทางคณิตศาสตร์ เพื่อแปลงค่าและก าหนดระดับของสัญญาณเอาต์พุตที่จะส่งต่อไป ยังนิวรอนในชั้นถัดไป (Hidden Layers) หรือชั้นเอาต์พุต (Output Layer)

- ฟังก์ชันเรลู (Rectified Linear Unit: ReLU) ใช้ประมวลผลภายในชั้นซ่อนทั้งสอง ชั้นดังสมการที่ 6
f(z) = max(0, z) = {

z ถ้า z > 0
0 ถ้า z ≤ 0

(6)

- ฟังก์ชัน ReLU มีข้อดีส าคัญหลายประการ ได้แก่ ค านวณได้รวดเร็ว ช่วยลดปัญหา ความจางหายของเกรเดียนต์ (Vanishing Gradient) ซึ่งจะเกิดขึ้นกับโครงข่ายชั้นลึก และท าให้นิวรอน ส่วนหนึ่งมีค่าเป็นศูนย์ (Sparse Activation) ซึ่งช่วยลดความซับซ้อนของแบบจ าลองโดยปริยาย
- ฟังก์ชันซอฟต์แมกซ์ (Softmax Function) ใช้ประมวลผลในชั้นส่งออก เพื่อแปลง ค่าดิบจากนิวรอนทั้ง 31 ตัวให้กลายเป็นการกระจายความน่าจะเป็น (Probability Distribution) ที่มี ผลรวมเท่ากับ 1.0 เสมอดังสมการที่ 7

P(Classk

) =

e

zk

∑ | e
z K | j
j=1

(7)

โดยที่ zk คือค่าดิบ (Logit) ของคลาสที่ k และ K คือจ านวนคลาสทั้งหมด (31 คลาส) ผลลัพธ์ที่ได้คือค่าความน่าจะเป็นของแต่ละท่าทาง และแบบจ าลองจะเลือกคลาสที่มีความน่าจะเป็น สูงสุดเป็นค าตอบสุดท้าย

36

### 2.10.3 กระบวนการฝึกสอนแบบจ าลองและการย้อนกลับ

กระบวนการฝึกสอน MLP ด าเนินงานแบบวนซ ้าในแต่ละรอบการเรียนรู้ (Epoch) โดยมี ขั้นตอนหลักดังนี้
1. การส่งข้อมูลไปข้างหน้า (Forward Pass) ข้อมูลน าเข้าจะถูกส่งผ่านชั้นต่าง ๆ ของ โครงข่ายตามล าดับ โดยแต่ละนิวรอนค านวณผลลัพธ์ตามสมการที่กล่าวมาข้างต้น จนได้ค่าความน่าจะ เป็นในชั้นส่งออก
2. การค านวณความสูญเสีย (Loss Calculation) น าผลการท านายที ่ได้มา เปรียบเทียบกับค าตอบที ่ถูกต้องจริง (Ground Truth) โดยใช้ฟังก์ชันความสูญเสียแบบ Cross-Entropy ส าหรับงานจ าแนกประเภทหลายคลาสดังสมการที่ 8
L = −∑yklogŷk | (8)

k

k=1

โดยที่ yk คือค ่าจริง (1 เมื ่อถูกต้อง, 0 เมื ่อผิด) และ ŷk คือค ่าความน ่าจะเป็นที่ แบบจ าลองท านายได้
3. การย้อนกลับ (Backpropagation) น าค่าความสูญเสียมาค านวณอนุพันธ์ย้อนกลับ จากชั้นส่งออกไปยังชั้นน าเข้า เพื่อหาว่าค่าน ้าหนักของนิวรอนตัวใดมีส่วนท าให้เกิดความผิดพลาดมาก ที่สุด โดยใช้กฎลูกโซ่ (Chain Rule) ของแคลคูลัสดังสมการที่ 9

∂L
∂wi

=

∂L
∂a ∙

∂a
∂z ∙

∂z
∂wi

(9)

4. การปรับค่าน ้าหนักด้วยตัวเพิ่มประสิทธิภาพ (Optimizer) ในถุงมือแปลภาษามือ ข้างเดียว เลือกใช้ตัวเพิ่มประสิทธิภาพแอดัม (Adaptive Moment Estimation: Adam) ซึ่งเป็นการ พัฒนาต่อยอดจากวิธีการลดความชันแบบสุ่ม (Stochastic Gradient Descent: SGD) Adam ปรับ อัตราการเรียนรู้ (Learning Rate) ของแต่ละน ้าหนักโดยอัตโนมัติ โดยอาศัยค่าโมเมนต์ล าดับที่หนึ่ง (Mean) และล าดับที่สอง (Uncentered Variance) ของเกรเดียนต์ที่สะสมมา ท าให้การฝึกสอนลู่เข้าสู่ จุดที่ดีที่สุดได้เร็วและมีเสถียรภาพกว่าวิธีอื่น

37

### 2.10.4 การเตรียมชุดข้อมูลและการป้องกันสภาวะ Overfitting

ในการพัฒนาแบบจ าลองปัญญาประดิษฐ์ประเภทโครงข่ายประสาทเทียม ข้อมูลดิบ (Raw Data) ที ่ตรวจวัดได้จากเซนเซอร์บนอุปกรณ์สวมใส ่จะไม ่สามารถน าเข้าสู ่กระบวนการฝึกสอน (Training Process) ได้โดยตรง เนื่องจากข้อมูลจากเซนเซอร์ต่างชนิดกันจะมีหน่วยวัด ช่วงมิติข้อมูล (Scale) และสัญญาณรบกวนที่แตกต่างกัน การเตรียมชุดข้อมูลจึงเป็นขั้นตอนส าคัญในการจัดสรร ข้อมูลให้อยู่ในรูปแบบที่เหมาะสม เพื่อเพิ่มประสิทธิภาพและความเร็วในการลู่เข้าสู่จุดค าตอบที่ดีที่สุด ของแบบจ าลอง
สภาวะ Overfitting คือภาวะที่แบบจ าลองจดจ าข้อมูลฝึกสอนได้อย่างแม่นย ามากเกินไป แต่ไม่สามารถน าความรู้ที่ได้ไปประยุกต์กับข้อมูลชุดใหม่ที่ไม่เคยพบได้อย่างถูกต้อง ซึ่งในทางปฏิบัติจะ สังเกตได้จากความแม่นย าบนชุดข้อมูลฝึกสอนสูงมาก แต่ความแม่นย าบนชุดข้อมูลทดสอบกลับต ่ากว่า อย่างมีนัยส าคัญ
- การปรับมาตรฐานข้อมูลน าเข้า (Feature Scaling) เนื ่องจากข้อมูลดิบจาก เซนเซอร์แต่ละประเภทมีช่วงค่าแตกต่างกันอย่างมาก เซนเซอร์โค้งงอให้ค่าในช่วง 0 ถึง 4,095 ในขณะ ที่ค่าความเร่งมีช่วงประมาณ −10 ถึง +10 และค่าความเร็วเชิงมุมมีช่วงประมาณ −0.1 ถึง +0.1 หาก น าข้อมูลเหล่านี้เข้าสู่แบบจ าลองโดยตรง น ้าหนักของนิวรอนจะถูกครอบง าโดยข้อมูลกลุ่มที่มีค่าสูงกว่า ส ่งผลให้แบบจ าลองเรียนรู้ได้ไม ่สมดุล จึงจ าเป็นต้องปรับมาตรฐานข้อมูลด้วยวิธี Z-Score Normalization โดยใช้ StandardScaler ดังสมการที่ 10

x

′ =

x − μ
σ

(10)

โดยที่ μ คือค่าเฉลี่ยของข้อมูลในแต่ละมิติ และ σ คือส่วนเบี่ยงเบนมาตรฐาน ผลลัพธ์ที่ ได้คือข้อมูลในทุกมิติมีค่าเฉลี่ยเท่ากับ 0 และส่วนเบี่ยงเบนมาตรฐานเท่ากับ 1
- การแบ่งชุดข้อมูล (Train-Test Split) เพื่อประเมินประสิทธิภาพแบบจ าลองบน ข้อมูลที่ไม่เคยเห็นมาก่อนและป้องกันสภาวะ Overfitting ชุดข้อมูลทั้งหมดจะถูกแบ่งออกเป็นสอง ส่วนในอัตราส่วน 80:20 ดังนี้ชุดข้อมูลฝึกสอน (Training Set) 80% ใช้ปรับค่าน ้าหนักและค่าเอน เอียงของแบบจ าลองในแต ่ละรอบการเรียนรู้ชุดข้อมูลทดสอบ (Testing Set) 20% ใช้ประเมิน ประสิทธิภาพแบบจ าลองหลังสิ้นสุดกระบวนการฝึกสอนทั้งหมด

38

### 2.11 Arduino IDE

Arduino IDE คือโปรแกรม Integrated Development Environment (IDE) ที่ใช้ส าหรับเขียน, คอมไพล์ (Compile) และอัปโหลด (Upload) โค้ดค าสั ่งไปยังบอร์ดไมโครคอนโทรลเลอร์ของ Arduino โปรแกรมนี้เป็นโอเพนซอร์ส (Open Source) ใช้งานได้ฟรี และออกแบบมาให้เขียน โปรแกรมด้วยภาษา C++ ในรูปแบบที่ง่ายขึ้นส าหรับผู้เริ่มต้น ท าให้การพัฒนาโปรเจกต์อิเล็กทรอนิกส์ ท าได้สะดวกและรวดเร็ว

### 2.12 วิธีการติดตั้งและใช้งาน Arduino IDE

### 2.12.1 วิธีการดาวน์โหลดและติดตั้ง

สามารถท าการดาวน์โหลดโปรแกรม Arduino IDE ได้จาก หน้า ดาวน์โหลดโปรแกรม Arduino IDE (arduino.cc/en/software) เมื่อเปิดตัวติดตั้งขึ้นมาหน้าจอจะแสดงให้เลือก อ่านแล้วกดปุ่ม I Agree ดังรูปที่ 2.15

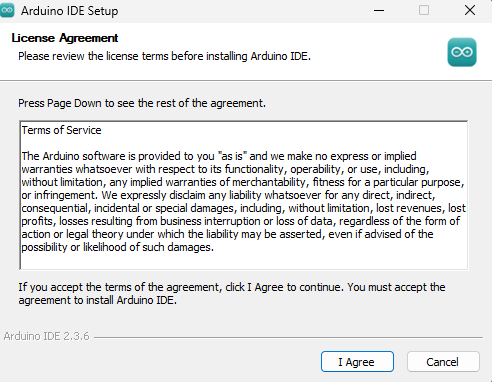
[picture p23: figure]

รูปที่ 2.15 การติดตั้ง Arduino IDE

39

หลังจากนั้นจะแสดงหน้าต่างที่จะให้เลือกโฟลเดอร์ที่ใช้เก็บไฟล์ของโปรแกรม (Select Destination Location) แล้วกดปุ่ม Install ดังรูปที่ 2.16

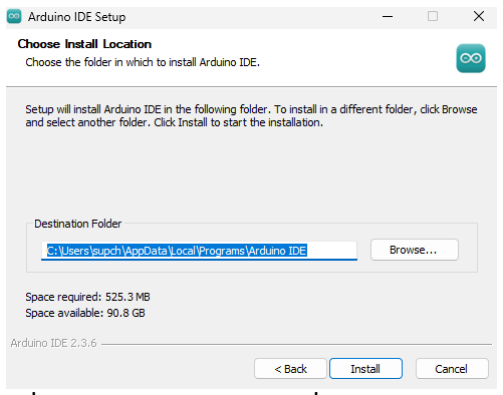
[picture p24: figure]

รูปที่ 2.16 การเลือกโฟลเดอร์ที่จะใช้เก็บไฟล์

จากนั้นรอโปรแกรมท าการติดตั้ง ดังรูปที่ 2.17

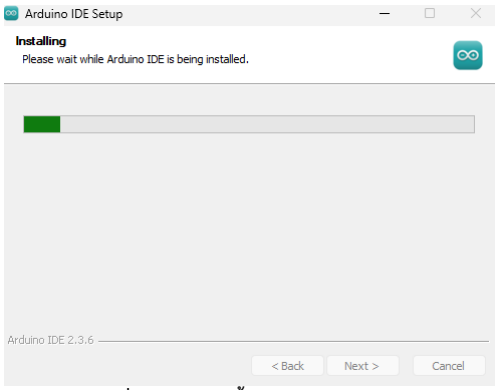
[picture p25: figure]

รูปที่ 2.17 การติดตั้ง Arduino IDE

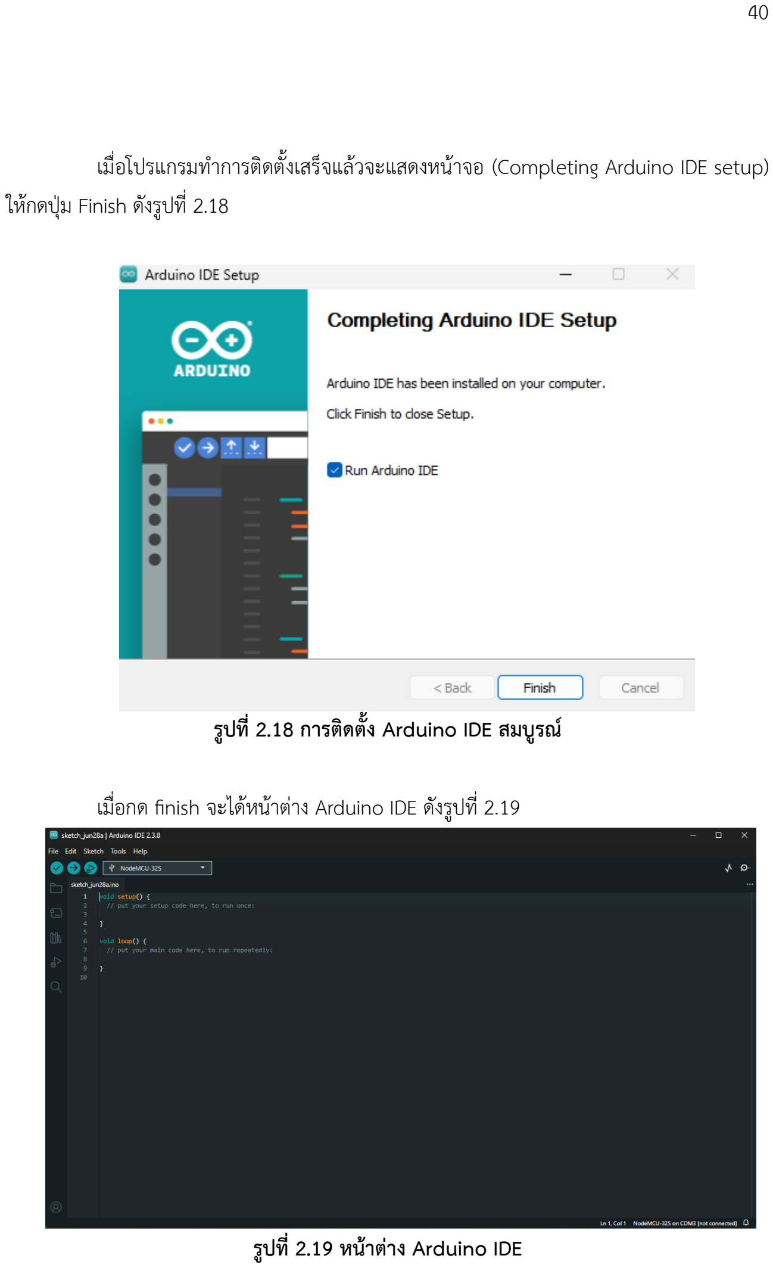
[picture p26: page 58]

40

เมื่อโปรแกรมท าการติดตั้งเสร็จแล้วจะแสดงหน้าจอ (Completing Arduino IDE setup) ให้กดปุ่ม Finish ดังรูปที่ 2.18

รูปที่ 2.18 การติดตั้ง Arduino IDE สมบูรณ์

เมื่อกด finish จะได้หน้าต่าง Arduino IDE ดังรูปที่ 2.19

รูปที่ 2.19 หน้าต่าง Arduino IDE

41

### 2.13 Visual Studio Code

Visual Studio Code เป็นโปรแกรมที่พัฒนาโดยบริษัท Microsoft ซึ่งได้รับการออกแบบมาเพื่อ รองรับการพัฒนาโปรแกรมอย ่างมีประสิทธิภาพ มีฟังก์ชันการท างานที ่ครอบคลุม เช ่น การเน้น ไวยากรณ์ของภาษาโปรแกรม การรองรับการควบคุมเวอร์ชัน โดยเฉพาะกับ JavaScript, TypeScript และ Node.js รวมถึงการรองรับภาษาโปรแกรมหลากหลาย เช่น C++, C#, Java, Python, PHP และ Go รวมถึงการรองรับรันไทม์ต ่างๆ อย ่าง .NET นอกจากนี้ยังสามารถเพิ ่มขีดความสามารถของ โปรแกรมผ่านส่วนขยายต่างๆ
Visual Studio Code เป็นที่นิยมในวงการพัฒนาซอฟต์แวร์ เนื่องจากมีขนาดเล็ก ประสิทธิภาพ สูง และสามารถปรับแต่งให้เข้ากับความต้องการเฉพาะของผู้พัฒนาได้อย่างยืดหยุ่น อีกทั้งยังรองรับ การใช้งานข้ามแพลตฟอร์มทั้งในระบบปฏิบัติการ Windows, macOS และ Linux

### 2.13.1 วิธีการดาวน์โหลดและติดตั้ง

1. สามารถท าการดาวน์โหลดโปรแกรม Visual Studio Code ได้จากหน้า ดาวน์โหลด โปรแกรม Visual Studio Code
2. เมื่อเปิดตัวติดตั้งขึ้นมาหน้าจอจะแสดงให้เลือก (I accept the agreement) แล้ว กด ปุ่ม Next ดังรูปที่ 2.20

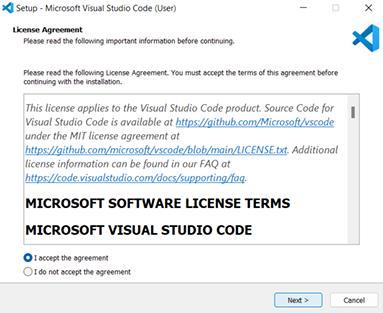
[picture p27: figure]

รูปที่ 2.20 การติดตั้ง Visual Studio Code

42

3. หลังจากนั้นจะแสดงหน้าต ่างขึ้นมาให้เลือกโฟลเดอร์ที ่จะใช้เก็บไฟล์ของโปรแกรม (Select Destination Location) แล้วกดปุ่ม Next ดังรูปที่ 2.21

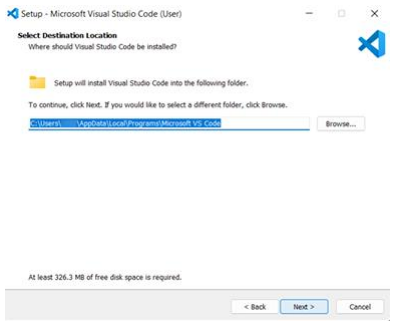
[picture p28: figure]

รูปที่ 2.21 การเลือกโฟลเดอร์ที่จะใช้เก็บไฟล์

4. จากนั้นจะแสดงหน้าจอเลือก (Select Start MenuFolder) แล้วกดปุ่ม Nextดังรูปที่ 2.22

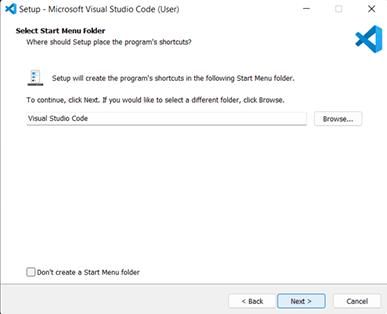
[picture p29: figure]

รูปที่ 2.22 โฟลเดอร์เมนู Start ส าหรับโค้ด Visual Studio

43

5. จากนั้นจะแสดงหน้าจอ (Select Additional Tasks) แล้วกดปุ่ม Next ดังรูปที่ 2.23

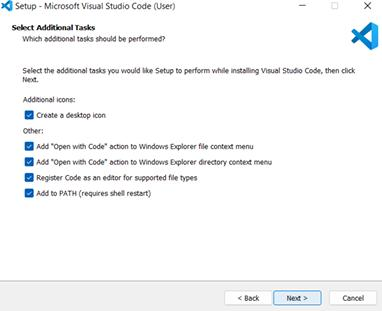
[picture p30: figure]

รูปที่ 2.23 ก าหนดค่าการติดตั้ง

6. หลังจากนั้นจะแสดงหน้าจอ (Ready To Install) แล้วกดปุ่ม Install ดังรูปที่ 2.24

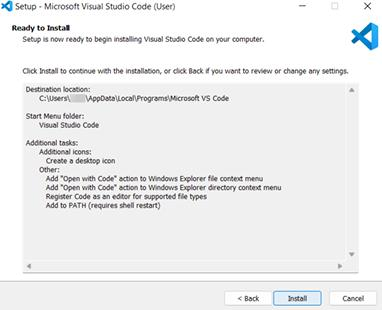
[picture p31: figure]

รูปที่ 2.24 ยืนยันการติดตั้ง

44

7. จากนั้นรอโปรแกรมท าการติดตั้ง ดังรูปที่ 2.25

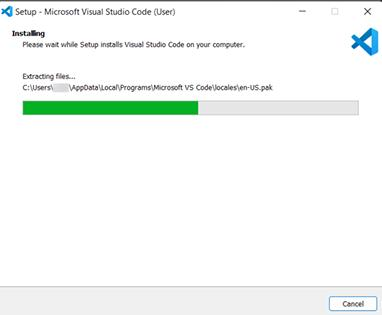
[picture p32: figure]

รูปที่ 2.25 การติดตั้ง Visual Studio

8. เมื ่อโปรแกรมท าการติดตั้งเสร็จแล้วจะแสดงหน้าจอ (Completing the Visual Studio Code Setup Wizard) ให้กดปุ่ม Finish ดังรูปที่ 2.26

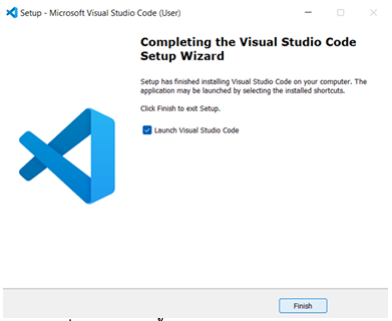
[picture p33: figure]

รูปที่ 2.26 การติดตั้ง Visual Studio สมบูรณ์

45

9. เมื่อกด Finish จะได้หน้าต่าง Visual Studio Code ดังรูปที่ 2.27

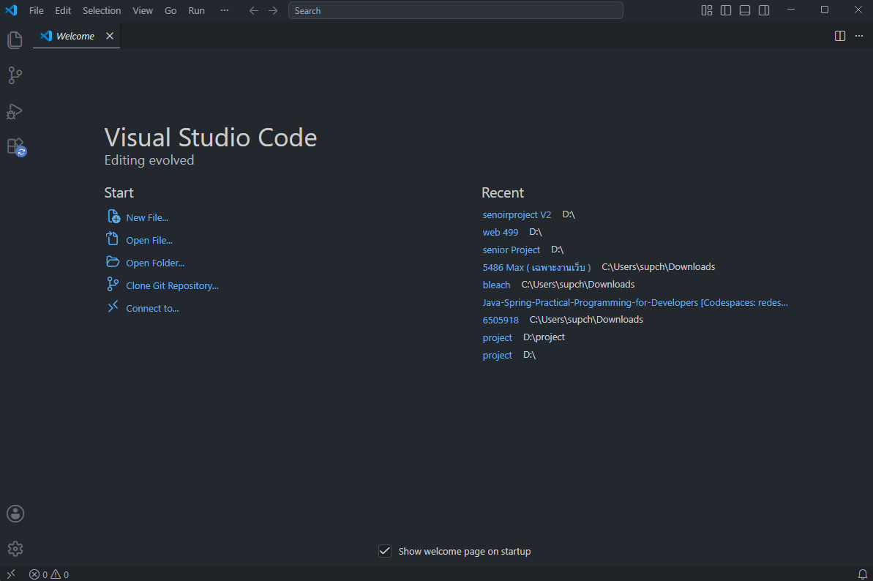
[picture p34: figure]

รูปที่ 2.27 หน้าต่าง Visual Studio Code

### 2.14 Python Programming Language

ภาษา Python เป็นภาษาโปรแกรมคอมพิวเตอร์ระดับสูงที ่ได้รับการยอมรับและใช้งานอย ่าง แพร่หลายในการเทคโนโลยีสารสนเทศและวิทยาการคอมพิวเตอร์ ด้วยคุณลักษณะที่โดดเด่นในด้าน ความเรียบง่ายของไวยากรณ์ ความสะดวกในการใช้งาน และความยืดหยุ่นสูง Python จึงถูกน ามาใช้ ประโยชน์อย ่างกว้างขวางในหลายสาขา เช ่น การพัฒนาแอปพลิเคชันเว็บ การวิเคราะห์และ ประมวลผลข้อมูลเชิงลึก การค านวณทางวิทยาศาสตร์ การพัฒนาระบบการเรียนรู้ของเครื ่องและ ปัญญาประดิษฐ์ ตลอดจนการประมวลผลภาษาธรรมชาติ ซึ่งล้วนเป็นเทคโนโลยีที่มีบทบาทส าคัญใน การขับเคลื่อนนวัตกรรมและการพัฒนาในยุคดิจิทัล โดยลักษณะและคุณสมบัติของ Python
1. Python มีไวยากรณ์ที่เรียบง่ายและอ่านง่าย ท าให้ผู้เริ่มต้นสามารถเข้าใจและใช้งานได้เร็ว
2. Python รองรับทั้งโปรแกรมมิ ่งเชิงวัตถุ โปรแกรมมิ ่งเชิงฟังก์ชัน และโปรแกรมมิ ่งเชิง กระบวนการ
3. Python มีไลบรารีและเฟรมเวิร์คมากมายที ่ช ่วยในการพัฒนา เช ่น NumPy, SciPy, Pandas, Scikit-Learn, TensorFlow และ PyTorch

46

4. Python เป็นภาษาที ่มีค าสั ่งพร้อมใช้งานมากมาย เช ่น การจัดการไฟล์, เครือข ่าย, การท างานกับข้อมูล, และอื่น ๆ ที่ช่วยในการพัฒนาแอปพลิเคชันได้ง่ายขึ้น
5. Python มีระบบจัดการข้อผิดพลาดที ่ช ่วยให้การพัฒนาโปรแกรมท าได้ง ่ายและลด ข้อผิดพลาด
ตัวอย่างการใช้งานดังรูปที่ 2.28

รูปที่ 2.28 ตัวอย่างการใช้งาน Python

### 2.15 ไลบรารีที่ใช้

ไลบรารีคือชุดของโค้ดที่ใช้บ่อยซึ่งนักพัฒนาสามารถใช้ในโปรแกรม Python เพื่อหลีกเลี่ยงการ เขียนโค้ดขึ้นใหม่ทั้งหมด ตามค่าเริ่มต้นแล้ว Python จะมาพร้อมกับไลบรารีมาตรฐาน ซึ่งมีฟังก์ชันที่ น ากลับมาใช้ใหม่ได้มากมาย นอกจากนี้ยังมีไลบรารีส าหรับการประยุกต์ใช้ต่างๆ รวมถึงการพัฒนาเว็บ วิทยาศาสตร์ข้อมูล และแมชชีนเลิร์นนิง (ML)

### 2.15.1 NumPy

NumPy (Numerical Python) คือไลบรารีที ่ใช้ในการท างานกับข้อมูลทางตัวเลขใน ภาษา Python โดยเฉพาะในงานที่เกี่ยวข้องกับการค านวณทางคณิตศาสตร์ที่จ าเป็นส าหรับ Deep Learning หรือด าเนินการทางตรรกะในอาเรย์หลายมิติ หรือแมทริกซ์ได้อย่างรวดเร็ว เพราะไลบรารี เขียนด้วยภาษา C ที่คอมไพล์ไว้แล้ว
NumPy มีความสามารถในการจัดการกับข้อมูลแบบแมทริกซ์ (Matrix) และอาเรย์ (Array) หลายมิติได้หลายวิธี โมดูลนี้สามารถสร้างข้อมูลชนิดอาเรย์ที่ภาษา Python ไม่มี และค านวณ อาเรย์ของตัวเลข สตริง (String) และวัตถุได้
วิธีการติดตั้ง
ท าการติดตั้ง ด้วย pip ดังรูปที่ 2.29

รูปที่ 2.29 ติดตั้ง Numpy

47

การเรียกใช้งาน Numpy ดังรูปที่ 2.30

รูปที่ 2.30 เรียกใช้Numpy

ตัวอย่างการใช้งานดังรูปที่ 2.31

รูปที่ 2.31 ตัวอย่างการใช้งาน Numpy

### 2.15.2 Flask

Flaskเป็นเว็บเฟรมเวิร์กขนาดเล็ก (Micro-framework) ส าหรับภาษา Python ที่ท างาน บนมาตรฐาน WSGI (Web Server Gateway Interface) มีจุดเด่นคือความเบา (Lightweight) ติดตั้ง ง่าย และมีความยืดหยุ่นสูง

วิธีการติดตั้ง
ท าการติดตั้ง ด้วย pip ดังรูปที่ 2.32

รูปที่ 2.32 ติดตั้ง Flask

การเรียกใช้งาน Flask ดังรูปที่ 2.33

รูปที่ 2.33 เรียกใช้งาน Flask

48

ตัวอย่างการใช้งานดังรูปที่ 2.34

รูปที่ 2.34 ตัวอย่างการใช้งาน Flask

### 2.15.3 Scikit-learn

Scikit-learn เป็นไลบรารี Python แบบโอเพนซอร์ส (Open-source) ส าหรับงานด้าน การเรียนรู้ของเครื่อง (Machine Learning - ML) และการวิเคราะห์ข้อมูล โดยมีเครื่องมือที่ใช้งานง่าย ครอบคลุมอัลกอริทึมที ่หลากหลาย ทั้งการจ าแนกประเภท (Classification), การถดถอย (Regression), การจัดกลุ่ม (Clustering) และการลดมิติข้อมูล (Dimensionality Reduction) สร้าง บนรากฐานของ NumPy, SciPy และ Matplotlib
วิธีการติดตั้ง
ท าการติดตั้ง ด้วย pip ดังรูปที่ 2.35

รูปที่ 2.35 ติดตั้ง Scikit learn

การเรียกใช้งาน Scikit-learn ดังรูปที่ 2.36

รูปที่ 2.36 เรียกใช้Scikit learn

ตัวอย่างการใช้งานดังรูปที่ 2.37

รูปที่ 2.37 ตัวอย่างการใช้งาน Scikit learn

49

### 2.15.4 Pandas

เป็นไลบรารีในภาษา Python ที ่ใช้ส าหรับการจัดการข้อมูลและการวิเคราะห์ข้อมูล โดยเฉพาะการท างานกับข้อมูลในรูปแบบของตาราง เช่น การจัดการข้อมูลที่มีลักษณะเป็นแถวและ คอลัมน์ เช่น ข้อมูลในไฟล์ CSV, Excel, หรือฐานข้อมูลต่างๆ ไลบรารีนี้ช่วยให้การท างานกับข้อมูล ขนาดใหญ่และซับซ้อนเป็นเรื่องง่ายขึ้น
คุณสมบัติหลักของ Pandas
1. DataFrame โครงสร้างข้อมูลหลักที่ใช้ใน Pandas คือ DataFrame ซึ่งเป็น ตารางข้อมูลที่มีแถวและคอลัมน์ คล้ายกับข้อมูลในสเปรดชีตหรือฐานข้อมูล
2. Series เป็นโครงสร้างข้อมูลที่คล้ายกับแถวเดียวของ DataFrame ซึ่งจัดเก็บข้อมูล ในรูปแบบของ
3. การอ่านและเขียนข้อมูล สามารถอ่านและเขียนข้อมูลจากไฟล์ต่าง ๆ เช่น CSV, Excel, SQL databases และไฟล์ JSON ได้อย่างง่ายดาย
4. การจัดการข้อมูล สามารถท าการคัดเลือก กรอง สรุป เปลี่ยนแปลงรูปแบบข้อมูล และการจัดการค่าที่หายไปได้อย่างมีประสิทธิภาพ
5. การค านวณและการสรุปข้อมูล รองรับการค านวณเชิงสถิติ การค านวณทาง คณิตศาสตร์ และการท าการค านวณเชิงกลยุทธ์ เช่น การค านวณค่าเฉลี่ย ค่าผลรวม หรือการหา ความสัมพันธ์ในข้อมูล

ค าสั่งติดตั้งใช้งานดังรูปที่ 2.38

รูปที่ 2.38 ติดตั้ง Pandas

การเรียกใช้งาน Pandas ดังรูปที่ 2.39

รูปที่ 2.39 เรียกใช้Pandas

50

ตัวอย่างการใช้งานดังรูปที่ 2.40

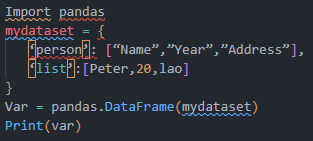
[picture p35: figure]

รูปที่ 2.40 ตัวอย่างการใช้งาน Pandas

### 2.15.5 Socket Library

Socket เป็นไลบรารีมาตรฐานที ่มาพร้อมกับภาษา Python (Python Standard Library) ออกแบบมาส าหรับการสื ่อสารผ ่านเครือข ่ายในระดับต ่า (Low-level Networking Interface) โดยรองรับโปรโตคอลการสื่อสารหลักทั้ง TCP (Transmission Control Protocol) และ UDP (User Datagram Protocol) ไลบรารีนี้ช่วยให้นักพัฒนาสามารถสร้างช่องทางการรับส่งข้อมูล ระหว่างอุปกรณ์บนเครือข่ายได้โดยตรง โดยไม่จ าเป็นต้องพึ่งพาเฟรมเวิร์กภายนอก
เนื่องจาก Socket เป็นส่วนหนึ่งของ Python Standard Library จึงไม่จ าเป็นต้องติดตั้ง เพิ่มเติมส าหรับการใช้งานพื้นฐาน อย่างไรก็ตาม หากต้องการใช้งานในรูปแบบ asynchronous หรือ event-driven สามารถติดตั้งไลบรารีเสริม python-socketio ได้ผ่านค าสั่งต่อไปนี้

ค าสั่งติดตั้งใช้งานดังรูปที่ 2.41

รูปที่ 2.41 ติดตั้ง Socket Library

การเรียกใช้งานไลบรารีSocket ดังรูปที่ 2.42

รูปที่ 2.42 เรียกใช้Socket

51

ตัวอย่างโค้ดส าหรับการใช้งานในฝั่ง Server มีดังนี้

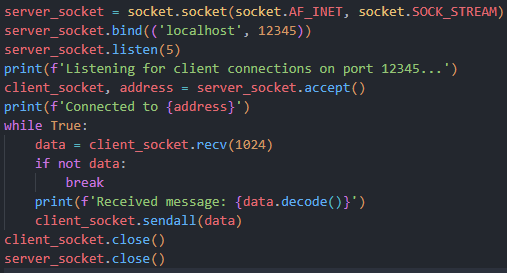
[picture p36: figure]

รูปที่ 2.43 ตัวอย่างการใช้งาน Socket

จากรูปที่ 2.43 ขั้นตอนการท างานของ Server แบ่งออกเป็น 3 ขั้นตอนหลัก ดังนี้
1. การตั้งค่า Server socket.socket (AF_INET, SOCK_STREAM) สร้าง TCP socket ส าหรับการสื่อสารผ่านเครือข่าย IPv4 จากนั้น bind () ผูก socket เข้ากับ localhost หมายเลขพอร์ต 12345 และ listen(5) ก าหนดให้ Server พร้อมรับการเชื่อมต่อพร้อมกันสูงสุด 5 รายการในคิว
2. การรับการเชื่อมต่อ accept () หยุดรอการท างาน (blocking) จนกว่า Client จะส่งค า ขอเชื่อมต่อเข้ามา เมื่อมีการเชื่อมต่อส าเร็จ ฟังก์ชันจะคืนค่า client_socket ส าหรับใช้รับส่งข้อมูล และ address ซึ่งระบุ IP address และหมายเลขพอร์ตของ Client
3. การรับและส ่งข้อมูล (Echo Loop) ภายใน while True Server จะรับข้อมูลทีละ 1,024 bytes ผ่าน recv(1024) แล้วแสดงผลข้อความที่รับมา จากนั้น sendall() ส่งข้อมูลชุดเดิม กลับไปยัง Client ทันที การวนซ ้าจะสิ้นสุดลงเมื่อ Client ปิดการเชื่อมต่อ ซึ่ง recv() จะคืนค่า b"" และ Server จะปิด socket ทั้งสองด้วย close ()
การท างานของ Client
ตัวอย่างโค้ดส าหรับการใช้งานในฝั่ง Client มีดังรูปที่ 2.44

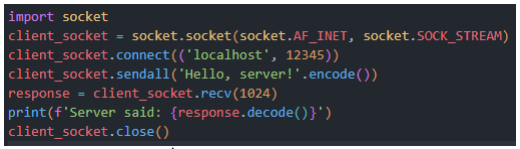
[picture p37: figure]

รูปที่ 2.44 ตัวอย่างโค้ดของ Client

52

socket.socket(AF_INET, SOCK_STREAM) สร้าง TCP socket จากนั้น connect() ส่งค าขอเชื่อมต่อไปยัง localhost หมายเลขพอร์ต 12345 ซึ่งต้องตรงกับค่าที่ก าหนดไว้ในฝั่ง Server เมื ่อเชื ่อมต ่อส าเร็จ sendall() จะแปลงข้อความ "Hello, server!" ให้อยู ่ในรูปแบบ bytes ด้วย .encode() แล้วส่งไปยัง Server จากนั้น recv(1024) รอรับข้อมูลที่ Server ส่งกลับมา แล้วแปลงกลับ เป็น string ด้วย .decode() เพื่อแสดงผล และปิด socket ด้วย close() เมื่อสิ้นสุดการท างาน ผลลัพธ์ที่ได้รับเมื่อรันระบบ
เมื่อเริ่มต้น Server ก่อนแล้วจึงรัน Client ระบบจะแสดงผลลัพธ์ดังรูปที่ 2.45

รูปที่ 2.45 Server

การตอบกลับของ Server ดังรูปที่ 2.46

รูปที่ 2.46 Client

บทที่3
การวิเคราะห์และออกแบบระบบ

ในบทนี้น าเสนอกระบวนการวิเคราะห์และออกแบบ ระบบถุงมือแปลภาษามือแบบข้างเดียว (Single-Hand Sign Language Translator Glove) โดยครอบคลุมการวิเคราะห์ข้อจ ากัดของระบบ เดิม การก าหนดความต้องการของระบบใหม่ และการออกแบบโครงสร้างระบบทั้งด้านฮาร์ดแวร์ วงจร และแบบจ าลองปัญญาประดิษฐ์ ที่พัฒนาขึ้นเพื่อใช้งานได้จริงในบริบทของการสื่อสารระหว่างผู้พิการ ทางการได้ยินกับบุคคลทั่วไป

### 3.1 วิเคราะห์ระบบเดิม

ผู้พิการทางการได้ยินในปัจจุบันมีแนวทางสื่อสารกับบุคคลทั่วไปอยู่หลายรูปแบบ แต่ละรูปแบบ ล้วนมีข้อจ ากัดที่ส่งผลต่อชีวิตประจ าวัน ผู้จัดท าจึงศึกษาแนวทางที่ใช้งานจริงอยู่ในปัจจุบัน แบ่งได้เป็น 3 กลุ่มดังนี้

### 3.1.1 การสื่อสารผ่านล่ามภาษามือ

ผู้พิการทางการได้ยินส่วนใหญ่ยังต้องพึ่งพาล่ามภาษามือในการสื่อสารกับบุคคลทั่วไป วิธีนี้ มีข้อจ ากัดด้านความพร้อมใช้งานและค่าใช้จ่าย โดยเฉพาะในสถานการณ์เร่งด่วนหรือพื้นที่ที่ขาดแคลน ล่าม จึงไม่ใช่ทางออกส าหรับการใช้งานประจ าวัน

### 3.1.2 ระบบแปลภาษามือด้วยกล้องและการประมวลผลภาพ

ระบบแปลภาษามือที่ใช้แพร่หลายในระบบเดิม ส่วนใหญ่ใช้กล้องเว็บแคมหรือกล้องสมาร์ท โฟนร่วมกับอัลกอริทึมทางคอมพิวเตอร์วิทัศน์ (Computer Vision) เช่น Convolutional Neural Network (CNN) หรือ MediaPipe เพื่อตรวจจับและแปลท่าทางมือจากภาพวิดีโอ วิธีนี้มีข้อดีคือ ผู้ใช้งานไม่ต้องสัมผัสร่างกายและสามารถติดตั้งใช้งานได้สะดวก อย่างไรก็ตาม ระบบประเภทนี้ยังมี ข้อจ ากัดหลายประการ ได้แก่
- ความแม่นย า ประสิทธิภาพขึ้นอยู่กับสภาพแสง มุมกล้อง และพื้นหลังของภาพเป็น ส าคัญ
- ความหน่วงเวลา (Latency) มีความหน่วงสูงเนื่องจากกระบวนการประมวลผลภาพ แบบเฟรมต่อเฟรม (Frame-by-Frame)

54

- ฮาร์ดแวร์ต้องการอุปกรณ์ที่มีประสิทธิภาพสูงในการประมวลผลโมเดล CN
- สภาพแวดล้อม ไม่เหมาะส าหรับการใช้งานกลางแจ้งหรือในสภาวะที่มีแสงน้อย

### 3.1.3 ระบบถุงมือแปลภาษามือแบบเดิม (Sensor-based Glove)

งานวิจัยบางชิ้นได้พัฒนาถุงมือติดเซนเซอร์ขึ้นมาเช ่นกัน แต ่มีการใช้สถาปัตยกรรมที่ แตกต่างออกไป เช่น การใช้บอร์ด Arduino Uno ซึ่งมีข้อจ ากัดด้านความเร็วในการประมวลผลและ การสื่อสารไร้สาย หรือการใช้เทคโนโลยี Bluetooth ในการส่งข้อมูล ซึ่งมีช่วงสัญญาณที่จ ากัด นอกจากนี้ ระบบเดิมส่วนใหญ่ยังเก็บข้อมูลเป็นค่าเดี่ยว (Single Frame) ซึ่งไม่เพียงพอ ส าหรับการรู้จ าท่าทางที่มีการเคลื่อนไหวต่อเนื่อง เช่น ท่าภาษามือตัวอักษร J, Z ส่งผลให้ความแม่นย า ในการจดจ าท่าทางต ่ากว่าที่ควรจะเป็น

### 3.2 วิเคราะห์ระบบใหม่

ระบบใหม่ที่พัฒนาขึ้นเป็นถุงมือแปลภาษามือแบบข้างเดียว (Single-Hand Sign Language Translator Glove) ที ่เชื ่อมต ่อกับเว็บแอปพลิเคชัน เพื ่อใช้งานจริงในการสื ่อสารระหว ่างผู้พิการ ทางการได้ยินกับบุคคลทั่วไป ระบบนี้ถูกออกแบบมาเพื่อให้การตรวจจับท่าทาง การส่งข้อมูล และการ แสดงผลค าแปลเป็นไปอย่างรวดเร็วและแม่นย า โดยไม่ต้องพึ่งพาล่ามภาษามือหรือกล้องถ่ายภาพ เหมือนระบบเก่า นอกจากนี้ยังรองรับการใช้งานได้ทั้งในที่แจ้งและที่มีแสงน้อย เพื่อให้พนักงานหรือ บุคคลทั่วไปสามารถอ่านค าแปลบนหน้าจอเว็บแอปพลิเคชันได้แบบเรียลไทม์
ระบบใหม่นี้แบ่งการท างานออกเป็น 3 ส่วนหลักที่เชื่อมโยงกัน คือ ฮาร์ดแวร์ตรวจวัดบนถุงมือ ระบบสื่อสารไร้สาย และแบบจ าลองปัญญาประดิษฐ์ส าหรับจ าแนกท่าทาง โดยแต่ละส่วนถูกออกแบบ มาเพื่อแก้ปัญหาที่วิเคราะห์ไว้มีรายละเอียดดังนี้
1. จัดท าระบบตรวจจับท่าทางด้วยเซนเซอร์บนถุงมือ เพื่อจัดการปัญหาความแม่นย าที่ขึ้นกับ สภาพแวดล้อมในระบบเก่า ระบบใหม่เปลี่ยนจากการใช้กล้องและการประมวลผลภาพมาเป็นการ ติดตั้ง Flex Sensor และเซนเซอร์ตรวจจับความเคลื่อนไหว MPU6050 ไว้บนถุงมือโดยตรง ท าให้ผล การตรวจจับไม่ขึ้นกับสภาพแสง มุมกล้อง หรือพื้นหลังอีกต่อไป และใช้งานได้ทั้งในที่แจ้งและที่มีแสง น้อย โดยไม่ต้องอาศัยฮาร์ดแวร์ประมวลผลภาพราคาสูงเหมือนระบบเดิม
2. จัดท าระบบสื่อสารไร้สายความหน่วงต ่า เพื่อจัดการปัญหาความเร็วในการประมวลผลและ ระยะสัญญาณของถุงมือเซนเซอร์แบบเก่า ระบบใหม่เปลี่ยนจากไมโครคอนโทรลเลอร์ Arduino Uno และการสื่อสารผ่าน Bluetooth มาใช้ ESP32 ซึ่งมีสมรรถนะการประมวลผลสูงกว่าและมีโมดูล Wi-Fi

55

ในตัว ร่วมกับโปรโตคอล UDP ที่มีความหน่วงต ่า ท าให้ข้อมูลจากเซนเซอร์ถูกส่งไปประมวลผลได้อย่าง รวดเร็วและต่อเนื่อง
3. จัดท าระบบเก็บข้อมูลแบบล าดับเวลาต ่อเนื่อง เพื่อจัดการปัญหาการจดจ าท่าทางที่มีการ เคลื ่อนไหว แทนที ่จะเก็บข้อมูลเป็นค ่าเดี ่ยวเหมือนระบบเดิมซึ ่งไม ่เพียงพอส าหรับท ่าทางอย ่าง ตัวอักษรที่มีการเคลื่อนไหว ระบบใหม่จะเก็บสัญญาณเซนเซอร์ต่อเนื่องเป็นชุดข้อมูล 60 เฟรมต่อ ท ่าทาง เพื ่อบันทึกลักษณะการเคลื ่อนไหวได้ครบถ้วนตลอดช ่วงเวลาที ่ท ่าทางเกิดขึ้น ก ่อนน าไป วิเคราะห์ด้วยแบบจ าลองปัญญาประดิษฐ์ในล าดับถัดไป
4. จัดท าระบบจ าแนกท่าทางด้วยปัญญาประดิษฐ์และแสดงผล เพื่อจัดการปัญหาการพึ่งพาล่าม ภาษามือ ระบบใหม่จะน าข้อมูลล าดับเวลาที่เก็บได้ไปประมวลผลด้วยแบบจ าลองโครงข่ายประสาท เทียมหลายชั้น ซึ ่งเหมาะกับข้อมูลเชิงตัวเลขมิติต ่าจากเซนเซอร์ ท าให้ประมวลผลได้รวดเร็วด้วย ทรัพยากรคอมพิวเตอร์ที่จ ากัด แล้วแสดงผลค าแปลเป็นข้อความบนเว็บแอปพลิเคชันทันทีท าให้ผู้ พิการทางการได้ยินสื่อสารกับบุคคลทั่วไปได้ด้วยตนเองโดยไม่ต้องรอล่าม

### 3.3 การออกแบบวงจรฮาร์ดแวร์ (Hardware Circuit Design)

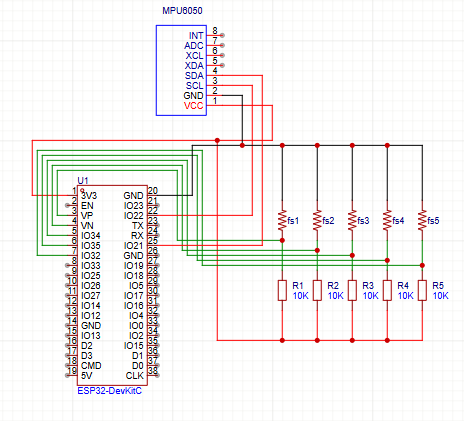
[picture p38: figure]

รูปที่ 3.1 การออกแบบวงจร

จากรูปที่ 3.1 เนื่องจาก Flex Sensor ให้ค่าออกมาเป็นความต้านทาน ซึ่งไมโครคอนโทรลเลอร์ ไม ่สามารถอ่านค ่าได้โดยตรง จึงต้องใช้วงจรแบ ่งแรงดัน (โดยน า Flex Sensor ต ่ออนุกรมกับตัว

56

ต้านทานคงที่ขนาด 10 kΩ และต่อจุดกึ่งกลางเข้ากับขา Analog-to-Digital Converter ของ ESP32 และก าหนดขาสัญญาณของ ESP32 ดังตารางที่ 3.1

ตารางที่ 3.1 รายละเอียดขาของ Flex Sensor
อุปกรณ์ | หน้าที่ | ขา ESP 32
Flex Sensor 1 | นิ้วโป้ง | GPIO 36 (VP)
Flex Sensor 2 | นิ้วชี้ | GPIO 39 (VN)
Flex Sensor 3 | นิ้วกลาง | GPIO 34
Flex Sensor 4 | นิ้วนาง | GPIO 35
Flex Sensor 5 | นิ้วก้อย | GPIO 32

การเชื่อมต่อ MPU6050 เซนเซอร์ MPU6050 ส่งข้อมูลแบบดิจิทัลผ่านโปรโตคอล I2C จึงท า การเชื่อมต่อกับขา GPIO ของ ESP32 ดังตารางที่ 3.2

ตารางที่ 3.2 รายละเอียดขาของ MPU 6050
อุปกรณ์ | หน้าที่ | ขา ESP 32
MPU6050 | I2C Data | GPIO 21
MPU6050 | I2C Clock | GPIO 22

### 3.4 Flowchart การท างานของระบบ

ขั้นตอนการด าเนินงานของระบบถูกออกแบบมาเพื่อให้เกิดความแม่นย าตั้งแต่การตรวจวัดไป จนถึงการแสดงผล

57

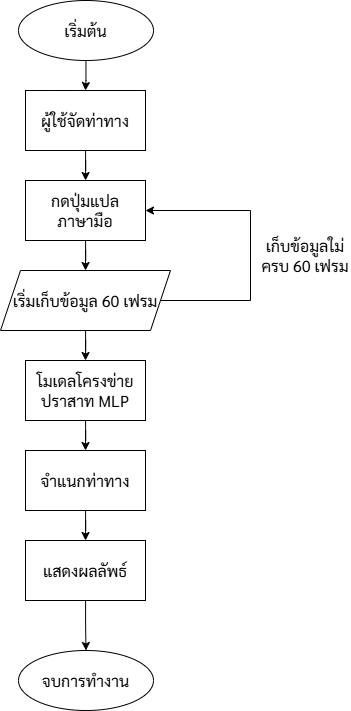
[picture p39: figure]

รูปที่ 3.2 Flowchart การท างานของระบบ

จากรูปที ่ 3.2 ระบบเริ ่มต้นการท างานเมื ่อผู้ใช้จัดท ่าทางมือตามภาษามือที ่ต้องการสื ่อสาร จากนั้นผู้ใช้จะกดปุ่มแปลภาษามือ เพื่อเริ่มกระบวนการแปลผล
เมื ่อกดปุ ่มแล้ว ระบบจะเริ่มเก็บข้อมูล 60 เฟรม จากเซนเซอร์บนถุงมือ (Flex Sensor และ MPU6050) อย่างต่อเนื่อง ในจุดนี้มีเงื่อนไขตรวจสอบว่า หากเก็บข้อมูลยังไม่ครบ 60 เฟรม ระบบจะ วนกลับไปเก็บข้อมูลเพิ่มจนกว่าจะครบจ านวนที่ก าหนด (ลูปด้านขวาของ Flowchart)

58

เมื่อเก็บข้อมูลครบ 60 เฟรมแล้ว ข้อมูลจะถูกส ่งเข้าสู ่โมเดลโครงข ่ายประสาท MLP (Multi-Layer Perceptron) เพื่อประมวลผลและจ าแนกท่าทาง ว่าตรงกับตัวอักษรหรือค าใดในชุดข้อมูลที่ฝึก ไว้
จากนั้นระบบจะแสดงผลลัพธ์ เป็นข้อความบนหน้าจอ (ผ่าน Web Application) ให้ผู้ใช้เห็น ทันที และจบการท างานของรอบนั้น

### 3.5 ขั้นตอนการด าเนินงาน

โดยได้แบ่งการด าเนินงานเป็น 2 ส่วน ได้แก่ การด าเนินงานในส่วนของ Hardware และการ ด าเนินงานในส่วนของ Software

### 3.5.1 การด าเนินงานในส่วน Hardware

สามารถแบ่งได้2 ส่วนดังนี้
1. ชิ้นส่วนของถุงมือแปลภาษามือข้างเดียว โดยประกอบด้วย
- Flex Sensor เซนเซอร์วัดการโค้งงอ (Flex Sensor) จัดเป็นเซนเซอร์ในกลุ่ม Analog Sensor ที่ท าหน้าที่แปลงการเปลี่ยนแปลงทางกลศาสตร์ หรือการบิดงอทางกายภาพ ให้ กลายเป็นการเปลี่ยนแปลงทางไฟฟ้า โดยตัวเซนเซอร์มีคุณลักษณะเป็น ตัวต้านทานแปรค่าตามแรงกล (Variable Resistor) ซึ ่งค ่าความต้านทานภายในจะแปรผันตรงกับระดับองศาของความโค้งงอ มีลักษณะ ดังรูปที่ 3.3


รูปที่ 3.3 Flex Sensor

- MPU 6050 คือโมดูลเซนเซอร์ตรวจจับการเคลื ่อนไหวประเภท IMU (Inertial Measurement Unit) ที่รวมเอาเซนเซอร์วัดความเร่ง (Accelerometer) และเซนเซอร์วัดความเร็ว

59

เชิงมุม (Gyroscope) เข้าไว้ด้วยกันบนชิปซิลิคอนขนาดเล็กเพียงตัวเดียว โดยใช้เทคโนโลยีโครงสร้าง เครื่องกลไฟฟ้าจุลภาค หรือ MEMS (Micro-Electro-Mechanical Systems) โมดูลนี้มีความสามารถ ในการตรวจจับการเคลื ่อนไหวและทิศทางในอวกาศได้ทั้งหมด 6 แกนอิสระ (6 Degrees of Freedom: 6-DOF) มีลักษณะ ดังรูปที่ 3.4


รูปที่ 3.4 MPU 6050

- ESP 32 เป็นชิปไมโครคอนโทรลเลอร์ประเภทระบบบนชิปเดี ่ยว หรือ SoC (System on a Chip) ขนาด 32 บิต มีสมรรถนะการประมวลผลความเร็วสูง มีหน่วยความจ าภายใน ที ่เพียงพอ และที ่ส าคัญคือมีโมดูลการสื ่อสารไร้สาย (Wireless Connectivity) ทั้ง Wi-Fi และ Bluetooth มีลักษณะ ดังรูปที่ 3.5


รูปที่ 3.5 ESP32

60

2. ขั้นตอนการประกอบระบบถุงมือแปลภาษามือข้างเดียวเริ่มต้นจากการติดตั้ง Flex Sensor จ านวน 5 ตัว ลงบนถุงมือบริเวณแนวของนิ้วมือแต่ละนิ้วเพื่อตรวจวัดระดับการโค้งงอ จากนั้น จึงด าเนินการติดตั้งเซนเซอร์ MPU6050 และไมโครคอนโทรลเลอร์ ESP32 ลงบนบอร์ดวงจร (PCB) ที่ ถูกออกแบบมาโดยเฉพาะ และติดตั้งชุดอุปกรณ์ทั้งหมดไว้บริเวณหลังมือ เพื่อให้ผู้ใช้งานสามารถ เคลื ่อนไหวได้อย ่างอิสระ โดยขั้นตอนสุดท้ายคือการเชื่อมต ่อวงจรไฟฟ้าทั้งหมดด้วยวิธีการบัดกรี เพื่อให้มั่นใจในความมั่นคงแข็งแรงของจุดเชื่อมต่อและประสิทธิภาพในการรับ-ส่งสัญญาณไฟฟ้าตลอด การใช้งาน
- น า Flex Sensor ทั้ง 5 ตัวมาติดตั้งลงบนนิ้วแต่ละนิ้วดังรูปที่ 3.7


รูปที่ 3.6 การติดตั้ง Flex Sensor

- ติดตั้งเซนเซอร์ MPU6050 และไมโครคอนโทรลเลอร์ ESP32 ลงบนบอร์ด PCB ดัง รูปที่ 3.7

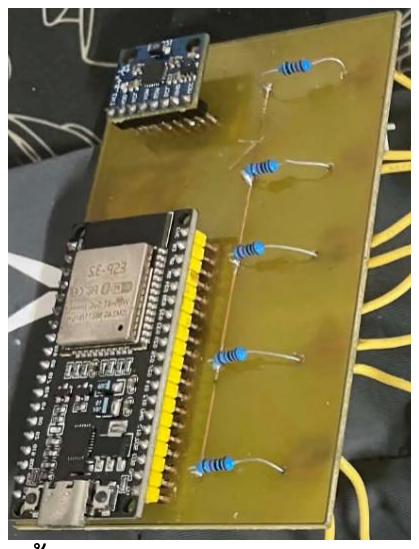
[picture p40: figure]

รูปที่ 3.7 ติดตั้ง ESP32 และ MPU6050 ลงบนบอร์ด

61

- ท าการเชื่อม Flex Sensor และ MPU6050 เข้ากับขาของ ESP32 ที่ต้องการใช้ ด้วย วิธีการบัดกรี ดังรูปที่ 3.8


รูปที่ 3.8 บัดกรีอุปกรณ์ทั้งหมด

### 3.5.2 การด าเนินงานในส่วนของ Software

ในส่วนของซอฟต์แวร์ ระบบถุงมือแปลภาษามือข้างเดียวถูกพัฒนาด้วยภาษา Python เป็น หลัก โดยแบ่งการท างานออกเป็นสองส่วนหลัก คือ ฝั่งไมโครคอนโทรลเลอร์และฝั่งคอมพิวเตอร์ ดังนี้
- โปรแกรมฝั่ง ESP32 พัฒนาด้วย Arduino IDE (ภาษา C++) ท าหน้าที่อ่านค่าจาก Flex Sensor และเซนเซอร์ MPU6050 จากนั้นท าการจัดรูปแบบข้อมูลเป็น JSON และส่งผ่านโปรโตคอล UDP ไปยังคอมพิวเตอร์ด้วยอัตราการส่งข้อมูล 60 เฟรมต่อท่าทาง
- โปรแกรมรับข้อมูลและประมวลผลฝั่งคอมพิวเตอร์ พัฒนาด้วยภาษา Python ร่วมกับ ไลบรารีsocket เพื่อรับข้อมูลผ่าน UDP Port 4210 และจัดเก็บข้อมูลในรูปแบบ Sliding Window ขนาด 660 มิติ
- การจัดการข้อมูล ใช้ไลบรารีNumPy และ Pandas ในการจัดการและแปลงข้อมูลเชิง ตัวเลขให้อยู่ในรูปแบบที่เหมาะสมก่อนน าเข้าสู่โมเดลปัญญาประดิษฐ์

62

- การสร้างและฝึกสอนแบบจ าลอง ใช้ไลบรารีScikit-learn ส าหรับสร้างและฝึกสอน แบบจ าลอง MLP รวมถึงท า Feature Scaling ด้วย StandardScaler พร้อมบันทึกผลลัพธ์เป็นไฟล์ โมเดล (model.pkl) และไฟล์ตัวปรับสเกล (scaler.pkl)
- การแสดงผล พัฒนาเว็บแอปพลิเคชันด้วยเฟรมเวิร์ก Flask เพื่อรับผลการท านายจาก โมเดลและแสดงผลข้อความแปลท่าทางแบบเรียลไทม์ผ่านหน้าเว็บเบราว์เซอร์
- การทดสอบระบบ จัดท าสคริปต์ตรวจสอบผ่าน Terminal แยกต่างหาก เพื่อใช้ส าหรับ การทดสอบความถูกต้องของโมเดลโดยไม่ต้องผ่านหน้าเว็บแอปพลิเคชัน

### 3.6 การสร้าง Dataset

เนื่องจากไม่มีชุดข้อมูลมาตรฐานที่ตรงกับฮาร์ดแวร์ที่พัฒนาขึ้น คณะผู้จัดท าจึงด าเนินการสร้าง ชุดข้อมูลขึ้นใหม่ โดยมีรายละเอียดดังนี้

### 3.6.1 โครงสร้างของชุดข้อมูล

ชุดข้อมูลส าหรับโครงงานนี้ประกอบด้วยข้อมูลจากเซนเซอร์ต่างๆ ที่อ่านค ่าจากถุงมือ พร้อมทั้งป้ายก ากับ (Label) ของท่าภาษามือที่ต้องการแปล โดยโครงสร้างข้อมูลถูกออกแบบมาให้ เหมาะสมกับการประมวลผลและการฝึกสอนโมเดล (Model Training) ดังแสดงในตารางที่ 3.3

ตารางที่ 3.3 โครงสร้างชุดข้อมูล
ชื่อคอลัมน์ | รายละเอียด
label | ป้ายชื่อท่าภาษามือ (A–Z / ค า)
thumb / โป้ง | ค่า Flex Sensor ของนิ้วโป้ง
index / ชี้ | ค่า Flex Sensor ของนิ้วชี้
middle / กลาง | ค่า Flex Sensor ของนิ้วกลาง
ring / นาง | ค่า Flex Sensor ของนิ้วนาง
pinky / ก้อย | ค่า Flex Sensor ของนิ้วก้อย

63

ตารางที่ 3.3 โครงสร้างชุดข้อมูล (ต่อ)
ชื่อคอลัมน์ | รายละเอียด
acc_x | ค่า Accelerometer แกน X
acc_y | ค่า Accelerometer แกน Y
acc_z | ค่า Accelerometer แกน Z
gyro_x | ค่า Gyroscope แกน X
gyro_y | ค่า Gyroscope แกน Y
gyro_z | ค่า Gyroscope แกน Z

### 3.6.2 การเตรียมอุปกรณ์และซอฟต์แวร์

- การจัดท าฮาร์ดแวร์ประกอบถุงมือที่ติดตั้ง Flex Sensor จ านวน 5 ตัว บริเวณนิ้วมือ และเซนเซอร์ MPU6050 โดยเชื่อมต่อเข้ากับไมโครคอนโทรลเลอร์ ESP32
- การตั้งค่าเครือข่าย ก าหนดให้ ESP32 เชื่อมต่อกับเครือข่าย Wi-Fi เดียวกันกับเครื่อง คอมพิวเตอร์ และท าหน้าที่เป็นตัวส่งข้อมูลผ่านโปรโตคอล UDP ไปยังพอร์ต 4210
- การเตรียมซอฟต์แวร์ส่วนรับข้อมูล พัฒนาด้วยภาษา Python ร่วมกับไลบรารีsocket เพื่อท าหน้าที่เป็นเซิร์ฟเวอร์ในการรับข้อมูลและจัดการจัดเก็บชุดข้อมูลแบบกึ่งอัตโนมัติ

### 3.6.3 ขั้นตอนการเก็บรวบรวมชุดข้อมูล

ขั้นตอนการสร้างชุดข้อมูลเริ่มต้นโดยให้ผู้สวมถุงมือจัดท่าทางภาษามือที่ต้องการเก็บข้อมูล และคงท่าทางนั้นไว้อย่างนิ่งที่สุด จากนั้นผู้เก็บข้อมูลจะด าเนินการกดปุ่มบันทึก (Save) ผ่านโปรแกรม บนคอมพิวเตอร์
เมื่อเริ่มต้นบันทึก ระบบจะด าเนินการอ่านค่าจาก Flex Sensor ทั้ง 5 ตัว และเซนเซอร์ MPU6050 อย่างต่อเนื่องจนครบจ านวน 60 เฟรม โดยตลอดระยะเวลาการบันทึก ผู้สวมถุงมือจะต้อง รักษาท่าทางเดิมไว้ไม่ให้เกิดการเปลี่ยนแปลง เพื่อให้ข้อมูลที่อ่านได้ในแต่ละเฟรมมีความสม ่าเสมอและ สะท้อนถึงท่าทางนั้นได้อย่างถูกต้องแม่นย า เมื่อระบบท าการบันทึกข้อมูลครบทั้ง 60 เฟรม ข้อมูล ทั้งหมดจะถูกจัดเก็บลงในไฟล์รูปแบบ JSON พร้อมระบุป้ายก ากับ (Label) ของท ่าทางนั้นโดย อัตโนมัติ ทั้งนี้ ขั้นตอนดังกล่าวจะถูกด าเนินการซ ้าหลายครั้งส าหรับทุกท่าทาง เพื่อให้ได้ชุดข้อมูลที่มี

64

ความหลากหลายและมีปริมาณเพียงพอส าหรับการฝึกสอนโมเดลปัญญาประดิษฐ์ให้มีความแม่นย า สูงสุด ดังรูปที่ 3.9

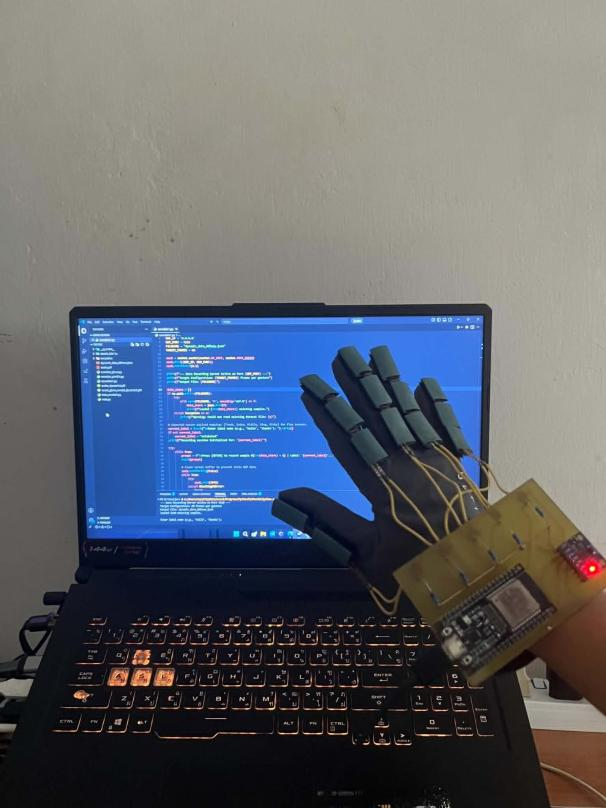
[picture p41: figure]

รูปที่ 3.9 ขั้นตอนการเก็บข้อมูล

### 3.6.4 การวิเคราะห์โครงสร้างโปรแกรมเก็บข้อมูล

โปรแกรมรับข้อมูลถูกออกแบบให้ท างานแบบ Interative เพื่อให้ผู้เก็บข้อมูลสามารถ ตรวจสอบความถูกต้องของท่าทางก่อนบันทึกได้ โดยมีส่วนประกอบหลักดังนี้
- การตั้งค่าการเชื่อมต่อ UDP

รูปที่ 3.10 โค้ดตั้งค่า UDP

จากรูปที่ 3.10 ท าหน้าที่เปิดพอร์ตสื่อสารในเครื่องคอมพิวเตอร์เพื่อรอรับแพ็กเก็ตข้อมูล จาก ESP32 โดยใช้โปรโตคอล UDP

65

- กระบวนการล้างข้อมูลค้างคา

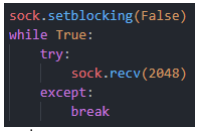
[picture p42: figure]

รูปที่ 3.11 โค้ดล้าง Buffer

จากรูปที่ 3.11 ท าหน้าที่ป้องกันไม่ให้ข้อมูลเก่าที่ตกค้างอยู่ใน Buffer ของเครือข่ายถูก น ามาบันทึก ระบบจะล้างข้อมูลที่ค้างอยู่ในคิวทิ้งทั้งหมดก่อนจะเริ่มบันทึกข้อมูล 60 เฟรมใหม่ในทุก ครั้งที่กดปุ่ม
- การรวบรวมข้อมูลช่วงเวลา

รูปที่ 3.12 โค้ดรวบรวมข้อมูล

จากรูปที่ 3.12 ระบบจะท าการสะสมข้อมูลต่อเนื่องจ านวน 60 เฟรม โดยในแต่ละเฟรม ประกอบด้วยพารามิเตอร์ 11 ค่า (นิ้วมือ 5, ความเร่ง 3, ความเร็วเชิงมุม 3) เมื่อบันทึกครบถ้วน ข้อมูลชุดนี้จะถูกมองเป็น 1 ตัวอย่าง ของท่าทางนั้นๆ
- การจัดเก็บข้อมูลในรูปแบบ JSON

รูปที่ 3.13 โค้ดการจัดเก็บข้อมูล

66

จากรูปที่ 3.13 ข้อมูลจะถูกบันทึกในรูปแบบไฟล์ JSON เพื่อให้สามารถเก็บโครงสร้าง ข้อมูลแบบมิติได้อย่างสมบูรณ์ ซึ่งง่ายต่อการน าไปฝึกสอนโมเดลปัญญาประดิษฐ์ในขั้นตอนถัดไป

### 3.6.5 รูปแบบการเก็บข้อมูล

เพื่อให้ข้อมูลที่รวบรวมได้มีความเป็นระเบียบและสามารถน าไปใช้ในการฝึกสอนโมเดล ปัญญาประดิษฐ์ได้อย่างมีประสิทธิภาพ คณะผู้จัดท าจึงก าหนดรูปแบบการจัดเก็บข้อมูลในลักษณะ ของโครงสร้างข้อมูลเชิงมิติ (Multi-dimensional Data Structure) โดยบันทึกอยู่ในรูปแบบไฟล์ JSON ซึ่งแต่ละท่าทางจะถูกแทนด้วยล าดับข้อมูลต่อเนื่องจ านวน 60 เฟรม โดยในแต่ละเฟรมจะ ประกอบด้วยค่าจากเซนเซอร์ทั้งหมด 11 พารามิเตอร์ ได้แก่ ค่าการโค้งงอของนิ้วมือ 5 ค่า (นิ้วโป้ง นิ้วชี้ นิ้วกลาง นิ้วนาง และนิ้วก้อย) ค่าความเร่งเชิงเส้น 3 แกน (accx, accy, accz
) และค่า
ความเร็วเชิงมุม 3 แกน (gyrox, gyroy, gyroz

) ส ่งผลให้ข้อมูล 1 ตัวอย ่างของแต ่ละ ท่าทางมีขนาดรวมทั้งสิ้น 660 ค่า (60 เฟรม × 11 พารามิเตอร์) ซึ่งสอดคล้องกับขนาดของข้อมูล น าเข้า (Input) ของโมเดล MLP
ชุดข้อมูลที่เก็บรวบรวมครอบคลุมท่าทางทั้งหมด 31 ท่า แบ่งเป็นตัวอักษรภาษามือ A–Z จ านวน 26 ท่า และค าศัพท์พื้นฐานจ านวน 5 ค า ได้แก่ "Hello", "Thank you", "I love you", "Yes" และ "No" เพื่อให้เห็นลักษณะของข้อมูลในแต่ละมิติได้อย่างเป็นรูปธรรม คณะผู้จัดท าจึงได้จ าแนก ตัวอย่างค่าเฉลี่ยของข้อมูลเซนเซอร์ออกเป็น 3 กลุ่มตามแหล่งที่มา ได้แก่ ค่าจาก Flex Sensor, ค่า ความเร่ง (Accelerometer) และค่าความเร็วเชิงมุม (Gyroscope)
1. ข้อมูลจาก Flex Sensor

ตารางที่ 3.4 รูปแบบการเก็บข้อมูล Flex Sensor
ท่าทาง | เซนเซอร์นิ้วมือ (Flex Sensors)
โป้ง | ชี้ | กลาง | นาง | ก้อย
A | 2,873.82 | 3,355.90 | 3,574.78 | 3,845.30 | 3,233.38
B | 3,052.93 | 3,063.35 | 3,140.49 | 3,540.20 | 2,985.28
C | 2,949.79 | 3,276.07 | 3,559.56 | 3,796.72 | 3,146.26
D | 2,990.20 | 3,071.93 | 3,563.95 | 3,812.69 | 3,225.54
E | 3,109.88 | 3,518.75 | 3,638.06 | 3,867.02 | 3,280.54
F | 2,832.86 | 3,336.45 | 3,101.11 | 3,507.59 | 2,986.48

67

ตารางที่ 3.4 รูปแบบการเก็บข้อมูล Flex Sensor (ต่อ)
ท่าทาง | เซนเซอร์นิ้วมือ (Flex Sensors)
โป้ง | ชี้ | กลาง | นาง | ก้อย
G | 2,878.92 | 3,051.68 | 3,596.28 | 3,852.72 | 3,226.26
H | 2,905.95 | 3,063.96 | 3,151.21 | 3,682.26 | 3,185.40
I | 3,016.37 | 3,275.49 | 3,526.54 | 3,764.58 | 3,000.64
J | 2,850.18 | 3,318.53 | 3,508.81 | 3,762.12 | 3,002.86
K | 2,841.74 | 3,059.03 | 3,087.01 | 3,773.40 | 3,243.21
L | 2,881.51 | 3,078.98 | 3,603.34 | 3,849.00 | 3,321.07
M | 3,057.60 | 3,352.15 | 3,555.68 | 3,783.19 | 3,387.73
N | 2,703.23 | 3,242.16 | 3,422.70 | 3,732.40 | 3,275.20
O | 2,918.97 | 3,256.05 | 3,502.07 | 3,760.96 | 3,136.24
P | 2,796.76 | 3,021.38 | 3,273.37 | 3,695.00 | 3,224.21
Q | 2,856.24 | 3,059.54 | 3,613.06 | 3,889.77 | 3,291.62
R | 2,934.35 | 3,063.56 | 3,062.48 | 3,737.01 | 3,298.76
S | 3,013.35 | 3,326.97 | 3,545.87 | 3,844.36 | 3,268.52
T | 2,762.65 | 3,197.55 | 3,508.58 | 3,782.88 | 3,185.25
U | 2,905.03 | 3,026.24 | 3,086.91 | 3,738.34 | 3,225.94
V | 2,940.77 | 3,009.22 | 3,128.45 | 3,677.27 | 3,312.79
W | 2,940.40 | 3,003.11 | 3,119.03 | 3,517.94 | 3,414.34
X | 3,090.03 | 3,142.96 | 3,534.00 | 3,822.33 | 3,231.05
Y | 2,826.27 | 3,352.91 | 3,495.19 | 3,730.11 | 2,972.61
Z | 2,852.07 | 3,019.54 | 3,566.06 | 3,862.13 | 3,264.37
Hello | 2,879.85 | 3,012.99 | 3,095.23 | 3,479.20 | 2,948.84
Thank you | 2,898.86 | 3,014.03 | 3,090.69 | 3,471.60 | 2,946.17
I love you | 2,880.26 | 3,009.43 | 3,587.68 | 3,823.71 | 2,965.93
Yes | 2,898.62 | 3,376.16 | 3,575.92 | 3,860.96 | 3,278.20
No | 2,819.20 | 3,029.03 | 3,173.90 | 3,695.15 | 3,192.54

68

จากตารางที่ 3.4 ค่าที่ได้จาก Flex Sensor ทั้ง 5 ตัว (นิ้วโป้ง นิ้วชี้ นิ้วกลาง นิ้วนาง และ นิ้วก้อย) คือค่าจากตัวแปลงสัญญาณแอนะล็อกเป็นดิจิทัล (Analog-to-Digital Converter: ADC) ซึ่ง อ่านค่าจากความต้านทานของเซนเซอร์ โดยค่าดังกล่าวจะแปรผันตรงกับมุมการโค้งงอของนิ้วมือแต่ละ นิ้วในขณะท าท่าทาง กล่าวคือ ยิ่งนิ้วมือมีความโค้งงอมากเท่าใด ค่าความต้านทานจะยิ่งสูงขึ้น ส่งผลให้ ค่าดิจิทัลที่อ่านได้เพิ่มสูงขึ้นตามไปด้วย

2. ข้อมูลความเร่ง

ตารางที่ 3.5 รูปแบบการเก็บข้อมูลความเร่ง Accelerometer ของ MPU6050
ท่าทาง | ความเร่ง IMU
acc_x | acc_y | acc_z
A | 1.2303 | -0.4355 | 10.9341
B | 1.1046 | -0.2868 | 8.8621
C | 1.057 | -1.4877 | 13.7603
D | 0.2665 | -0.2465 | 11.2237
E | 1.4212 | -0.3912 | 9.8609
F | -0.0876 | -0.0954 | 10.7618
G | -10.7934 | -7.1609 | 11.6341
H | -10.7684 | -8.0373 | 12.6491
I | 1.4813 | -1.06 | 12.8161
J | -3.8264 | -2.0127 | 14.8443
K | 0.3276 | -0.2218 | 11.078
L | -0.0305 | -0.3798 | 12.0647
M | 0.3244 | -0.0818 | 10.9798
N | 0.7596 | -0.3363 | 12.2946
O | 0.3665 | -0.5364 | 13.1483
P | -2.9997 | -12.7015 | 19.9146
Q | -1.7469 | -11.3437 | 20.3309
R | 0.4726 | -0.3205 | 12.4138
S | 0.8325 | -0.8804 | 13.9091

69

ตารางที่ 3.5 รูปแบบการเก็บข้อมูลความเร่ง Accelerometer ของ MPU6050 (ต่อ)
ท่าทาง | ความเร่ง IMU
acc_x | acc_y | acc_z
T | 1.3326 | -0.4539 | 11.7879
U | 0.5702 | -0.1477 | 11.1951
V | 0.6512 | -0.4597 | 12.8372
W | 0.3136 | -0.0977 | 11.0892
X | -0.3209 | -0.7694 | 14.298
Y | -7.5402 | -4.3572 | 16.1846
Z | -1.5599 | -4.8767 | 18.7357
Hello | -3.6685 | -3.5782 | 16.8267
Thank you | -7.3929 | -2.7209 | 8.0399
I love you | 1.2899 | -0.6759 | 12.8822
Yes | -0.8273 | -6.7056 | 18.3804
No | 1.2835 | -1.6741 | 15.1687

จากตารางที่ 3.5 ค่า accx, accy และ accz

คือค่าความเร่งเชิงเส้นที่วัดได้จาก เซนเซอร์ MPU6050 ทั้ง 3 แกน ซึ่งบ่งบอกถึงทิศทางการจัดวางมือเมื่อเทียบกับแรงโน้มถ่วงของโลก (Gravity) ในขณะท าท่าทาง โดยทั่วไปท่าทางที่มีการพลิกข้อมือหรือการวางมือในมุมที่แตกต่างกันจะ ส่งผลให้ค่าความเร่งมีความแตกต่างกันอย่างชัดเจน เช่น ท่าทาง "G" ซึ่งมีค่า accx และ accy เป็นลบในระดับสูง แสดงถึงการพลิกข้อมือไปในทิศทางที ่แตกต ่างจากท ่าทางอื ่นอย ่างเห็นได้ชัด ในขณะที่ท่าทาง "A" และ "Yes" มีค่าความเร่งใกล้เคียงกับการวางมือในแนวปกติ

3. ข้อมูลความเร็วเชิงมุม

ตารางที่ 3.6 รูปแบบการเก็บข้อมูลความเร็วเชิงมุม Gyroscope ของ MPU6050
ท่าทาง | ความเร็วเชิงมุม IMU
gyro_x | gyro_x | gyro_x
A | -0.0003 | 0.0053 | -0.0041
B | 0.0046 | 0.0024 | -0.0071

70

ตารางที่ 3.6 รูปแบบการเก็บข้อมูลความเร็วเชิงมุม Gyroscope ของ MPU6050 (ต่อ)
ท่าทาง | ความเร็วเชิงมุม IMU
gyro_x | gyro_x | gyro_x
C | 0.0007 | 0.0032 | -0.0048
D | 0.0039 | 0.0027 | -0.006
E | 0.0042 | 0.0025 | -0.0067
F | 0.0039 | -0.0026 | -0.007
G | 0.0023 | -0.003 | -0.0091
H | 0.0038 | -0.0058 | -0.0104
I | 0.0043 | 0.0001 | -0.0078
J | -0.0936 | 0.1657 | -0.0183
K | 0.0051 | 0 | -0.0087
L | 0.0054 | -0.0003 | -0.0079
M | -0.0049 | -0.0273 | -0.0111
N | -0.0066 | -0.0296 | -0.0121
O | -0.0072 | -0.0197 | -0.0082
P | -0.006 | -0.0297 | -0.0099
Q | -0.0058 | -0.0283 | -0.0096
R | 0.0218 | -0.0161 | -0.0023
S | 0.022 | -0.0155 | -0.0002
T | 0.0212 | -0.0169 | -0.0011
U | 0.0194 | -0.0171 | -0.0004
V | 0.0208 | -0.0152 | -0.0011
W | 0.0223 | -0.0152 | -0.0013
X | 0.0223 | -0.0178 | -0.0019
Y | 0.0215 | -0.0207 | -0.003
Z | -0.1064 | 0.0154 | -0.1265
Hello | -0.0963 | -0.0275 | -0.3307
Thank you | 0.3101 | -0.0815 | -0.1568
I love you | 0.0228 | -0.0173 | -0.0016

71

ตารางที่ 3.6 รูปแบบการเก็บข้อมูลความเร็วเชิงมุม Gyroscope ของ MPU6050 (ต่อ)
ท่าทาง | ความเร็วเชิงมุม IMU
gyro_x | gyro_x | gyro_x
Yes | -0.3985 | 0.0724 | -0.0266
No | -0.0176 | -0.0121 | 0.0176

จากตารางที่ 3.6 ค่า gyrox, gyroy และ gyroz

คือค่าความเร็วเชิงมุมที่วัด ได้จากเซนเซอร์ MPU6050 ทั้ง 3 แกน ซึ่งบ่งบอกถึงอัตราการหมุนหรือการเคลื่อนไหวของข้อมือ ในขณะท าท ่าทาง ค ่าดังกล ่าวมีความส าคัญอย ่างยิ ่งส าหรับการแยกแยะท ่าทางแบบเคลื ่อนไหว (Dynamic Gestures) เช่น ท่าทาง "J" และ "Z" ที่ต้องมีการหมุนข้อมือวาดเป็นรูปตัวอักษรในอากาศ ซึ่งจะให้ค่าจากไจโรสโคป (Gyroscope) ที่สูงกว่าท่าทางแบบหยุดนิ่ง (Static Gestures) อย่างเห็นได้ ชัด

### 3.7 Flowchart การเทรนโมเดล

การท างานส่วนการเทรนโมเดลด้วย MLP (Multi-layer Perceptron) เป็นส่วนของการสร้าง โครงข่ายประสาทเทียมจากข้อมูลเซนเซอร์ที่บันทึกไว้ใน Dataset เพื่อให้โมเดลที่ได้สามารถใช้ในการ จ าแนกท่าทางภาษามือ โดยมีการน าค่าจาก Flex Sensor และ MPU6050 ที่จัดเก็บในรูปแบบ JSON มาผ่านกระบวนการ Standardization ด้วย StandardScaler จากนั้นจึงท าการฝึกสอนโมเดลด้วย อัลกอริทึม Backpropagation จนกระทั่งได้ไฟล์โมเดลที่ผ่านการฝึกสอนแล้วและไฟล์ Scaler ซึ่งจะ ถูกน าไปใช้ในขั้นตอนการประมวลผล ต่อไป ทั้งนี้ระบบยังท าการประเมินค่าความถูกต้อง (Accuracy) และพล็อตกราฟ (Plot Graph) ซึ ่งเป็นการท า Data Visualization เพื ่อให้สามารถทดสอบ เปรียบเทียบ และประเมินค่าความถูกต้องของโมเดลที่สร้างขึ้นว่ามีแนวโน้มที่ดีหรือไม่

72

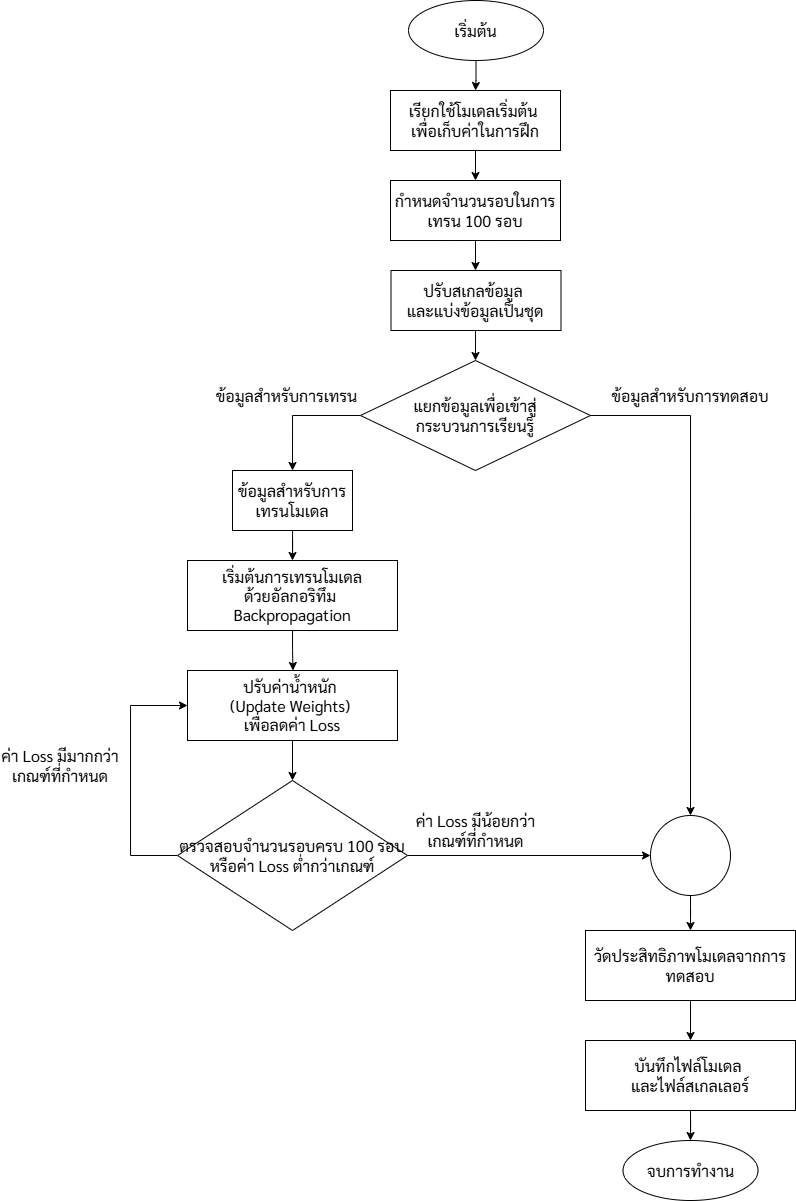
[picture p43: figure]

รูปที่ 3.14 Flowchart การเทรนโมเดล

จากรูปที ่ 3.4 สามารถอธิบายล าดับขั้นตอนการประมวลผลและการเรียนรู้ของแบบจ าลอง โครงข่ายประสาทเทียม (Neural Network) ตั้งแต่เริ่มต้นกระบวนการเตรียมข้อมูลไปจนถึงการบันทึก ผลเพื่อน าไปใช้งานจริง โดยมีรายละเอียดดังนี้

73

### 3.8 การออกแบบโมเดล

จากแนวทางที ่วิเคราะห์ระบบเดิมไว้เก็บข้อมูลท ่าทางแบบล าดับเวลาและจ าแนกด้วย ปัญญาประดิษฐ์ผู้จัดท าจึงออกแบบแบบจ าลองโครงข ่ายประสาทเทียมชนิด Multi-Layer Perceptron (MLP) ขึ้น เนื่องจากข้อมูลน าเข้าเป็นข้อมูลเชิงตัวเลขจากเซนเซอร์ที่แปลงเป็นเวกเตอร์ คุณลักษณะแล้ว ไม ่ใช ่ข้อมูลภาพ จึงไม ่จ าเป็นต้องใช้โครงข ่ายประสาทเทียมแบบคอนโวลูชันซึ่ง ต้องการทรัพยากรฝึกสอนสูงกว่า การออกแบบแบ่งออกเป็นส่วนต่าง ๆ ที่เชื่อมโยงกัน ดังนี้
1. Input Layer เพื่อรองรับข้อมูลล าดับเวลาที่เก็บไว้มีขนาด 660 มิติซึ่งได้จากเซนเซอร์ 11 พารามิเตอร์ต ่อเฟรม คูณด้วยความยาวล าดับเวลา 60 เฟรม ท าให้แบบจ าลองรับรู้ลักษณะการ เคลื่อนไหวของท่าทางได้ครบถ้วน
2. Hidden Layer เพื่อให้ประมวลผลได้รวดเร็ว Hidden Layer ออกแบบเป็น 2 ชั้น ขนาด 256 และ 128 นิวรอนตามล าดับ ลดลงแบบ Funnel เพื่อให้โครงข่ายเรียนรู้คุณลักษณะเชิงลึกในชั้นแรก แล้วค ่อยสรุปคุณลักษณะให้กระชับก ่อนส ่งต ่อไปยังชั้นถัดไป ขนาดดังกล ่าวได้จากการทดลอง เปรียบเทียบหลายขนาด โดยพิจารณาความแม่นย าและเวลาฝึกสอนที่เหมาะสมร่วมกัน และใช้ฟังก์ชัน กระตุ้น ReLU เพื่อลดปัญหา Vanishing Gradient และค านวณได้เร็วกว่า Sigmoid หรือ Tanh
3. Output Layer เพื่อจ าแนกท่าทางและแสดงผลแบบเรียลไทม์ Output Layer มี 31 หน่วย ตรงกับจ านวนคลาสท่าทางทั้งหมด คือตัวอักษร A ถึง Z จ านวน 26 ท่า และค าศัพท์พื้นฐาน 5 ค า ได้แก่ Hello, Thank you, I love you, Yes และ No โดยใช้ฟังก์ชัน Softmax แปลงค่าดิบจาก นิวรอนทั้ง 31 ตัวให้เป็นค่าความน่าจะเป็นที่ผลรวมเท่ากับ 1 แล้วเลือกคลาสที่มีค่าความน่าจะเป็น สูงสุดเป็นค าตอบ
4. ออกแบบตัวปรับค่าน ้าหนัก (Solver) เพื่อให้แบบจ าลองฝึกสอนได้เร็วและแม่นย าสอดคล้อง กับเป้าหมายของระบบทั้งหมด เลือกใช้อัลกอริทึม Adam ซึ่งปรับอัตราการเรียนรู้ของแต่ละน ้าหนัก โดยอัตโนมัติจากค ่าโมเมนต์ของเกรเดียนต์ ท าให้ค ่าน ้าหนักลู ่เข้าจุดที ่เหมาะสมได้เร็วกว ่าวิธี Stochastic Gradient Descent แบบดั้งเดิม และลดค่าความสูญเสียด้วย Cross-Entropy Loss ใน ทุกรอบของการฝึกสอนดังรูปที่ 3.15

รูปที่ 3.15 โครงสร้างโมเดล

74

### 3.8.1 อธิบายโค้ดการเทรนโมเดล

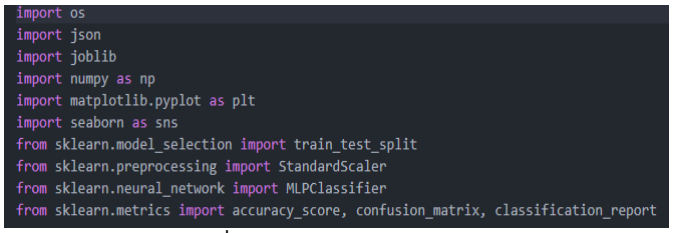
[picture p44: figure]

รูปที่ 3.16 โค้ดส าหรับน าเข้าไลบรารี

จากรูปที่ 3.16 ประกอบด้วยค าสั่งที่ใช้ส าหรับการน าเข้าไลบรารีโดยมีรายละเอียดดังมีการ น าเข้าไลบรารี
- import os น าเข้าโมดูลส าหรับจัดการระบบไฟล์และโฟลเดอร์ของระบบปฏิบัติการ
- import joblib น าเข้าไลบรารีส าหรับเซฟ และโหลด วัตถุในภาษา Python เช่น ตัว แบบที่ฝึกสอนเสร็จแล้ว หรือตัวปรับระดับข้อมูล
- import numpy as np น าเข้าคลังค านวณคณิตศาสตร์อาเรย์หลายมิติยอดนิยม โดยตั้งชื่อย่อว่า np
- import matplotlib.pyplot as plt น าเข้าเครื่องมือส าหรับวาดกราฟและแผนภูมิ ตั้งชื่อย่อว่า plt
- from sklearn.model_selection น าเข้าฟังก์ชัน train_test_split เพื่อใช้สุ่มแบ่ง ข้อมูลออกเป็นชุดสอน (Train) และชุดทดสอบ (Test)
- from sklearn.preprocessing น าเข้า StandardScaler ส าหรับปรับค่าตัวเลขของ ข้อมูลจากเซนเซอร์ทุกตัวให้อยู่ในช่วงมาตรฐานเดียวกัน
- from sklearn.neural_network น าเข้าโมดูลโครงข่ายประสาทเทียมแบบหลาย ชั้น MLPClassifier (Multilayer Perceptron)
- from sklearn.metrics น าเข้าตัววัดผลต ่าง ๆ ได้แก ่ ค ่าความแม ่นย ารวม (accuracy_score), เมทริกซ์ความสับสน (confusion_matrix), และรายงานประสิทธิภาพจ าแนก คลาสอย่างละเอียด (classification_report)

75

รูปที่ 3.17 โค้ดการก าหนดข้อมูลน าเข้า

จากรูปที่ 3.17 เป็นการก าหนดที่อยู่ของข้อมูลที่น าเข้ามา
- DATASET_FILE = 'dynamic_data_60fnew.json' ก าหนดชื ่อไฟล์ชุดข้อมูลที่ บันทึกมาจากถุงมือ
- MODEL_FILE = 'smart_glove_model_dynamic2.pkl' ก าหนดชื่อไฟล์ส าหรับ จัดเก็บโมเดลปัญญาประดิษฐ์ที่เทรนเสร็จแล้ว
- SCALER_FILE = 'scaler_dynamic2.pkl' ก าหนดชื่อไฟล์ส าหรับจัดเก็บตัวปรับ มาตรฐานข้อมูล (StandardScaler) เพื่อน าไปใช้งานร่วมกับโมเดลในตอนท านายจริง

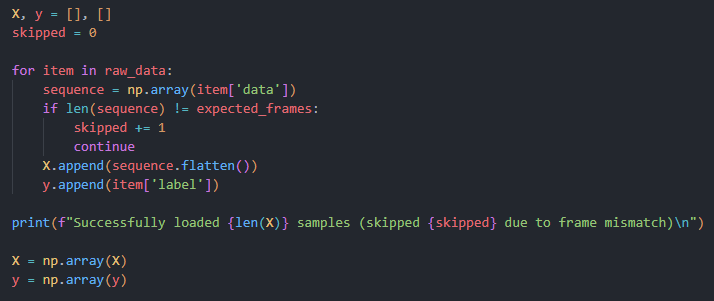
[picture p45: figure]

รูปที่ 3.18 โค้ดจัดรูปแบบข้อมูลให้พร้อมส าหรับการเทรน

จากรูปที่ 3.18 เป็นการจัดรูปแบบข้อมูลให้พร้อมส าหรับการเทรน
- X, y = [ ], [ ] ก าหนดตัวแปร X (เก็บข้อมูลเซนเซอร์น าเข้า) และ y (เก็บป้ายก ากับ เฉลย) เป็นอาเรย์ว่าง
- for item in raw_data
sequence = np.array(item['data'])
เป็นการวนลูปอ่านข้อมูลทีละท่าทางใน raw_data และแปลงส่วนข้อมูลพารามิเตอร์ ให้เป็น NumPy Array

76

- if len(sequence) != expected_frames:
skipped += 1
continue
เป็นการตรวจสอบว่าข้อมูลท่าทางนี้มีเฟรมครบ 60 เฟรมหรือไม่ หากไม่ครบ ให้เพิ่ม จ านวนตัวเก็บสถิติข้าม skipped ขึ้นทีละหนึ่ง และข้ามไปอ่านตัวอย่างถัดไปทันที
- X.append(sequence.flatten()) ใช้ฟังก์ชัน flatten() บีบอัดมิติข้อมูลจากตาราง (60 แถว, 11 คอลัมน์) ให้เหลือแนวราบเส้นเดียว 660 ตัวเลข แล้วเก็บเข้าชุดข้อมูล X
- y.append(item['label']) เก็บชื่อเฉลยของท่าทางนั้น (Label) เข้าชุดข้อมูล
ค าตอบ y
- X = np.array(X)
y = np.array(y)
แปลงตัวแปร X และ y ให้กลายเป็นโครงสร้างอาเรย์ของ NumPy เพื่อส่งเข้า ประมวลผล

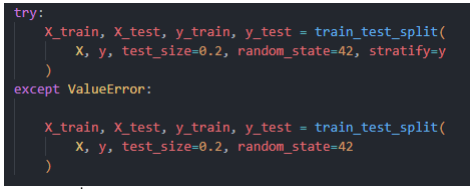
[picture p46: figure]

รูปที่ 3.19 โค้ดการแบ่งข้อมูลเป็น Train และ Test

จากรูปที่ 3.19 เป็นการแบ่งข้อมูลเป็น Train และ Test
- try:
X_train, X_test, y_train, y_test = train_test_split(
X, y, test_size=0.2, random_state=42, stratify=y
)
เป็นการ สุ่มแบ่งข้อมูลเซนเซอร์ (X) และค าตอบ (y) ในสัดส่วน 80% ส าหรับสอน และ 20% ส าหรับใช้สอบ โดยล็อกความสุ่มด้วย random_state=42 และรักษาอัตราส่วนความถี่ของแต่ ละคลาสในข้อมูลทั้งสองกลุ่มให้เท่ากันด้วยค าสั่ง stratify=y

77

- except ValueError:
X_train, X_test, y_train, y_test = train_test_split( X, y, test_size=0.2, random_state=42
)
หากข้อมูลแต่ละท่าทางมีจ านวนตัวอย่างน้อยเกินไป หรือเกิดปัญหาจ านวนคลาสไม่สมดุล (Class Imbalance) ฟังก์ชันจะเกิด Error ขึ้น ระบบจะกู้คืนการรันโดยเปลี่ยนไปใช้วิธีแบ่งสุ่มแบบ ปกติที่ไม่มีการรักษาสัดส่วน (stratify) แทน

รูปที่ 3.20 โค้ดส าหรับการปรับสเกล

จากรูปที่ 3.20 เป็นโค้ดส าหรับการปรับสเกล เพื่อให้ข้อมูลอยุ่ในมาตราฐานเดียวกัน
- scaler = StandardScaler() ประกาศใช้โมดูลปรับมาตรฐานข้อมูลด้วยคะแนน มาตรฐาน Z-score
- X_train_scaled = scaler.fit_transform(X_train) ค านวณหาค่าเฉลี่ย (μ) และ ส่วนเบี่ยงเบนมาตรฐาน (σ) จากข้อมูลสอน X_train แล้วด าเนินการปรับระดับตัวเลขของชุดข้อมูล ฝึกสอนนั้นให้อยู่ในช่วงมาตรฐานเดียวกันทันที
- X_test_scaled = scaler.transform(X_test) ปรับระดับตัวเลขของชุดข้อมูล ทดสอบ X_test โดยใช้ค่า μ และ σ เดียวกันกับที่ค านวณได้จากข้อมูลสอน

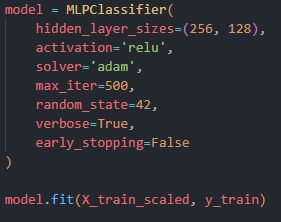
[picture p47: figure]

รูปที่ 3.21 โค้ดส าหรับการสร้างโมเดล

78

จากรูปที่ 3.21 เป็นโค้ดส าหรับการสร้างโมเดลเพื่อน าไปใช้ในการเทรนโมเดล
- hidden_layer_sizes=(256, 128) ก าหนดให้มีชั้นซ่อน (Hidden Layer) 2 ชั้น ชั้น แรกมี 256 นิวรอน ชั้นที่สองมี 128 นิวรอน
- activation='relu' ใช้ฟังก์ชันเรลูประมวลผลเพิ่มมิติที่ไม่เป็นเส้นตรงในชั้นซ่อน
- solver='adam' ใช้อัลกอริทึม Adam ช่วยปรับค่าน ้าหนักให้ลู่เข้าจุดที่ดีที่สุดอย่าง รวดเร็ว
- max_iter=500 ก าหนดขอบเขตสูงสุดการเทรนไว้ที่ 500 รอบการรัน
- random_state=42 ล็อกความสุ ่มเริ ่มต้นของน ้าหนักเพื ่อให้ฝึกสอนกี ่ครั้งก็ได้ ผลลัพธ์เหมือนเดิม
- verbose=True: สั่งให้โปรแกรมพิมพ์ค่าความสูญเสีย (Loss Value) ในแต่ละรอบ การรันออกมาแสดงผลบนหน้าจอ
- early_stopping=False สั ่งไม ่ให้แบบจ าลองหยุดฝึกสอนกลางคันจนกว ่าจะถึง เกณฑ์ความต่างที่เหลือน้อยมากหรือรันครบ 500 รอบ
- model.fit(X_train_scaled, y_train) สั ่งเริ ่มกระบวนการค านวณฝึกสอนหา ความสัมพันธ์ระหว่างระดับสัญญาณเซนเซอร์ที่ปรับค่าแล้ว (X_train_scaled) กับชื่อท่าทางภาษามือ จริง (y_train)

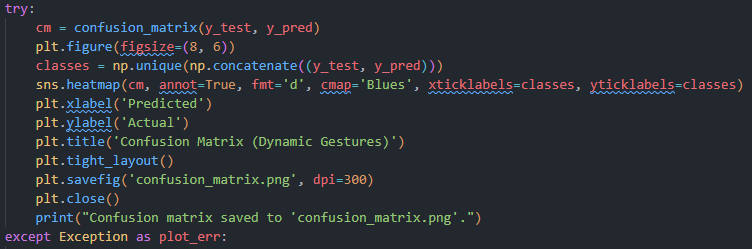
[picture p48: figure]

รูปที่ 3.22 เป็นโค้ดสร้างแผนภาพ Confusion Matrix

จากรูปที่ 3.22 เป็นโค้ดส าหรับสร้าง แผนภาพ Confusion Matix เพื่อดูว่าท่าทางไหนมี ข้อผิดพลาดบ้าง
- cm = confusion_matrix(y_test, y_pred) ค านวณค่าจ านวนครั้งที่ท านายได้ถูก คลาสและทายสลับสับสนคลาสของชุดทดสอบ
- plt.figure(figsize=(8, 6)) สร้างพื้นที่รูปภาพวาดกราฟขนาดสัดส่วน 8x6 นิ้ว

79

- classes = np.unique(np.concatenate((y_test, y_pred))) รวมชื่อคลาสเฉพาะ ทั้งหมดที่มีอยู่ในเฉลยเพื่อน ามาใช้เป็นป้ายระบุข้างแกนกราฟ
- s n s . h e a t m a p ( c m , a n n o t = Tr u e , f m t = ' d ' , c m a p = ' B l u e s ' , xticklabels=classes, yticklabels=classes) วาดแผนภูมิความร้อน (Heatmap) โดยใช้จ านวนครั้ง การทายสลับ ตัวเลขระบุชัดเจนด้วยสีกราเดียนต์โทนฟ้า
- plt.xlabel('Predicted')
plt.ylabel('Actual')
plt.title('Confusion Matrix (Dynamic Gestures)')
ระบุค าบรรยายในแกนท านาย (Predicted) แกนจริง (Actual) และก าหนดหัวชื่อเรื่อง ของแผนภาพ
- plt.savefig('confusion_matrix.png', dpi=300) เซฟรูปแผนภาพที่วาดเสร็จแล้ว ออกเป็นไฟล์รูปภาพ confusion_matrix.png ด้วยความคมชัดสูง 300 DPI
- plt.close() ปิดกราฟของ Matplotlib เพื่อคืนหน่วยความจ าเครื่องคอมพิวเตอร์ และแสดงผลว่าการเซฟภาพลุล่วง
- except Exception as plot_err: ตรวจจับข้อผิดพลาดกรณีไม่สามารถเซฟรูปภาพ ได้ (เช่น ไม่มีสิทธิ์เขียนไฟล์) ให้แจ้งเตือนและปล่อยโปรแกรมท างานต่อไปโดยไม่ท าให้ระบบล่ม หลังจาก Run โค้ดส่วนนี้แล้ว จะได้กราฟที่แสดงการประเมินความถูกต้องที่โมเดลทาย ดังรูปที่ 3.23

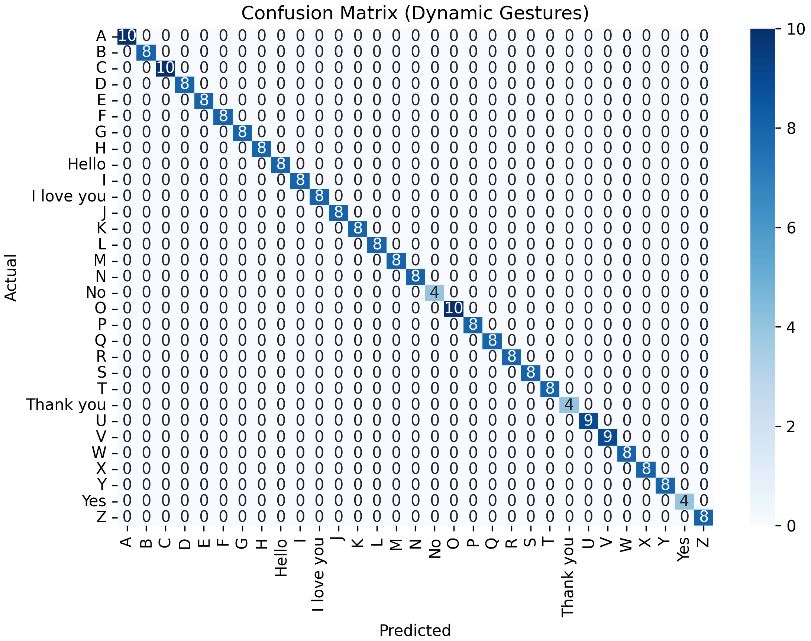
[picture p49: figure]

รูปที่ 3.23 กราฟประเมิน (Confusion Matrix)

80

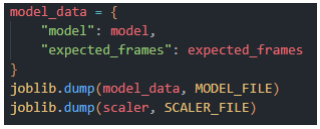
[picture p50: figure]

รูปที่ 3.24 โค้ดส าหรับการบันทึกโมเดล

จากรูปที่ 3.24 เป็นโค้ดส าหรับการบันทึกโมเดลเพื่อน ามาใช้งานในการเป็นสมองของตัว ประมวลผล
- model_data = {
"model": model,
"expected_frames": expected_frames }
รวมโครงข ่าย MLP (model) ที ่ผ ่านการสอนแล้วและข้อมูลจ านวนเฟรมที ่คาดหวัง (expected_frames) เข้าด้วยกันในรูปแบบโครงสร้างดิกชันนารี (Dictionary)
- joblib.dump(model_data, MODEL_FILE) เซฟวัตถุโมเดลทั้งหมดลงใน ไฟล์smart_glove_model_dynamic2.pkl
- joblib.dump(scaler, SCALER_FILE) เซฟวัตถุตัวปรับมาตรฐานข้อมูลลงใน ไฟล์scaler_dynamic2.pkl
หลังจากท าการรันโค้ดเรียบร้อยแล้วจะได้ไฟล์ออกมา ดังรูปที่ 3.25

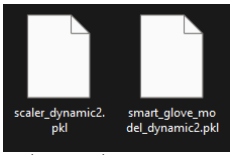
[picture p51: figure]

รูปที่ 3.25 ไฟล์ที่ได้จากการเทรน

1. smart_glove_model_dynamic2.pkl เป็นไฟล์โมเดลที่ผ่านการเทรนมาเรียบร้อย แล้ว

81

2. scaler_dynamic2.pkl เป็นไฟล์scale ที่เอาไว้ปรับสเกลของข้อมูลที ่ส่งมาผ ่าน ESP32

### 3.9 การพัฒนา Web Application

เว็บแอปพลิเคชันภายในระบบนี้ท าหน้าที่เป็นตัวกลางเชื่อมโยงระหว่างโมเดลปัญญาประดิษฐ์กับ ผู้ใช้งาน โดยจะรับผลลัพธ์จากการจ าแนกท่าทางที่ประมวลผลโดยโมเดล MLP มาแสดงเป็นข้อความ บนหน้าจอ การท างานในส่วนนี้ช่วยให้บุคคลทั่วไปที่ไม่มีความรู้ด้านภาษามือสามารถเข้าใจความหมาย ของท่าทางที่ผู้พิการทางการได้ยินสื่อสารออกมาได้อย่างถูกต้อง

### 3.9.1 เทคโนโลยีที่ใช้ในการพัฒนา

เว็บแอปพลิเคชัน (Web Application) ในโครงงานนี้พัฒนาด้วยชุดเทคโนโลยีที่ท างาน ร่วมกัน ดังนี้
1. Flask เป็น Python Micro-framework ที่ท าหน้าที่เป็น Backend Server ส าหรับ รับค าสั่งจาก Frontend ก าหนดเส้นทาง (Route) และเชื่อมต่อกับโมเดล MLP
2. HTML ใช้ส าหรับก าหนดโครงสร้างและเนื้อหาของหน้าเว็บ
3. CSS ใช้ส าหรับควบคุมรูปแบบการแสดงผล
4. JavaScript ใช้เพิ่มความสามารถในการโต้ตอบฝั่ง Frontend

### 3.9.2 อธิบายโค้ดส่วนการแสดงผล

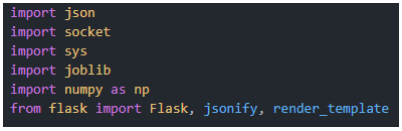
[picture p52: figure]

รูปที่ 3.26 โค้ดส าหรับน าเข้าไลบรารี

จาก รูปที่ 3.26 เป็นการน าเข้าไลบรารี และโมดูลที่ใช้ส าหรับการสร้าง Webapplication
- import json น าเข้าโมดูลจัดการข้อมูลประเภท JSON
- import socket น าเข้าโมดูลส าหรับการรับส่งข้อมูลบนระบบเครือข่ายอินเทอร์เน็ต
- import sys น าเข้าโมดูลจัดการระบบการท างานของภาษา Python

82

- import joblib น าเข้าโมดูลส าหรับโหลดไฟล์ตัวแบบจ าลอง (Model) และตัวปรับ ระดับสเกลข้อมูล (Scaler)
- import numpy as np น าเข้าคลังจัดการอาเรย์คณิตศาสตร์เพื่อจัดระเบียบเฟรม ข้อมูลน าไปท านายผล
- from flask import Flask, jsonify, render_template น าเข้าคลาสหลักของเว็บ เฟรมเวิร์ก Flask รวมถึงฟังก์ชันส าหรับแปลงรูปแบบผลท านายเป็น JSON (jsonify) และค าสั่งส าหรับ ส่งหน้าเว็บ HTML ไปแสดงผลบนเบราว์เซอร์

รูปที่ 3.27 โค้ดส าหรับก าหนดตัวแปร

จากรูปที่ 3.27 เป็นโค้ดส าหรับก าหนดตัวแปรที่ใช้ในโค้ด
- MODEL_FILE = 'smart_glove_model_dynamic2.pkl'
SCALER_FILE = 'scaler_dynamic2.pkl'
ก าหนดชื่อไฟล์โมเดลปัญญาประดิษฐ์และไฟล์ปรับสเกลข้อมูลที่จะถูกโหลดขึ้นมาใช้ งาน
- UDP_IP = "0.0.0.0" ก าหนดไอพีการรับข้อมูลเป็น "0.0.0.0"
- UDP_PORT = 4210 ก าหนดเปิดพอร์ตการรับแพ็กเก็ตข้อมูลจากถุงมือไว้ที่ หมายเลขพอร์ต 4210

รูปที่ 3.28 โค้ดส าหรับการโหลดโมเดล

จากรูปที่ 3.28 เป็นโค้ดส าหรับการโหลดโมเดลที่เทรนไว้ก่อนหน้านี้มาใช้
- try:

83

model_data = joblib.load(MODEL_FILE)
model = model_data["model"]
expected_frames = model_data["expected_frames"] scaler = joblib.load(SCALER_FILE) โหลดไฟล์โมเดลปัญญาประดิษฐ์ (smart_glove_model_dynamic2.pkl) มาแกะแยก คลาสแบบจ าลอง (model) และข้อมูลความยาวเฟรมสะสมที่คาดหวัง (expected_frames ) พร้อม โหลดตัวปรับสเกล (SCALER_FILE) ข้อมูลเข้ามาเก็บในหน่วยความจ า

รูปที่ 3.29 โค้ดส าหรับก าหนดรูปแบบของ Template

จากรูปที ่ 3.29 เป็นโค้ดส าหรับการก าหนดรูปแบบของ Template ที ่อยู ่ใน ไฟล์ index.html
- @app.route('/')
def index():
ก าหนดเส้นทางหลักของเว็บไซต์
- return render_template('index.html') ส่งไฟล์รูปแบบเว็บเพจ (index.html) ที่ จัดเก็บในโฟลเดอร์ templates ออกไปแสดงผลบนหน้าจอผู้เข้าใช้

รูปที่ 3.30 โค้ดส าหรับสร้างช่องทางรับข้อมูลจาก ESP32

จากรูปที่ 3.30 เป็นโค้ดส าหรับการสร้างช่องทางรับข้อมูลที่มาจาก ESP32
- def predict_once(): ก าหนดสร้างจุดเชื่อมต่อ API
- sock = socket.socket(socket.AF_INET, socket.SOCK_DGRAM) ประกาศสร้าง พอร์ตเชื่อมต่อเน็ตเวิร์ก (Socket) โดยก าหนดใช้โปรโตคอล IPv4 และใช้ช่องทางการส่งข้อมูลแบบไม่ ยืนยันผลเชื่อมต่อหรือ

84

- sock.bind((UDP_IP, UDP_PORT)) สั่งผูกพอร์ตเชื่อมต่อเข้ากับไอพีและพอร์ต 4210
- sock.settimeout(5.0) ก าหนดระยะเวลาหน่วงรอคอยข้อมูลสูงสุด (Timeout) ไว้ที่ 5.0 วินาที หากไม่มีการส่งแพ็กเก็ตใด ๆ จากถุงมือเข้ามาภายในเวลานี้ ให้ระบบยกเลิกการรอคอย

รูปที่ 3.31 โค้ดส าหรับรับและแปลงข้อมูล

จากรูปที่ 3.31 เป็นโค้ดส าหรับรับข้อมูลและปรับข้อมูลให้เหมาะส าหรับเข้าโมเดล
- while len(buffer_frames) < expected_frames: วนลูปอ่านข้อมูลทางพอร์ต ต่อเนื่อง จนกว่าจะครบ 60 เฟรม
- data, _ = sock.recvfrom(2048) ก าหนดความยาวของข้อมูลไม่เกิน 2048 ไบต์
- raw_data = json.loads(data.decode('utf-8')) แปลงข้อความแพ็กเก็ตข้อมูลจาก utf-8 ให้เป็นโครงสร้างข้อมูลประเภทดิกชันนารี
- frame_vector = raw_data['flex'] + raw_data['acc'] + raw_data['gyro'] น า ตัวเลขแถว สลิสต์ข้อมูลเซนเซอร์นิ้วมือ 5 นิ้ว (flex), สัญญาณความเร่ง 3 ทิศทาง (acc) และสัญญาณ การหมุนข้อมือ 3 ทิศทาง (gyro) มารวมเชื่อมเรียงต่อกันเป็นเวกเตอร์เฟรมข้อมูลมิติเดี่ยว
- buffer_frames.append(frame_vector) น าข้อมูล 11 ตัวเลขที่ได้ไปต่อท้ายเก็บ สะสมในอาเรย์หลัก buffer_frames

รูปที่ 3.32 โค้ดส าหรับการท านายผลลัพธ์

จากรูปที่ 3.32 เป็นโค้ดส าหรับการท านายผลโดยใช้โมเดลที่เทรนมา
- X_realtime = np.array(buffer_frames).reshape(1, -1) น าอาเรย์ข้อมูล 60 เฟรม (ขนาด 60×11) มาแปลงเป็น NumPy Array และใช้ค าสั่ง .reshape(1, -1) บีบรูปมิติแนวแบน ราบให้เหลือมิติขนาด 1 แถว ยาว 660 คอลัมน์ ส าหรับให้โมเดลประมวลผล

85

- X_realtime_scaled = scaler.transform(X_realtime) น าเวกเตอร์ขนาด 660 มิตินี้ไปค านวณปรับสเกลมาตรฐานตัวเลขโดยตัวแปรปรับแต่ง scaler
- prediction = model.predict(X_realtime_scaled) [0] ป้อนข้อมูลเข้าตัวแบบ ปัญญาประดิษฐ์เพื่อท านายผลลัพธ์ และดึงค าตอบล าดับที่ศูนย์ออกมาเก็บในตัวแปร prediction

### 3.10 สรุปท้ายบทที่ 3

ในบทนี้ได้น าเสนอรายละเอียดการวิเคราะห์และออกแบบระบบถุงมือแปลภาษามืออัจฉริยะใน ทุกส่วนอย่างครบถ้วน เริ่มตั้งแต่การจัดท าแผนผังการต่อวงจรและต าแหน่งการก าหนดขาสัญญาณของ ไมโครคอนโทรลเลอร์ ESP32 ร่วมกับเซนเซอร์ตรวจจับการโค้งงอของนิ้วมือ (Flex Sensors) ทั้ง 5 นิ้ว และเซนเซอร์ตรวจจับความเคลื่อนไหวข้อมือ MPU6050 ตลอดจนสถาปัตยกรรมทางโครงสร้าง เครือข่ายและแบบจ าลองโครงข่ายประสาทเทียมแบบหลายชั้น (MLP) ที่ใช้คุณลักษณะน าเข้า 11 ตัว แปรเก็บรวมเป็นอนุกรมเวลาจ านวน 60 เฟรม (รวม 660 มิติ) ส ่งผ ่านทางเครือข ่ายไร้สายด้วย โปรโตคอล UDP พอร์ต 4210 เพื่อไปจัดเก็บในรูปแบบโครงสร้าง JSON และเชื่อมต่อไปยังหลังบ้าน ของระบบแสดงผลบนหน้าเว็บเบราว์เซอร์ ซึ ่งทั้งหมดนี้ได้กลายเป็นรากฐานและโครงสร้างการ ด าเนินงานส าหรับการน าไปฝึกสอนโมเดลและการทดสอบในบทถัดไป

บทที่4
ผลการด าเนินการ

### 4.1 ผลการด าเนินงาน

การด าเนินงานในระบบถุงมือแปลภาษามือ (ข้างเดียว) ได้รับการออกแบบและพัฒนาให้ ครอบคลุมทั้งส่วนของฮาร์ดแวร์ ซอฟต์แวร์และกระบวนการประมวลผลข้อมูลแบบครบวงจร โดย ระบบถูกพัฒนาให้สอดคล้องกับขอบเขตที่ก าหนดไว้ทั้ง 6 ข้อ ได้แก่ การใช้บอร์ดไมโครคอนโทรลเลอร์ ESP32 เป็นตัวส่งข้อมูล การติดตั้ง Flex Sensor จ านวน 5 ชิ้นเพื่อวัดค่าการงอของนิ้วมือทั้ง 5 นิ้ว การใช้เซนเซอร์ MPU6050 วัดระนาบและการเคลื่อนไหวของข้อมือ การพัฒนาเว็บแอปพลิเคชันด้วย Flask ส าหรับแสดงผลพร้อมปุ่มควบคุมการแปล การรองรับท่าทางมือเดียวครอบคลุมตัวอักษร A–Z และค าศัพท์ Hello, Thank you, I love you, Yes และ No รวม 31 ท่าทาง รวมถึงการท านายผล ท ่าทางภาษามือจากค ่า Flex Sensor และ MPU6050 ได้จริง องค์ประกอบหลักของระบบแบ่ง ออกเป็น 3 ส่วน ดังนี้

### 4.1.1 การเทรนโมเดลและจัดเตรียมโมเดลปัญญาประดิษฐ์

กระบวนการฝึกสอนโมเดลปัญญาประดิษฐ์ด าเนินการโดยใช้โครงข่ายประสาทเทียมแบบ Multi-layer Perceptron Classifier (MLP Classifier) ผ่านไลบรารี Scikit-learn บนภาษา Python ข้อมูลที่ใช้ในการฝึกสอนได้มาจากการเก็บสัญญาณเซนเซอร์ผ่านถุงมือต้นแบบ โดยประกอบด้วยข้อมูล จาก Flex Sensor จ านวน 5 ตัว และ MPU6050 จ านวน 1 ตัว ซึ่งวัดค่าระนาบและการเคลื่อนไหว ของข้อมือ การเก็บข้อมูลแต ่ละท ่าทางด าเนินการในรูปแบบ 60 เฟรมต ่อตัวอย ่าง ส ่งผ ่านระบบ เครือข่ายไร้สายด้วยโปรโตคอล UDP เพื่อให้ได้ข้อมูลที่มีความหน่วงเวลาต ่า (Low Latency) โมเดลที่ ผ ่านการฝึกสอนแล้วจะถูกบันทึกในรูปแบบไฟล์ .pkl เพื ่อน าไปใช้งานจริงในกระบวนการจ าแนก ท่าทางในขั้นตอนถัดไป

### 4.1.2 กระบวนการประมวลผลข้อมูลแบบช่วงเวลา

ในขั้นตอนการใช้งานจริง ผู้ใช้งานจะสวมถุงมือและจัดท ่าทางภาษามือที ่ต้องการแปล ความหมาย จากนั้นกดปุ่มแปลบนเว็บแอปพลิเคชัน เพื่อเริ่มต้นกระบวนการเก็บข้อมูล ระบบจะท าการรับ สัญญาณจากเซนเซอร์ผ่านไมโครคอนโทรลเลอร์ ESP32 และส่งข้อมูลในรูปแบบ JSON ผ่านโปรโตคอล UDP มายังคอมพิวเตอร์ฝั่งผู้รับอย่างต่อเนื่อง จนกว่าจะครบ 60 เฟรมตามที่ก าหนด หากจ านวนเฟรมที่

87

เก็บได้ยังไม่ครบตามเงื่อนไข ระบบจะด าเนินการเก็บข้อมูลต่อเนื่องจนครบจ านวนที่ก าหนด เมื่อได้รับ ข้อมูลครบ 60 เฟรมแล้ว ข้อมูลดังกล่าวจะถูกส่งเข้าสู่โมเดล MLP Classifier เพื่อท าการจ าแนกท่าทาง โดยระบบรองรับการจ าแนกท่าทางภาษามืออเมริกัน (American Sign Language) ครอบคลุมตัวอักษร A ถึง Z รวมถึงค าศัพท์ที่ใช้บ่อย ได้แก่ Hello, Thank you, I love you, Yes และ No

### 4.1.3 การแสดงผลลัพธ์ผ่านเว็บแอปพลิเคชัน

ผลลัพธ์จากการจ าแนกท ่าทางจะถูกส ่งต ่อไปยังเว็บแอปพลิเคชันที ่พัฒนาด้วย Flask Framework ซึ่งท าหน้าที่เป็นตัวกลางในการเชื่อมโยงระหว่างโมเดลปัญญาประดิษฐ์และผู้ใช้งาน โดย เว็บแอปพลิเคชันจะแสดงผลการแปลท่าทางภาษามือออกมาในรูปแบบข้อความบนหน้าจอ ซึ่งผู้ใช้งาน สามารถอ่านและท าความเข้าใจได้ทันที ระบบการแสดงผลดังกล่าวช่วยลดอุปสรรคด้านการสื่อสาร ระหว่างผู้พิการทางการได้ยินกับบุคคลทั่วไป และเปิดโอกาสให้ผู้ที่ไม่มีความรู้ด้านภาษามือสามารถ เข้าใจความหมายของท่าทางที่แสดงได้อย่างสะดวกและรวดเร็ว

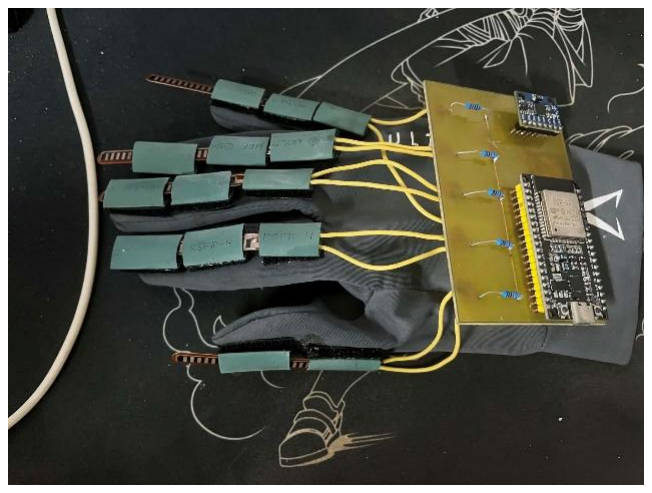
[picture p53: figure]

รูปที่ 4.1 ถุงมือต้นแบบที่พัฒนาขึ้น

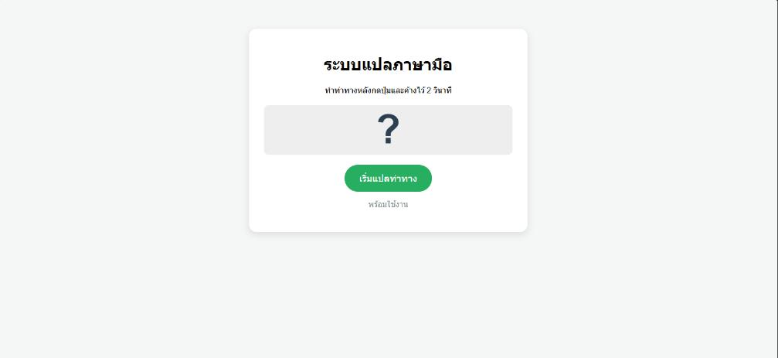
[picture p54: figure]

รูปที่ 4.2 หน้าต่าง Web Application

88

### 4.2 ผลการประเมินประสิทธิภาพของโมเดลปัญญาประดิษฐ์

ในการประเมินประสิทธิภาพการใช้งานจริงของระบบถุงมือแปลภาษามือแบบข้างเดียว ทางเราได้ ท าการทดสอบจ าแนกท่าทางภาษามือทั้งตัวอักษรและค าศัพท์ตามขอบเขตที่ก าหนดไว้ทั้งหมด 31 ท่าทาง ผ่านเว็บแอปพลิเคชัน จ านวนทั้งสิ้น 30 ครั้งต่อท่าทาง เพื่อวัดความเสถียรและการตอบสนอง ของโมเดลโครงข่ายประสาทเทียมต่อการสั่งการจริงของผู้ใช้งาน โดยข้อมูลที่ใช้ทดสอบผ่านการอ่านค่า จาก Flex Sensor (5 นิ้ว) และ MPU6050 (Accelerometer & Gyroscope) ผ่านบอร์ด ESP32 ส่ง มาทาง UDP พอร์ต 4210 ครบ 60 เฟรมต่อครั้ง และผ่านการท านายด้วยโมเดล MLP Classifier ผล การทดสอบและการวิเคราะห์ความถูกต้องปรากฏดังด้านล่าง

ตารางที่ 4.1 ผลการทดสอบการแปลตัวอักษร A
ครั้งที่ | ผลลัพธ์ | ครั้งที่ | ผลลัพธ์ | ครั้งที่ | ผลลัพธ์
1 | A | 11 | A | 21 | A
2 | C | 12 | A | 22 | A
3 | A | 13 | A | 23 | A
4 | A | 14 | A | 24 | A
5 | A | 15 | A | 25 | A
6 | A | 16 | A | 26 | A
7 | A | 17 | A | 27 | A
8 | A | 18 | A | 28 | A
9 | A | 19 | A | 29 | A
10 | A | 20 | A | 30 | A

จากตารางที่ 4.1 ผลการทดสอบประสิทธิภาพของระบบจ าแนกท่าทางภาษามือจากการทดสอบ ความถูกต้องแม่นย า ร้อยละ 96.67 ผิดเป็นท่า C (1 ครั้ง) เนื่องจากรูปทรงการก ามือพับนิ้วมีความ ใกล้เคียงกัน ท าให้ค่าสัญญาณจาก Flex Sensor คาบเกี่ยวกันในบางจังหวะ

89

ตารางที่ 4.2 ผลการทดสอบการแปลตัวอักษร B
ครั้งที่ | ผลลัพธ์ | ครั้งที่ | ผลลัพธ์ | ครั้งที่ | ผลลัพธ์
1 | B | 11 | B | 21 | B
2 | B | 12 | B | 22 | B
3 | B | 13 | B | 23 | B
4 | B | 14 | B | 24 | B
5 | B | 15 | B | 25 | B
6 | B | 16 | B | 26 | B
7 | B | 17 | B | 27 | B
8 | B | 18 | B | 28 | B
9 | B | 19 | B | 29 | B
10 | B | 20 | B | 30 | B

จากตารางที่ 4.2 ผลการทดสอบประสิทธิภาพของระบบจ าแนกท่าทางภาษามือจากการทดสอบ ความถูกต้องแม่นย า ร้อยละ 100.00

ตารางที่ 4.3 ผลการทดสอบการแปลตัวอักษร C
ครั้งที่ | ผลลัพธ์ | ครั้งที่ | ผลลัพธ์ | ครั้งที่ | ผลลัพธ์
1 | A | 11 | C | 21 | C
2 | A | 12 | C | 22 | C
3 | B | 13 | C | 23 | C
4 | A | 14 | C | 24 | C
5 | C | 15 | C | 25 | C
6 | C | 16 | C | 26 | C
7 | C | 17 | C | 27 | C
8 | C | 18 | C | 28 | C
9 | C | 19 | C | 29 | C
10 | C | 20 | C | 30 | C

90

จากตารางที่ 4.3 ผลการทดสอบประสิทธิภาพของระบบจ าแนกท่าทางภาษามือจากการทดสอบ ความถูกต้องแม ่นย า ร้อยละ 86.67 ผิดเป็นท ่า A (3 ครั้ง) และท ่า B (1 ครั้ง) เนื ่องจากลักษณะ การงอมือเป็นรูปส่วนโค้งครึ่งวงกลม (C-shape) คาบเกี่ยวกับการก ามือ (A) และการเหยียดตรง (B) เมื่อขยับองศาเล็กน้อย

ตารางที่ 4.4 ผลการทดสอบการแปลตัวอักษร D
ครั้งที่ | ผลลัพธ์ | ครั้งที่ | ผลลัพธ์ | ครั้งที่ | ผลลัพธ์
1 | D | 11 | D | 21 | D
2 | D | 12 | D | 22 | D
3 | D | 13 | D | 23 | D
4 | D | 14 | D | 24 | D
5 | D | 15 | D | 25 | D
6 | D | 16 | D | 26 | D
7 | D | 17 | D | 27 | D
8 | D | 18 | D | 28 | D
9 | D | 19 | D | 29 | D
10 | D | 20 | D | 30 | D

จากตารางที่ 4.4 ผลการทดสอบประสิทธิภาพของระบบจ าแนกท่าทางภาษามือจากการทดสอบ ความถูกต้องแม่นย า ร้อยละ 100.00

91

ตารางที่ 4.5 ผลการทดสอบการแปลตัวอักษร E
ครั้งที่ | ผลลัพธ์ | ครั้งที่ | ผลลัพธ์ | ครั้งที่ | ผลลัพธ์
1 | A | 11 | E | 21 | E
2 | A | 12 | E | 22 | E
3 | E | 13 | E | 23 | E
4 | E | 14 | E | 24 | E
5 | E | 15 | E | 25 | E
6 | E | 16 | E | 26 | E
7 | E | 17 | E | 27 | E
8 | E | 18 | E | 28 | E
9 | E | 19 | E | 29 | E
10 | E | 20 | E | 30 | E

จากตารางที่ 4.5 ผลการทดสอบประสิทธิภาพของระบบจ าแนกท่าทางภาษามือจากการทดสอบ ความถูกต้องแม่นย า ร้อยละ 93.33 ผิดเป็นท่า A (2 ครั้ง) เนื่องจากรูปทรงการพับนิ้วทั้งสี่ลงมาสบกับ ฝ่ามือคล้ายคลึงกับท่าก าปั้น (A) มาก ท าให้เซนเซอร์อ่านค่าได้ใกล้เคียงกัน

ตารางที่ 4.6 ผลการทดสอบการแปลตัวอักษร F
ครั้งที่ | ผลลัพธ์ | ครั้งที่ | ผลลัพธ์ | ครั้งที่ | ผลลัพธ์
1 | F | 11 | F | 21 | F
2 | F | 12 | F | 22 | F
3 | F | 13 | F | 23 | F
4 | F | 14 | F | 24 | F
5 | F | 15 | F | 25 | F
6 | F | 16 | F | 26 | F
7 | F | 17 | F | 27 | F
8 | F | 18 | F | 28 | F
9 | F | 19 | F | 29 | F
10 | F | 20 | F | 30 | F

92

จากตารางที่ 4.6 ผลการทดสอบประสิทธิภาพของระบบจ าแนกท่าทางภาษามือจากการทดสอบ ความถูกต้องแม่นย า ร้อยละ 100.00

ตารางที่ 4.7 ผลการทดสอบการแปลตัวอักษร G
ครั้งที่ | ผลลัพธ์ | ครั้งที่ | ผลลัพธ์ | ครั้งที่ | ผลลัพธ์
1 | G | 11 | G | 21 | G
2 | G | 12 | G | 22 | G
3 | G | 13 | G | 23 | G
4 | G | 14 | G | 24 | G
5 | G | 15 | G | 25 | G
6 | G | 16 | G | 26 | G
7 | G | 17 | G | 27 | G
8 | G | 18 | G | 28 | G
9 | G | 19 | G | 29 | G
10 | G | 20 | G | 30 | G

จากตารางที่ 4.7 ผลการทดสอบประสิทธิภาพของระบบจ าแนกท่าทางภาษามือจากการทดสอบ ความถูกต้องแม่นย า ร้อยละ 100.00

93

ตารางที่ 4.8 ผลการทดสอบการแปลตัวอักษร H
ครั้งที่ | ผลลัพธ์ | ครั้งที่ | ผลลัพธ์ | ครั้งที่ | ผลลัพธ์
1 | H | 11 | H | 21 | H
2 | H | 12 | H | 22 | H
3 | H | 13 | H | 23 | H
4 | H | 14 | H | 24 | H
5 | H | 15 | H | 25 | H
6 | H | 16 | H | 26 | H
7 | H | 17 | H | 27 | H
8 | H | 18 | H | 28 | H
9 | H | 19 | H | 29 | H
10 | H | 20 | H | 30 | H

จากตารางที่ 4.8 ผลการทดสอบประสิทธิภาพของระบบจ าแนกท่าทางภาษามือจากการทดสอบ ความถูกต้องแม่นย า ร้อยละ 100.00

ตารางที่ 4.9 ผลการทดสอบการแปลตัวอักษร I
ครั้งที่ | ผลลัพธ์ | ครั้งที่ | ผลลัพธ์ | ครั้งที่ | ผลลัพธ์
1 | I | 11 | I | 21 | I
2 | I | 12 | I | 22 | I
3 | I | 13 | I | 23 | I
4 | I | 14 | I | 24 | I
5 | I | 15 | I | 25 | I
6 | I | 16 | I | 26 | I
7 | I | 17 | I | 27 | I
8 | I | 18 | I | 28 | I
9 | I | 19 | I | 29 | I
10 | I | 20 | I | 30 | I

94

จากตารางที่ 4.9 ผลการทดสอบประสิทธิภาพของระบบจ าแนกท่าทางภาษามือจากการทดสอบ ความถูกต้องแม่นย า ร้อยละ 100.00

ตารางที่ 4.10 ผลการทดสอบการแปลตัวอักษร J
ครั้งที่ | ผลลัพธ์ | ครั้งที่ | ผลลัพธ์ | ครั้งที่ | ผลลัพธ์
1 | I | 11 | J | 21 | J
2 | Y | 12 | J | 22 | J
3 | I | 13 | J | 23 | J
4 | Y | 14 | J | 24 | J
5 | J | 15 | J | 25 | J
6 | J | 16 | J | 26 | J
7 | J | 17 | J | 27 | J
8 | J | 18 | J | 28 | J
9 | J | 19 | J | 29 | J
10 | J | 20 | J | 30 | J

จากตารางที ่ 4.10 ผลการทดสอบประสิทธิภาพของระบบจ าแนกท ่าทางภาษามือจากการ ทดสอบ ความถูกต้องแม่นย า ร้อยละ 86.67 ผิดเป็นท่า I (2 ครั้ง) และท่า Y (2 ครั้ง) เกิดจากปัจจัย ด้านไดนามิก ที่ต้องสะบัดมือวาดรูปตัว J หากขยับมือช้าหรือเซนเซอร์ IMU ตรวจจับจังหวะสะบัดไม่ ทัน ระบบจะมองเห็นเพียงนิ้วก้อยตั้งตรงค้างไว้

95

ตารางที่ 4.11 ผลการทดสอบการแปลตัวอักษร K
ครั้งที่ | ผลลัพธ์ | ครั้งที่ | ผลลัพธ์ | ครั้งที่ | ผลลัพธ์
1 | No | 11 | K | 21 | K
2 | U | 12 | K | 22 | K
3 | V | 13 | K | 23 | K
4 | V | 14 | K | 24 | K
5 | K | 15 | K | 25 | K
6 | K | 16 | K | 26 | K
7 | K | 17 | K | 27 | K
8 | K | 18 | K | 28 | K
9 | K | 19 | K | 29 | K
10 | K | 20 | K | 30 | K

จากตารางที่ 4.11 ผลการทดสอบประสิทธิภาพของระบบจ าแนกท่าทางภาษามือจากการทดสอบ ความถูกต้องแม่นย า ร้อยละ 86.67 ผิดเป็นท่า V (2 ครั้ง), No (1 ครั้ง), U (1 ครั้ง) สับสนในกลุ่มท่าชู สองนิ้ว (ชี้และกลาง) ซึ่งมีค่าสัญญาณพับนิ้วคล้ายกัน แตกต่างกันเพียงองศาการกางนิ้วในแนวนอนที่ เซนเซอร์ Flex วัดไม่ได้โดยตรง

ตารางที่ 4.12 ผลการทดสอบการแปลตัวอักษร L
ครั้งที่ | ผลลัพธ์ | ครั้งที่ | ผลลัพธ์ | ครั้งที่ | ผลลัพธ์
1 | I love you | 11 | L | 21 | L
2 | I love you | 12 | L | 22 | L
3 | K | 13 | L | 23 | L
4 | K | 14 | L | 24 | L
5 | L | 15 | L | 25 | L
6 | L | 16 | L | 26 | L
7 | L | 17 | L | 27 | L
8 | L | 18 | L | 28 | L
9 | L | 19 | L | 29 | L
10 | L | 20 | L | 30 | L

96

จากตารางที ่ 4.12 ผลการทดสอบประสิทธิภาพของระบบจ าแนกท ่าทางภาษามือจากการ ทดสอบ ความถูกต้องแม่นย า ร้อยละ 86.67 ผิดเป็นท่า I love you (2 ครั้ง) และท่า K (2 ครั้ง) การชู นิ้วชี้และนิ้วโป้งอาจมีความคาบเกี่ยวกับท่าชูสามนิ้วหรือท่าชูสองนิ้วเอียง หากนิ้วนางและนิ้วก้อยพับ งอไม่สนิทแน่นพอ

ตารางที่ 4.13 ผลการทดสอบการแปลตัวอักษร M
ครั้งที่ | ผลลัพธ์ | ครั้งที่ | ผลลัพธ์ | ครั้งที่ | ผลลัพธ์
1 | M | 11 | M | 21 | M
2 | M | 12 | M | 22 | M
3 | M | 13 | M | 23 | M
4 | M | 14 | M | 24 | M
5 | M | 15 | M | 25 | M
6 | M | 16 | M | 26 | M
7 | M | 17 | M | 27 | M
8 | M | 18 | M | 28 | M
9 | M | 19 | M | 29 | M
10 | M | 20 | M | 30 | M

จากตารางที ่ 4.13 ผลการทดสอบประสิทธิภาพของระบบจ าแนกท ่าทางภาษามือจากการ ทดสอบ ความถูกต้องแม่นย า ร้อยละ 100.00

97

ตารางที่ 4.14 ผลการทดสอบการแปลตัวอักษร N
ครั้งที่ | ผลลัพธ์ | ครั้งที่ | ผลลัพธ์ | ครั้งที่ | ผลลัพธ์
1 | N | 11 | N | 21 | N
2 | T | 12 | N | 22 | N
3 | N | 13 | N | 23 | N
4 | T | 14 | N | 24 | N
5 | N | 15 | N | 25 | N
6 | T | 16 | N | 26 | N
7 | N | 17 | N | 27 | N
8 | N | 18 | N | 28 | N
9 | M | 19 | N | 29 | N
10 | N | 20 | N | 30 | N

จากตารางที ่ 4.14 ผลการทดสอบประสิทธิภาพของระบบจ าแนกท ่าทางภาษามือจากการ ทดสอบ ความถูกต้องแม่นย า ร้อยละ 86.67 ผิดเป็นท่า T (3 ครั้ง) และท่า M (1 ครั้ง) เนื่องจากรูปทรง ก าปั้นที่สอดนิ้วโป้งหลบใต้ข้อนิ้วมีความคาบเกี่ยวกันสูงมาก (N สอดใต้ชี้-กลาง, T สอดระหว่างชี้-กลาง) ท าให้สัญญาณทับซ้อนกัน

ตารางที่ 4.15 ผลการทดสอบการแปลตัวอักษร O
ครั้งที่ | ผลลัพธ์ | ครั้งที่ | ผลลัพธ์ | ครั้งที่ | ผลลัพธ์
1 | C | 11 | O | 21 | O
2 | O | 12 | O | 22 | O
3 | C | 13 | O | 23 | O
4 | C | 14 | O | 24 | O
5 | O | 15 | O | 25 | O
6 | O | 16 | O | 26 | O
7 | O | 17 | O | 27 | O
8 | O | 18 | O | 28 | O
9 | O | 19 | O | 29 | O
10 | O | 20 | O | 30 | O

98

จากตารางที่ 4.15 ผลการทดสอบประสิทธิภาพของระบบจ าแนกท่าทางภาษามือจากการ ทดสอบ ความถูกต้องแม่นย า ร้อยละ 90.00 ผิดเป็นท่า C (3 ครั้ง) เนื่องจากท่าห่อข้อนิ้วเป็นวงกลม
(O) มีลักษณะทางกายภาพโค้งมนใกล้เคียงกับท่ารูปตัวครึ่งวงกลม (C) ส่งผลให้ค่าจากเซนเซอร์งอนิ้ว อยู่ในโซนเดียวกัน

ตารางที่ 4.16 ผลการทดสอบการแปลตัวอักษร P
ครั้งที่ | ผลลัพธ์ | ครั้งที่ | ผลลัพธ์ | ครั้งที่ | ผลลัพธ์
1 | P | 11 | P | 21 | P
2 | P | 12 | P | 22 | P
3 | P | 13 | P | 23 | P
4 | P | 14 | P | 24 | P
5 | P | 15 | P | 25 | P
6 | P | 16 | P | 26 | P
7 | P | 17 | P | 27 | P
8 | P | 18 | P | 28 | P
9 | P | 19 | P | 29 | P
10 | P | 20 | P | 30 | P

จากตารางที ่ 4.16 ผลการทดสอบประสิทธิภาพของระบบจ าแนกท ่าทางภาษามือจากการ ทดสอบ ความถูกต้องแม่นย า ร้อยละ 100.00

99

ตารางที่ 4.17 ผลการทดสอบการแปลตัวอักษร Q
ครั้งที่ | ผลลัพธ์ | ครั้งที่ | ผลลัพธ์ | ครั้งที่ | ผลลัพธ์
1 | Q | 11 | Q | 21 | Q
2 | Q | 12 | Q | 22 | Q
3 | Q | 13 | Q | 23 | Q
4 | Q | 14 | Q | 24 | Q
5 | Q | 15 | Q | 25 | Q
6 | Q | 16 | Q | 26 | Q
7 | Q | 17 | Q | 27 | Q
8 | Q | 18 | Q | 28 | Q
9 | Q | 19 | Q | 29 | Q
10 | Q | 20 | Q | 30 | Q

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
2 | Yes | 12 | Yes | 22 | Yes
3 | Yes | 13 | Yes | 23 | Yes
4 | Yes | 14 | Yes | 24 | Yes
5 | Yes | 15 | Yes | 25 | Yes
6 | Yes | 16 | Yes | 26 | Yes
7 | Yes | 17 | Yes | 27 | Yes
8 | Yes | 18 | Yes | 28 | Yes
9 | Yes | 19 | Yes | 29 | Yes
10 | Yes | 20 | Yes | 30 | Yes

108

จากตารางที ่ 4.30 ผลการทดสอบประสิทธิภาพของระบบจ าแนกท ่าทางภาษามือจากการ ทดสอบ ความถูกต้องแม่นย า ร้อยละ 100.00

ตารางที่ 4.31 ผลการทดสอบการแปลค าว่า No
ครั้งที่ | ผลลัพธ์ | ครั้งที่ | ผลลัพธ์ | ครั้งที่ | ผลลัพธ์
1 | No | 11 | No | 21 | No
2 | No | 12 | No | 22 | No
3 | No | 13 | No | 23 | No
4 | No | 14 | No | 24 | No
5 | No | 15 | No | 25 | No
6 | No | 16 | No | 26 | No
7 | No | 17 | No | 27 | No
8 | No | 18 | No | 28 | No
9 | No | 19 | No | 29 | No
10 | No | 20 | No | 30 | No

จากตารางที ่ 4.31 ผลการทดสอบประสิทธิภาพของระบบจ าแนกท ่าทางภาษามือจากการ ทดสอบ ความถูกต้องแม่นย า ร้อยละ 100.00
จากการทดสอบระบบถุงมือแปลภาษามือ (ข้างเดียว) โดยใช้ Flex Sensor 5 นิ้ว ร่วมกับ MPU6050 ส่งข้อมูลผ่าน ESP32 ทาง UDP ไปยังโมเดล MLP Classifier เพื่อจ าแนกท่าทาง รวม 31 ท่าทาง (ตัวอักษร A-Z และค าศัพท์) ทดสอบท่าละ 30 ครั้ง สรุปผลรวมทั้ง 31 ท่าทาง มีค่าความ แม่นย ารวม 96.02% คิดจากสมการที่ 11

X
N
= ค่าเฉลี่ยความแม่นย ารวม | (11)

โดยที่ X = ผลรวมที่ได้จากการทดลอง ได้แก่ ท่าทางที่มีความแม่นย าร้อยละ 100 ได้แก่ B, D, F, G, H, I, M, P, Q, S, T, W, X, Y, Z และค าศัพท์ทั้งหมด (Hello, Thank you, I love you, Yes, No) ท่าทางที่มีความแม่นย าร้อยละ 96.67% ได้แก่ A

109

ท่าทางที่มีความแม่นย าร้อยละ 93.33% ได้แก่ E, V ท่าทางที่มีความแม่นย าร้อยละ 90.00% ได้แก่ O ท่าทางที่มีความแม่นย าร้อยละ 86.67% ได้แก่ C, J, L, N, K, R ท่าทางที่มีความแม่นย าร้อยละ 83.33% ได้แก่ U
N = จ านวนท่าทางทั้งหมด

### 4.3 ผลการแสดงผลการจ าแนกท่าทาง

ในการทดสอบประสิทธิภาพของโปรแกรม คณะผู้จัดท าได้ท าการทดสอบจ าแนกท่าทางภาษามือ ผ่านการใช้งานจริงร่วมกับเว็บแอปพลิเคชัน เพื่อตรวจสอบความถูกต้องของค าแปลแต่ละท่าทางตาม ขอบเขตที่ก าหนด โดยทดสอบครอบคลุมท่าทางทั้ง 31 ท่า ได้แก่ ตัวอักษร A–Z (26 ท่า) และค าศัพท์ Hello, Thank you, I love you, Yes, No (5 ท่า) ผลการทดสอบแสดงการเปรียบเทียบระหว ่าง ท่าทางของถุงมือและผลลัพธ์บนหน้าจอ ดังตารางที่ 4.32

ตารางที่ 4.32 ผลการแสดงการจ าแนกท่าทาง
ตัวอักษรและ ค า | ภาพถ่ายขณะท าและผลลัพธ์

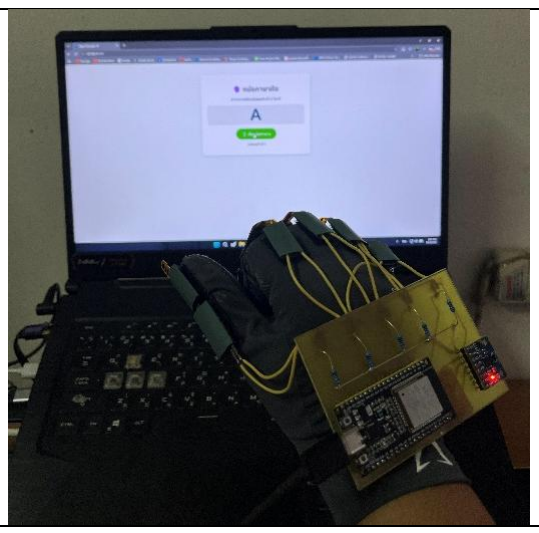
[picture p55: figure]

A

110

ตารางที่ 4.33 ผลการแสดงการจ าแนกท่าทาง (ต่อ)
ตัวอักษรและ ค า | ภาพถ่ายขณะท าและผลลัพธ์

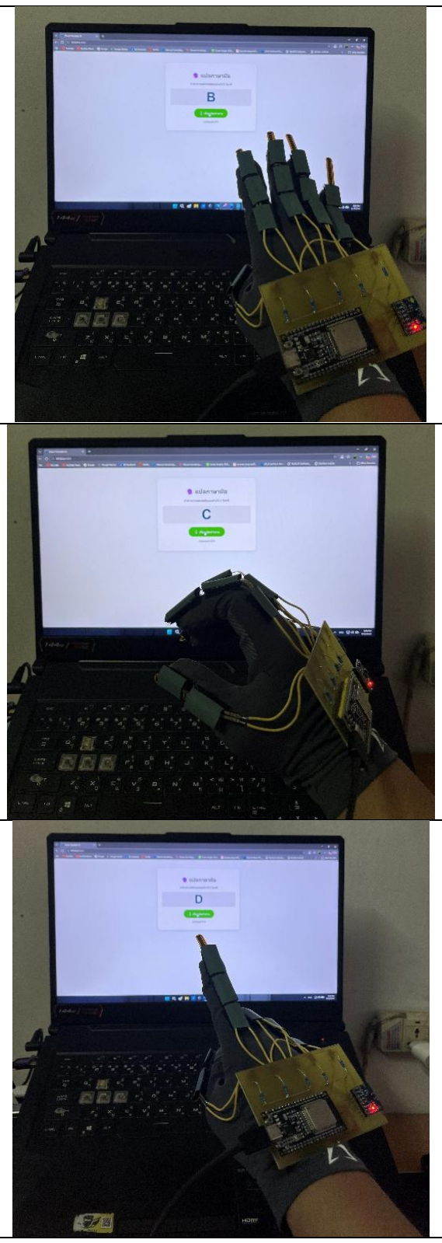
[picture p56: figure]

B

C

D

111

ตารางที่ 4.32 ผลการแสดงการจ าแนกท่าทาง (ต่อ)
ตัวอักษรและ ค า | ภาพถ่ายขณะท าและผลลัพธ์

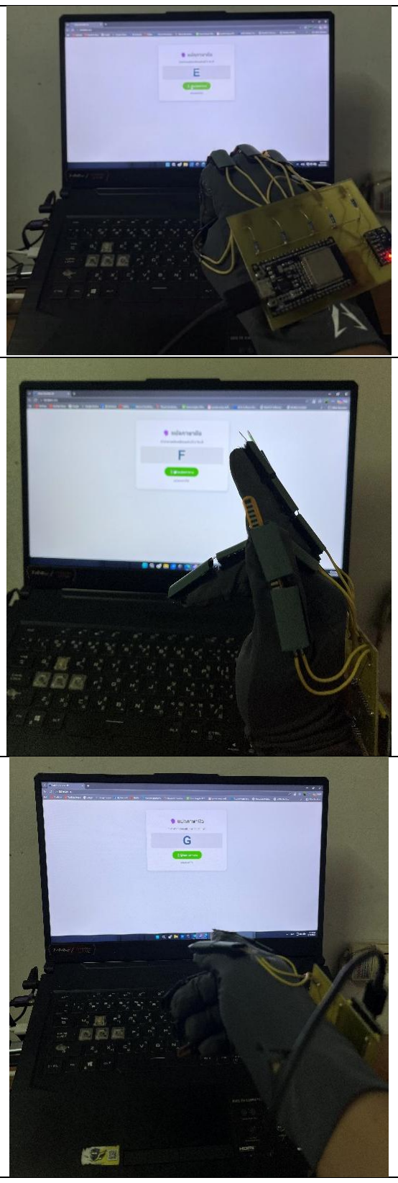
[picture p57: figure]

E

F

G

112

ตารางที่ 4.32 ผลการแสดงการจ าแนกท่าทาง (ต่อ)
ตัวอักษรและ ค า | ภาพถ่ายขณะท าและผลลัพธ์

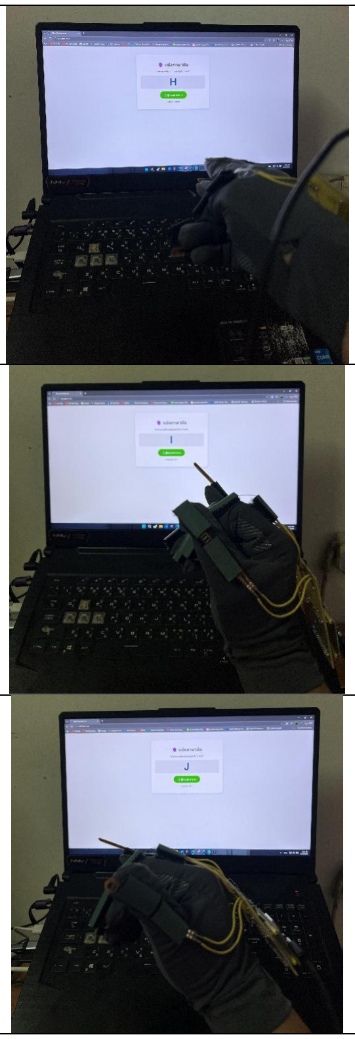
[picture p58: figure]

H

I

J

113

ตารางที่ 4.32 ผลการแสดงการจ าแนกท่าทาง (ต่อ)
ตัวอักษรและ ค า | ภาพถ่ายขณะท าและผลลัพธ์

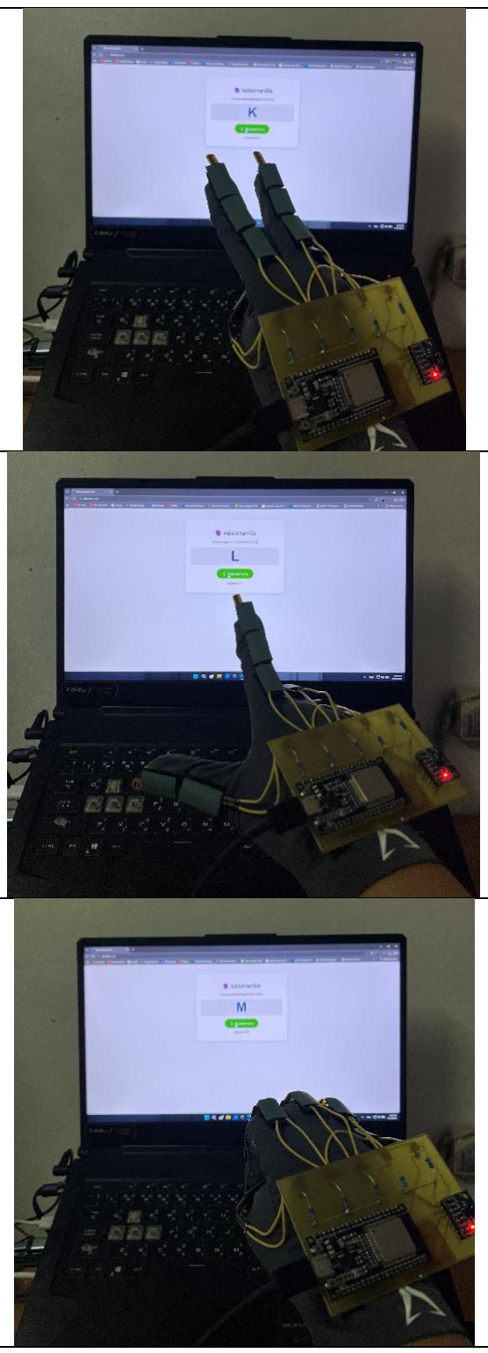
[picture p59: figure]

K

L

M

114

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

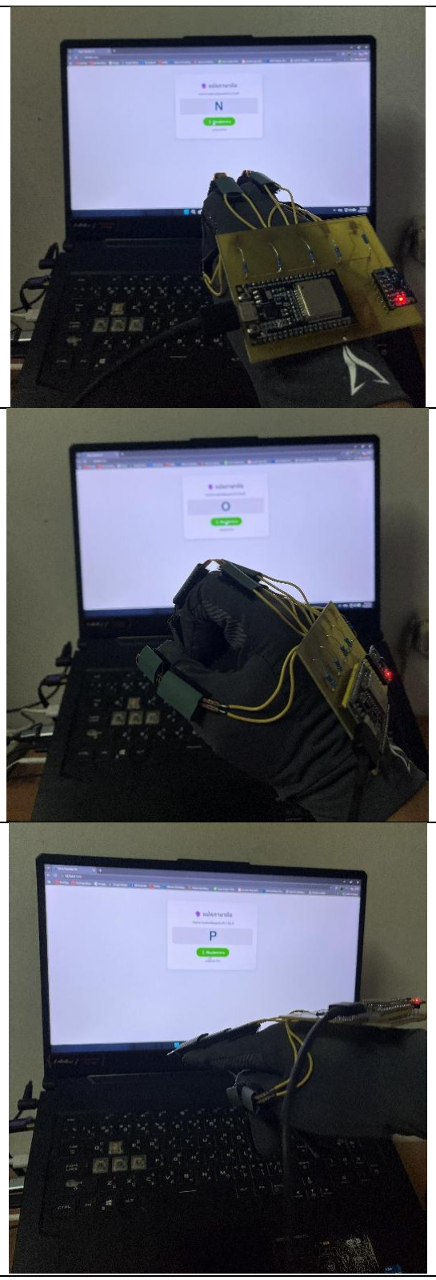
[picture p60: figure]

N

O

P

115

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

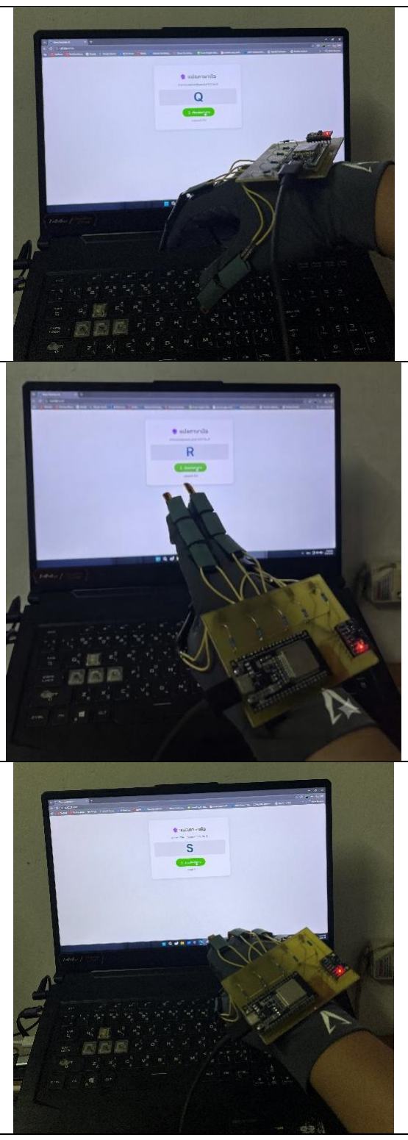
[picture p61: figure]

Q

R

S

116

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

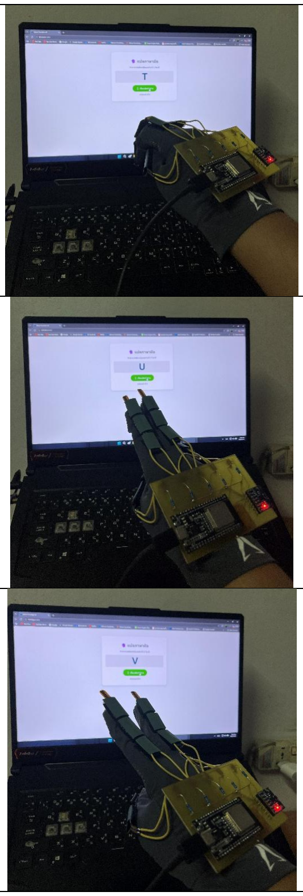
[picture p62: figure]

T

U

V

117

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

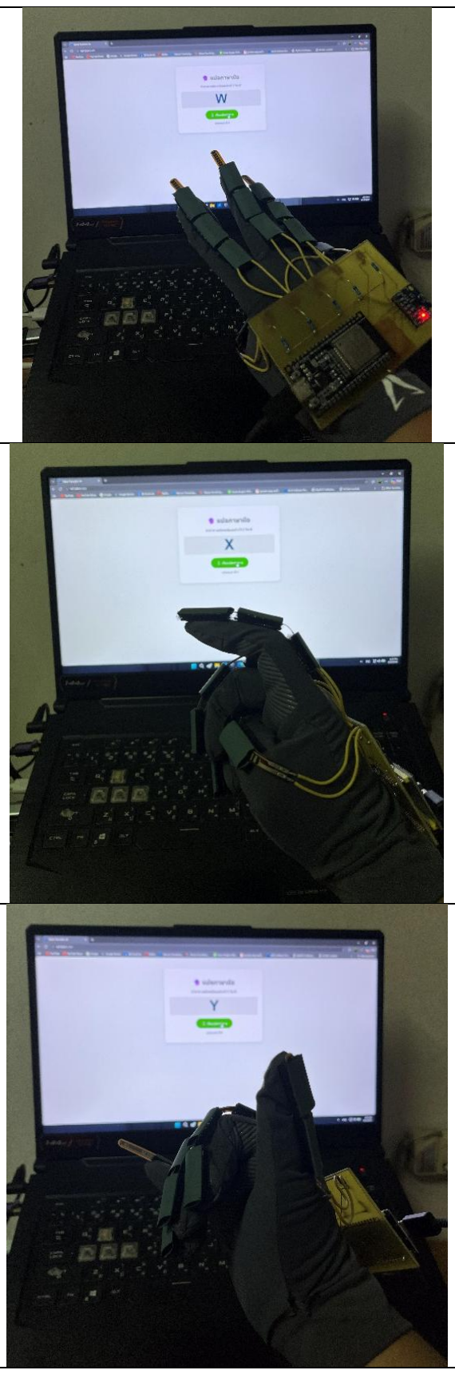
[picture p63: figure]

W

X

Y

118

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

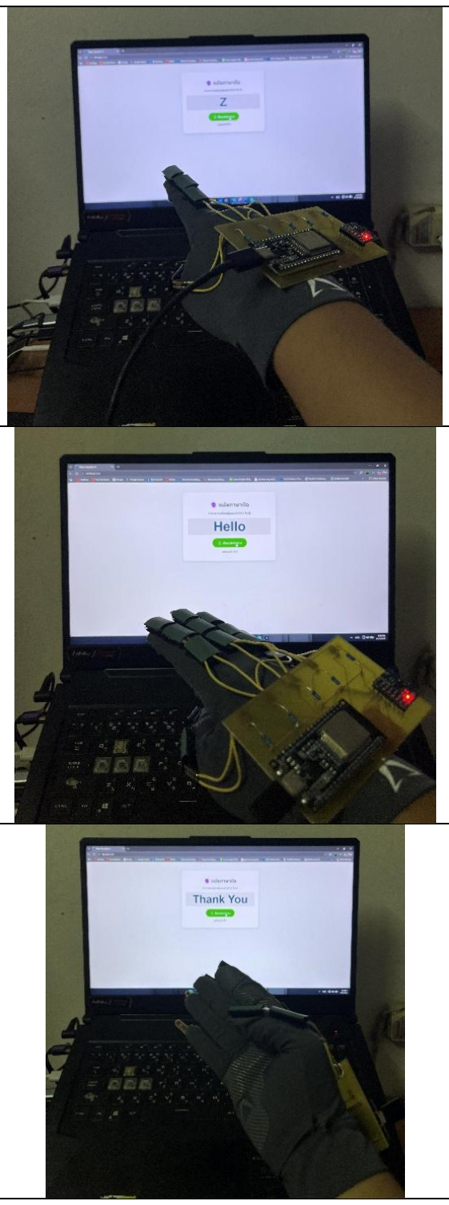
[picture p64: figure]

Z

Hello

Thank you

119

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

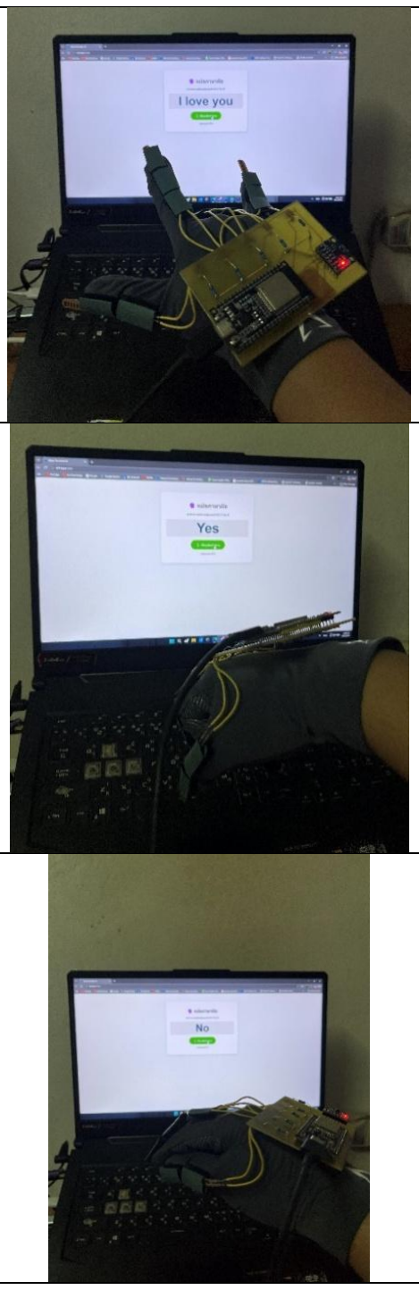
[picture p65: figure]

I love u

Yes

No

120

### 4.4 สรุปผลการทดลอง

จากผลการด าเนินงานและการทดสอบใช้งานระบบถุงมือแปลภาษามืออัจฉริยะร่วมกับเว็บแอป พลิเคชันที่พัฒนาขึ้น สามารถสรุปผลตามขอบเขตที่ก าหนดไว้ได้ดังนี้
1. ESP32 เป็นตัวส่งข้อมูล บอร์ดไมโครคอนโทรลเลอร์ ESP32 สามารถรับค่าสัญญาณจาก Flex Sensor และ MPU6050 แล้วส ่งข้อมูลผ ่าน Wi-Fi โปรโตคอล UDP พอร์ต 4210 ได้อย ่าง ต่อเนื่องและมีความหน่วงต ่า
2. Flex Sensor 5 ชิ้นวัดการงอของนิ้ว เซนเซอร์ทั้ง 5 ตัวท างานได้อย่างถูกต้อง ให้ค่าความ ต้านทานที่สัมพันธ์กับการโค้งงอของนิ้วมือแต่ละนิ้ว ซึ่งแตกต่างกันอย่างชัดเจนตามแต่ละท่าทาง
3. MPU6050 วัดระนาบและการเคลื่อนไหวของข้อมือ โดยเซนเซอร์ให้ค่า Accelerometer และ Gyroscope ทั้ง 6 แกน ซึ่งเป็นข้อมูลส าคัญในการแยกแยะท่าทางที่มีรูปมือคล้ายกันแต่มีการ วางมือต่างกัน และท่าทางที่มีการเคลื่อนไหว เช่น J, Z, Hello
4. Flask แสดงผลพร้อมปุ ่มควบคุม เว็บแอปพลิเคชันท างานได้ตามที ่ออกแบบไว้ ผู้ใช้งาน สามารถกดปุ่มแปลเพื่อเริ่มเก็บข้อมูล 60 เฟรม และรับผลลัพธ์เป็นข้อความบนหน้าจอได้ทันที
5. รองรับมือเดียว 31 ท่าทาง ระบบรองรับการแปลท่าทางได้ครบตามขอบเขต ทั้งตัวอักษร A–Z และค าศัพท์ Hello, Thank you, I love you, Yes, No โดยโมเดล MLP Classifier มีค่าความ แม่นย ารวม 96.02% ที่ได้จากการทดสอบท าท่าทางแต่ละรูปแบบซ ้ารูปแบบละ 30 ครั้ง
6. ท านายจาก Flex Sensor และ MPU6050 ได้จริง ระบบสามารถรับค ่าเซนเซอร์ 11 พารามิเตอร์ต่อเฟรม รวม 660 มิติต่อการแปล 1 ครั้ง และผ่านโมเดล MLP ได้ผลลัพธ์ที่ถูกต้องและ เสถียรตามเกณฑ์ประสิทธิภาพของโครงงาน

บทที่5
สรุปผลการด าเนินงานและข้อเสนอแนะ

### 5.1 สรุปผลการด าเนินงาน

จากการด าเนินงานตามขั้นตอนที ่วางไว้ คณะผู้จัดท าสามารถพัฒนาและประกอบชุดถุงมือที่ สามารถรับค่าสัญญาณการงอนิ้วมือและทิศทางข้อมือส่งผ่านระบบไร้สายไปยังเครื่องประมวลผลได้ ส าเร็จ ในด้านการพัฒนาปัญญาประดิษฐ์ โมเดลโครงข ่ายประสาทเทียมแบบ Multi-layer Perceptron ที่ฝึกสอนด้วยชุดข้อมูลที่รวบรวมขึ้นเองมีประสิทธิภาพในการจ าแนกท่าทางภาษามือ (ตัวอักษร A-Z และค าศัพท์พื้นฐาน) ได้อย่างแม่นย า โดยมีค่าความแม่นย า 96.02 % จากที่ท าในบทที่ 4.2 และเมื่อน ามาท างานร่วมกับระบบเว็บแอปพลิเคชันพบว ่าระบบสามารถแปลผลภาษามือและ แสดงผลได้อย่างเสถียรและถูกต้องตามวัตถุประสงค์ที่ตั้งไว้

### 5.2 ปัญหาและอุปสรรค

1. ความทนทานของฮาร์ดแวร์เซนเซอร์ตรวจจับการโค้งงอมีความบอบบาง หากใช้งานด้วยแรง กดที่มากเกินไปหรือพับงอผิดองศาอาจท าให้ค่าสัญญาณคลาดเคลื่อนหรือเซนเซอร์เสียหายได้
2. ความเสถียรของเครือข่ายไร้สาย เนื่องจากเป็นการส่งข้อมูลผ่านโปรโตคอล UDP ซึ่งไม่มีการ ยืนยันการรับส่งข้อมูล หากอยู่ในสภาพแวดล้อมที่มีสัญญาณ Wi-Fi หนาแน่น อาจเกิดการสูญเสีย แพ็กเก็ตข้อมูล ได้ในบางช่วง
3. ข้อจ ากัดของชุดข้อมูล ชุดข้อมูลที่ใช้สอนโมเดลส่วนใหญ่มาจากผู้ทดสอบคนเดียว ซึ่งอาจ ส่งผลต่อความแม ่นย าเมื่อน าไปใช้กับผู้ใช้คนอื่นที ่มีขนาดมือหรือลักษณะการท าท่าทางที ่แตกต ่าง ออกไป
4. การออกแบบและต่อวงจารที่มีความซับซ้อนมากอาจท าให้เกิดการต่อวงจรที่ผิดพลาด

### 5.3 แนวทางในการน าไปพัฒนาต่อ

1. การเพิ่มความหลากหลายของชุดข้อมูล รวบรวมข้อมูลจากกลุ่มตัวอย่างที่มีขนาดมือและ สรีระที่แตกต่างกัน รวมถึงการเก็บข้อมูลในสภาพแวดล้อมที่หลากหลาย เพื่อให้โมเดลมีความทนทาน และใช้งานได้กับทุกคน

122

2. การส่งออกแบบเสียง พัฒนาให้ระบบสามารถอ่านออกเสียงค าแปลได้ทันทีผ่านล าโพงของ สมาร์ทโฟน เพื่อให้ผู้พิการทางการได้ยินสามารถสื่อสารกับบุคคลทั่วไปได้โดยไม่ต้องจ้องมองหน้าจอ เพียงอย่างเดียว
3. พัฒนาแอปพลิเคชันบนมือถือ ย้ายส่วนประมวลผลและหน้าจอแสดงผลไปอยู่บนสมาร์ทโฟน ผ่านทางแอปพลิเคชัน เพื่อเพิ่มความคล่องตัวในการพกพาไปใช้งานนอกสถานที่
4. การเชื่อมต่อกับระบบ AI ขนาดใหญ่ น าค าแปลที่ได้ไปประมวลผลต่อด้วย AI อย่าง ChatGPT หรือ Gemini เพื่อช่วยเกลาประโยคที่แปลจากภาษามือให้เป็นภาษาเขียนที่สละสลวยและ เข้าใจง่ายขึ้น
5. การประมวลผลภาษามือแบบต่อเนื่อง ต่อยอดจากโมเดล Multi-layer Perceptron ไปสู่ โครงสร้างแบบ Long Short-Term Memory หรือ Gated Recurrent Unit เพื่อให้ระบบสามารถ แปลภาษามือที่มีการเคลื่อนไหวต่อเนื่องเป็นประโยคยาวๆ ได้

123

บรรณานุกรม

Arduino. (n.d.). Arduino IDE Software and Documentation.
,สืบค้น จาก https://www.arduino.cc/en/software

Espressif Systems. (n.d.). ESP32 Series Datasheet and Technical Reference Manual.
,สืบค้น จาก ESP32 Wi-Fi & Bluetooth SoC | Espressif Systems (https://www.espressif.com/en/products/socs/esp32)

Flask. (n.d.). Flask Documentation (User's Guide).
,สืบค้น จาก Welcome to Flask — Flask Documentation (3.1.x) (https://flask.palletsprojects.com/en/stable/)

InvenSense. (n.d.). MPU-6050 Product Specification and Datasheet.
,สืบค้น จาก https://invensense.tdk.com/products/motion-tracking/6-axis/mpu-6050/ (https://www.google.com/search?authuser=1)

Python Software Foundation. (n.d.). Python 3.x Documentation.
,สืบค้น จาก https://www.python.org/doc/

Postel, J. (1980). User Datagram Protocol (RFC 768).
,สืบค้น จาก https://datatracker.ietf.org/doc/html/rfc768

Scikit-learn. (n.d.). Scikit-learn: Machine Learning in Python - Neural Network Models (Supervised Multi-layer Perceptron).
,สืบค้น จาก https://scikit-learn.org/stable/modules/neural_networks_supervised.html (https://scikit-learn.org/stable/modules/neural_networks_supervised.html)

W3C. (n.d.). JavaScript Object Notation (JSON) Data Interchange Format. ,สืบค้น จาก https://www.w3.org/TR/json-ld/

124

ภาคผนวก ก

โค้ดการเทรนการแปลภาษามือ

125

#การน าเข้าไลบรารีที่จ าเป็น import os

import json
import joblib
import numpy as np
import matplotlib.pyplot as plt
import seaborn as sns
from sklearn.model_selection import train_test_split
from sklearn.preprocessing import StandardScaler
from sklearn.neural_network import MLPClassifier
from sklearn.metrics import accuracy_score, confusion_matrix, classification_report #น าเข้าชุดข้อมูล
DATASET_FILE = 'dynamic_data_60fnew.json'
MODEL_FILE = 'smart_glove_model_dynamic2.pkl'
SCALER_FILE = 'scaler_dynamic2.pkl'
#ก าหนดโมเดล

model = MLPClassifier
#เทรนโมเดล

model = MLPClassifier(
hidden_layer_sizes=(256, 128), activation='relu',
solver='adam',
max_iter=500,
random_state=42,
verbose=True,
early_stopping=False
)
#บันทึกโมเดลในรูปแบบ joblib joblib.dump(model_data, MODEL_FILE) joblib.dump(scaler, SCALER_FILE)

126

ภาคผนวก ข

โค้ดการท างานของแอปพลิเคชันท านายผลภาษามือ

127

#ส่วนน าเข้าไลบรารีที่ใช้

import json
import socket
import sys
import joblib
import numpy as np
from flask import Flask, jsonify, render_template #ส่วนใช้โหลดโมเดลและข้อมูลที่จ าเป็น
MODEL_FILE = 'smart_glove_model_dynamic2.pkl' SCALER_FILE = 'scaler_dynamic2.pkl'
UDP_IP = "0.0.0.0"
UDP_PORT = 4210
# ฟังก์ชันการทายผลของโมเดล

X_realtime = np.array(buffer_frames).reshape(1, -1) X_realtime_scaled = scaler.transform(X_realtime) prediction = model.predict(X_realtime_scaled)[0]

128

ภาคผนวก ค

โค้ดการเทรนการส่งข้อมูล

129

#ส่วนน าเข้าไลบรารีที่ใช้

#include <WiFi.h>

#include <WiFiUdp.h>

#include <Arduino_JSON.h>

#include <Adafruit_MPU6050.h> #include <Adafruit_Sensor.h> #include <Wire.h>

#ส่วนก าหนด IP ที่ใช้

const char* ssid = "BB";
const char* password = "12345678"; const char* udpAddress = "172.20.10.13"; const int udpPort = 4210;
#ส่วนก าหนด IP ที่ใช้

float ax_off = 0, ay_off = 0, az_off = 0; float gx_off = 0, gy_off = 0, gz_off = 0; #ฟังก์ชัน Calibrate
void calibrateMPU() {
int samples = 200;
for (int i = 0; i < samples; i++) { sensors_event_t a, g, temp; mpu.getEvent(&a, &g, &temp); ax_off += a.acceleration.x; ay_off += a.acceleration.y; az_off += a.acceleration.z - 9.81; gx_off += g.gyro.x;
gy_off += g.gyro.y;
gz_off += g.gyro.z;
delay(10);
}

130

ax_off /= samples;
ay_off /= samples;
az_off /= samples;
gx_off /= samples;
gy_off /= samples;
gz_off /= samples;
}
#ฟังก์ชัน การส่งข้อมูล

void sendData() {
sensors_event_t a, g, temp; mpu.getEvent(&a, &g, &temp); JSONVar payload;
JSONVar flex;
flex[0] = analogRead(35);
flex[1] = analogRead(34);
flex[2] = analogRead(39);
flex[3] = analogRead(36);
flex[4] = analogRead(32);
payload["flex"] = flex;
JSONVar acc;
acc[0] = a.acceleration.x - ax_off; acc[1] = a.acceleration.y - ay_off; acc[2] = a.acceleration.z - az_off; payload["acc"] = acc;
JSONVar gyro;
gyro[0] = g.gyro.x - gx_off; gyro[1] = g.gyro.y - gy_off;
gyro[2] = g.gyro.z - gz_off;
payload["gyro"] = gyro;
String jsonString = JSON.stringify(payload);

131

udp.beginPacket(udpAddress, udpPort); udp.print(jsonString);
udp.endPacket();
}

132

ภาคผนวก ง

โค้ดการเทรนการเก็บข้อมูล

133

#น าเข้าไลบรารีที่จ าเป็น

import os
import json
import socket
import datetime
#ก าหนดรูปแบบการเซฟข้อมูลและ IP UDP_IP = "0.0.0.0"

UDP_PORT = 4210
FILENAME = "dynamic_data_60fnew.json" TARGET_FRAMES = 60
#ฟังก์ชัน การเก็บข้อมูล

if len(sequence_buffer) == TARGET_FRAMES: record = {
"label": current_label,
"data": sequence_buffer,
"timestamp": datetime.datetime.now().isoformat() }
data_store.append(record)
print(" Done!")
with open(FILENAME, 'w', encoding='utf-8') as f: json.dump(data_store, f, indent=4)

134

ประวัติผู้เขียน

ชื่อ – นามสกุล | ศุภโชค ชูใจ
วัน – เดือน – ปีเกิด | เกิดวันที่ 18 ธันวาคม พ.ศ.2546
สถานที่เกิด | จังหวัดกรุงเทพมหานคร
การศึกษา | โรงเรียน พระแม่มารีสาธุประดิษฐ์
| มัธยมศึกษาชั้นปีที่ 6, 2565
| มหาวิทยาลัยรังสิต ปริญญาวิศวกรรมศาสตรบัณฑิต
| สาขาวิศวกรรมคอมพิวเตอร์, 2569
