supachokchujai/glove-sign-languag-/(commit log)

2026-08-22 feat: initial commit — smart glove sign-language translator
    完整的 Python + Arduino ระบบแปลภาษามือครบวงจร:
    - ESP32 firmware (UDP, flex + MPU6050)
    - savedata1.py (data recording with timing & gap detection)
    - train_model3.py (MLP 256-128, npz/joblib preferred)
    - monitor scripts + Flask web app
    - unit tests (14 tests)
    - requirements, README, .gitignore, .gitattributes
    🤖 Generated with Codebuff
    [config.h, main.ino]
2026-09-09 fix: bind UDP socket once at startup instead of per request in web.py
    - Reuse a single socket across requests so predict works repeatedly
    without re-binding port 4210
    - Fail fast at startup with a clear message if the port is already taken
    - Drop SO_REUSEADDR: on Windows it lets a second socket silently steal
    the port instead of raising
    - Disable the debug reloader (it spawns a second process fighting over
    the UDP socket)
    - Add a recording lock and drain stale UDP packets before each capture
    - Add tests/test_web.py covering all of the above (19 tests total)
    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
2026-09-19 docs: add project report PDF (thesis.pdf) and link it from README
    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
2026-09-19 docs: enrich README with thesis data — 31 classes, hardware pin map, MLP specs, 96.02% test accuracy
    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
2026-09-19 docs: add hardware photos and confusion matrix from thesis to README
    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
2026-09-19 fix: track docs/confusion_matrix.png referenced by README (ignore only root artifact)
    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
2026-09-19 docs: remove confusion matrix image from README per feedback
    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
